JuanenRac/URTC/README_ita.md

<p align="center">
  URTC banner
</p>

# 🚀 URTC — Universal Robot Tool Controller

<p align="center">
  <a href="README.md">🇺🇸 English</a> |
  <a href="README_spa.md">🇪🇸 Español</a> |
  <a href="README_fra.md">🇫🇷 Français</a> |
  🇮🇹 <b>Italiano</b> |
  <a href="README_deu.md">🇩🇪 Deutsch</a> |
  <a href="README_zho.md">🇨🇳 简体中文</a> |
  <a href="README_jpn.md">🇯🇵 日本語</a> |
  <a href="README_por.md">🇵🇹 Português</a>
</p>

### Il controllore delle teste utensile di un braccio robotico: una scheda STM32F303 con 25 profili utensile su CAN, un bootloader CAN e uno slave di espansione

<p align="center">
  
  
  
  
  
  
</p>

---

**Stato: 🚧 Progetto in evoluzione attiva — esistono release, ma nulla è mai stato eseguito su una scheda reale.** Esistono release con tag (v0.3.x), ciascuna con le immagini firmware compilate da questo codice sorgente, ma non esiste alcuna scheda popolata, quindi il firmware non è mai stato eseguito su una scheda reale. URTC è in sviluppo continuo e attivo su entrambi i fronti contemporaneamente: firmware (nuovi profili strumento, l'ecosistema di espansione slave, cambi di protocollo) e hardware (schematico e distinta base ancora in fase di finalizzazione, nessuna scheda popolata esiste ancora). Poiché entrambi i lati si muovono insieme, ciò che si trova in questo repository in un dato momento è un'istantanea del lavoro in corso, non un prodotto stabile e versionato - nomi di file, struttura delle cartelle, numero di strumenti, e documentazione possono ancora tutti cambiare man mano che il progetto si assesta. Una volta che sia firmware che hardware raggiungeranno uno stato genuinamente stabile e verificato su hardware reale, verrà taggata una vera **Release** che raggrupperà tutto insieme (firmware, bootloader, strumenti PC, file di progettazione hardware, e documentazione) come un'istantanea coerente e congelata. Fino ad allora, considera `main` come l'obiettivo in continuo movimento che è.

---

> **⚠️ Avviso di sicurezza (fase di progetto, nessuna scheda ha ancora eseguito questo firmware):** questa scheda pilota un **diodo laser da incisione da 10 W** e più stadi di riscaldamento (cartuccia per saldatore T12, hotend per stampante 3D). Costruirla e usarla significa lavorare con apparecchiature che possono causare **ustioni, incendi o danni agli occhi** se assemblate o utilizzate senza le adeguate misure di sicurezza (occhiali protettivi con classificazione adatta alla lunghezza d'onda del diodo, protezione termica, un interruttore di alimentazione accessibile). Questo è un progetto hobbistico/maker condiviso così com'è - costruiscilo e usalo a tuo rischio, e non saltare le pratiche di sicurezza di base solo perché il firmware ha dei watchdog (watchdog software mai eseguiti su una scheda reale).

> **Stato di sicurezza (safety e security):** questo ecosistema non è un sistema di sicurezza certificato e non esiste ancora alcuna scheda URTC assemblata. Il bootloader della scheda principale verifica le immagini firmware con CRC32 e una firma Ed25519 rispetto a una tabella di chiavi pubbliche e non custodisce alcun segreto; il bootloader dell'espansione slave controlla CRC32 e un SHA-256 senza chiave e installa solo un'immagine che la scheda principale, che verifica il record Ed25519, gli ha confermato tramite il bus di collegamento interno (si fida della scheda principale attraverso quel bus). La tabella della build ufficiale è vuota finché non viene creata la chiave di firma delle immagini, quindi un bootloader principale ufficiale non installa ancora nulla, e una build da banco si fida di una chiave pubblica di sviluppo, così chiunque può produrre un'immagine che un tale bootloader accetta; nulla è stato trasmesso a una scheda reale. Leggi la [base di sicurezza](https://github.com/JuanenRac/URTC-DOCS/blob/main/docs/SECURITY_BASELINE.md) e il [modello delle minacce](https://github.com/JuanenRac/URTC-DOCS/blob/main/docs/THREAT_MODEL.md) prima di fidarti di qualsiasi affermazione qui per la sicurezza di una persona.

## 📋 In breve

| | |
|---|---|
| Versione | `0.4.9` |
| Maturità | Funzionale |
| Tecnologia | STM32F303 / bxCAN / 25 tool profiles |
| Destinazione | Una scheda con microcontrollore (il firmware); compilato su un PC |
| Su hardware reale | Non ancora: per questa versione non risulta alcuna esecuzione su hardware reale |

**Vai a:** [Panoramica](#-panoramica) · [Architettura](#-architettura) · [Funzionalità](#-funzionalità) · [Sicurezza](#-sicurezza-e-protezione) · [Interfacce](#-interfacce) · [Avvio rapido](#-avvio-rapido) · [Test](#-test) · [Struttura](#-struttura-del-repository) · [Correlati](#-progetti-correlati)

<!-- urtc-section:status_firmware -->
## 🚦 Stato del progetto

🟢 fatto e verificato · 🟡 funziona, con limiti noti · 🟠 a metà o non verificato · 🔴 non fatto o non funzionante. Nulla è verde se non ha mai girato su hardware reale.

| Parte | Stato | Ciò che il repository può dimostrare |
| --- | :---: | --- |
| Software | 🟡 | Compila e supera i test su PC; la prova su una testa utensile reale è ancora da fare. |
| Test | 🟢 | La suite di test passa nella CI a ogni push. |
| Hardware reale | 🟠 | Nessuna esecuzione su una scheda reale: la prova al banco è ancora da fare. |
| Sicurezza | 🟡 | Le versioni sono firmate con Ed25519 e verificate prima dell'uso; la gestione delle chiavi non è stata rivista da nessun altro. |
| Interfaccia e protocolli | 🟡 | Le rotte o i messaggi offerti sono documentati e provati con un client; non tutti i client li hanno ancora usati |
| Aggiornamenti | 🟠 | Le immagini si aggiornano sul bus CAN con il bootloader; un aggiornamento firmato, una firma alterata e un id hardware estraneo sono provati con il bootloader compilato per il PC, mai su una scheda |
| Documentazione | 🟡 | README in otto lingue e documenti di riferimento; le traduzioni non sono state riviste da madrelingua. |

<!-- /urtc-section:status_firmware -->

## 🎯 Panoramica

Ciao a tutti! Volevo condividere un progetto a cui sto lavorando chiamato URTC (Universal Robot Tool Controller). È una scheda di controllo monolitica e altamente integrata, progettata specificamente per espandere le capacità di bracci robotici e impianti di automazione, il che la rende perfetta per piattaforme come PAROL6 e Faze4 - due bracci robotici open-source progettati e sviluppati da [Source-Robotics](https://source-robotics.com/) ([GitHub](https://github.com/Source-Robotics)).

**URTC è un progetto indipendente e non ufficiale.** Non è sviluppato né approvato da Source-Robotics - è un controller di tool-head compatibile, costruito per funzionare bene con PAROL6 e Faze4, e la stessa architettura basata su CAN è aperta ad essere adattata anche ad altre piattaforme di bracci robotici.

Qui trovi la descrizione completa di cosa sia, cosa faccia, e l'ecosistema hardware che attualmente gestisce.

URTC è una scheda di controllo tutto-in-uno e compatta, alimentata da un microcontrollore STM32 (STM32F303CCT6, LQFP48). Comunica con il controller principale del robot via bus CAN, pensata per eseguire con bassa latenza compiti complessi direttamente al tool-head o all'asse (la latenza non è mai stata misurata su una scheda e non si promette un vero tempo reale). Include un display OLED integrato per diagnostica istantanea - splash di avvio animato, icone animate per ogni strumento, telemetria dal vivo su un pannello a due toni - un singolo LED RGB di stato più un anello di LED RGB indirizzabili per l'illuminazione della fotocamera, un connettore di espansione a 20 pin per schede aggiuntive, una F-RAM integrata che mantiene i setpoint dello strumento attivo attraverso una perdita di alimentazione, e stadi di alimentazione dedicati, analogici e ad alta corrente.

## 🧩 Ruolo in URTC

URTC è la scheda e il suo firmware: la parte dell'ecosistema che sta sulla testa utensile del robot e fa il lavoro, con un bootloader CAN che permette di aggiornare l'applicazione con lo stesso cavo. Tutto il resto della famiglia è costruito intorno ad essa. URTC-COMMON scrive il suo protocollo CAN una volta sola come dati, URTC-FLASHER e URTC-TESTER la aggiornano e la esercitano da un PC (URTC-WEB-STUDIO fa entrambe le cose in un browser), URTC-GATEWAY può mettersi davanti al suo bus, URTC-SMART-RACK custodisce le teste, URTC-VISION-TOOL è una testa che ispeziona, URTC-UPDATER tiene aggiornati i programmi e URTC-DOCS conserva l'architettura e ciò che è provato. È pensata per bracci robotici come PAROL6 e Faze4 ed è un progetto indipendente e non ufficiale. Non esiste ancora nessuna scheda montata.

## 🏛️ Architettura

<p align="center">
  Architettura di URTC: chi lo usa, che cosa contiene e da che cosa dipende
</p>

Come si incastrano le parti di questo repository: chi lo usa, che cosa contiene e da che cosa dipende. L'immagine è disegnata da `docs/architecture.json` e verificata rispetto al codice.

### Architettura Scalabile e Matrice degli Strumenti

Il punto di forza principale di URTC è la sua estrema versatilità. Invece di sostituire l'elettronica per ogni lavoro diverso, la scheda presenta un'architettura a matrice scalabile:

* **Schema di identificazione a 32 indirizzi:** l'hardware e il protocollo di comunicazione sono progettati per identificare fino a 32 strumenti o end-effector diversi direttamente sulla testa del robot, tramite una matrice ID a jumper di saldatura a 5 bit (ID0-ID4). Di queste 32 letture, 31 mappano direttamente su un profilo strumento; la 32ª (tutti e 5 i jumper installati, `11111`) è riservata invece come indirizzo di "configurazione libera" - vedi sotto.
* **25 profili automatizzati plug-and-play:** il firmware gestisce nativamente 25 profili strumento - la scheda legge l'identità fisica del tool-head e configura gli stadi di alimentazione, i sensori, e la commutazione logica senza soluzione di continuità, senza necessità di un ri-flash completo. 6 indirizzi in più rimangono liberi nello schema esistente per futuri profili strumento.
* **Configurazione libera dello strumento:** la lettura riservata dei jumper `11111` non seleziona uno strumento fisso - dice alla scheda di ricercare quale strumento usare da un registro nella propria F-RAM persistente, impostato in anticipo via CAN (tramite `URTC Flasher`). Utile per una scheda che necessita di essere riprogrammata su uno strumento diverso senza risaldare fisicamente i jumper. Vedi `docs/EEPROM.TXT` sezione 5 per il meccanismo completo.

### Struttura della memoria flash (256K totali, modello di aggiornamento golden-image / A-B)

```
0x08000000 ┌─────────────────────────────────┐
           │  Bootloader (30K)                 │  Viene sempre eseguito per primo ad ogni avvio.
           │                                   │  Ascolta brevemente sul CAN, poi o
           │                                   │  salta all'app o attende un
           │                                   │  aggiornamento. Pilota l'OLED direttamente
           │                                   │  durante un aggiornamento (vedi sotto).
0x08007800 ├─────────────────────────────────┤
           │  Pagina metadati (2K)             │  Descrive qualsiasi cosa si trovi nello
           │                                   │  slot principale in questo momento: HardwareID,
           │                                   │  versione, dimensione, CRC32, e una
           │                                   │  firma SHA-256. Il
           │                                   │  bootloader verifica tutto questo
           │                                   │  prima di saltare mai all'app.
0x08008000 ├─────────────────────────────────┤
           │  Slot principale (112K)           │  Questo è il firmware applicativo /
           │                                   │  URTC_MAIN_FIRMWARE_v<version>.* — il firmware
           │                                   │  vero e proprio che gira giorno per giorno,
           │                                   │  descritto ovunque altrove in
           │                                   │  questo README. Mai toccato da
           │                                   │  un aggiornamento finché un'immagine
           │                                   │  verificata e nota come funzionante non è
           │                                   │  pronta a sostituirlo.
0x08024000 ├─────────────────────────────────┤
           │  Slot backup / staging (112K)     │  Solo archiviazione grezza, mai
           │                                   │  eseguito direttamente. Ogni
           │                                   │  aggiornamento CAN scrive qui per primo.
0x08040000 └─────────────────────────────────┘
```

**Perché uno slot di backup.** Un aggiornamento CAN non viene mai scritto nello slot attualmente in esecuzione. Va prima nel backup, viene completamente verificato lì - dimensione, CRC32, e una firma Ed25519 verificata rispetto alla tabella di chiavi pubbliche del bootloader, che mostra che è stato prodotto da chi possiede una chiave fidata, non solo che sia arrivato intatto - e solo dopo viene copiato nello slot principale. Una perdita di alimentazione in qualsiasi punto prima che quella copia inizi lascia il firmware attualmente in esecuzione completamente intatto, quindi non c'è finestra in cui un download interrotto possa rendere inutilizzabile la scheda. Se la perdita di alimentazione avviene *durante* la copia stessa, il bootloader se ne accorge al successivo avvio (il backup, mai toccato durante la copia, è ancora completamente intatto) e semplicemente riprende a copiare da lì finché non ha successo.

## 🖼️ Schermate

URTC v1.0

*(Lavoro in corso — altre angolazioni e una scheda popolata in arrivo presto.)*

## ✨ Funzionalità

### Flessibilità Hardware e Supporto Motori

Per gestire una varietà così ampia di applicazioni, l'hardware URTC è pienamente equipaggiato per controllare:

* **Motori passo-passo NEMA:** NEMA 8, 11, 14, e 17 funzionano direttamente sul TMC2209 integrato, così come NEMA 23 e 34 - fino a **2,0 A** su ciascuno di essi tramite lo stadio driver della scheda principale. Per NEMA 23/34 alla loro piena coppia nominale, un TMC5160 sul connettore di espansione (vedi sotto) supporta fino a **10 A**, scalati in corrente dai MOSFET/resistenza di sense esterni scelti per quella scheda - il limite integrato di 2,0 A non si applica una volta che un motore è stato spostato sul driver di espansione.
* **Motori BLDC trifase / gimbal** per movimento ad alta precisione.
* **Motori con sensori Hall e tachimetri** per controllo a circuito chiuso.
* **Ingressi dedicati** per sensori di prossimità ottici riflettenti come il TCRT5000, più un ingresso generico attivo-basso per finecorsa/limit-switch condiviso tra quattro profili strumento.

### Connettore di Espansione

Un header a 20 pin, separato dai connettori specifici per strumento, per schede aggiuntive che necessitano più di quanto un dato profilo strumento da solo esponga - un asse a passo aggiuntivo (TMC2209 o TMC5160), una seconda scheda sensore, cose di questo tipo.

| Pin | Segnale |
|---|---|
| 4 | 24 V |
| 1 | 3,3 V |
| 1 | 5 V |
| 3 | GND |
| 2 | I2C bit-banged (SCL/SDA) — proprio bus separato, distinto dall'I2C2 hardware di OLED/F-RAM |
| 3 | STEP/DIR/EN — universale per entrambi i chip driver sotto |
| 4 | SPI bit-banged (CS/SCK/MISO/MOSI) — per l'interfaccia di configurazione/diagnostica di un TMC5160, o qualsiasi altro chip configurabile via SPI |
| 1 | GPIO generico (ingresso di interrupt capace di EXTI se un futuro add-on necessita una risposta sensore rapida, es. un finecorsa) |
| 1 | TMC5160 DIAG0 (linea di diagnostica stallo/guasto, interrogata via `0x182`/`0x183`) |

20 pin totali.

**Due bus I2C separati, di proposito:** OLED/F-RAM usano l'unica periferica hardware I2C utilizzabile di questo chip (I2C2, su PA9/PA10); il connettore di espansione ottiene il proprio bus I2C bit-banged, indipendente (PB10/PB11 - le uniche altre coppie di pin capaci di I2C su questo chip erano già impegnate per altre funzioni, quindi il bit-banging era il modo per dare a questo connettore un proprio bus senza un conflitto hardware). Qualsiasi cosa collegata all'header di espansione - un ADC/DAC I2C, un port expander, qualsiasi cosa una data scheda add-on necessiti - condivide questo bus bit-banged con qualsiasi altro dispositivo I2C lato espansione, ma non può allungare il clock (clock stretching) né altrimenti interferire con la temporizzazione propria dell'OLED sul suo bus hardware separato I2C2.

**Un TMC2209 o un TMC5160, non necessariamente entrambi.** Entrambi i chip usano la stessa interfaccia STEP/DIR/EN per il movimento vero e proprio, quindi quella parte è universale. Dove differiscono è nella configurazione/diagnostica: un TMC2209 usa la propria UART a filo singolo per questo, mentre un TMC5160 usa SPI - e poiché i due sono mutuamente esclusivi su una data scheda di espansione, i 4 pin SPI fungono anche naturalmente da sede per la linea UART singola di un TMC2209, invece di richiedere un ulteriore pin dedicato che nessuno userebbe contemporaneamente al bus SPI. Il bus SPI bit-banged parla esattamente il protocollo che un TMC5160 si aspetta (SPI Modalità 3, MSB per primo, CS mantenuto basso per l'intera transazione - vedi `0x180`/`0x181` in `docs/CANBUS.TXT` per il comando generico di byte-passthrough che lo pilota) invece che questo firmware debba conoscere il layout specifico dei registri di quel chip. Anche la linea DIAG0 di stallo/guasto di un TMC5160 è cablata (`0x182`/`0x183`) - riutilizza uno dei due pin GPIO generici, che erano già stati destinati esattamente a questo tipo di ingresso rapido guidato da interrupt.

Il dettaglio completo pin per pin - quale pin dell'MCU sostiene quale segnale, e il ragionamento dietro un paio di vincoli di layout che il package a 48 pin di questo chip ha - vive in `docs/PINOUT_CONNECTORS.TXT` e `src/F303-master/README.md`.

#### Le 6 varianti di scheda di espansione

4 delle 6 varianti di scheda di espansione portano un driver per motore passo-passo - o un TMC2209 (fino a 2A/bobina, MOSFET di potenza integrati) o un TMC5160A (fino a 10A+/bobina, richiede 8 MOSFET di potenza esterni che il driver stesso non include). Indipendentemente da questa scelta di driver, una scheda con driver è o **basic** (driver + connettori soltanto, nessun MCU - STEP/DIR/EN instradati direttamente dalla scheda principale) o **advanced** (aggiunge un secondo microcontrollore, STM32F303CBT6, più 2 chip sensore locali - un ADC 16-bit ADS1115 e una termocamera della famiglia MLX9064x - e generazione locale di PWM per strumenti la cui temporizzazione necessita di essere generata direttamente sul tool-head anziché instradata via cavo). 2×2 combinazioni, più altre 2 schede basic solo-sensore (ADS1115 o MLX9064x, cablate direttamente allo STM32F303CC della scheda principale stessa, nessun driver e nessun MCU slave) per uno strumento che necessita solo di uno di quei 2 chip e nient'altro che una scheda advanced porta anch'essa - 6 schede in totale - vedi `BOM/BOM_EXPANSION_*.TXT` (6 file), `docs/EXPANSION.TXT`, e `docs/PINOUT_SLAVE.txt`.

Lo STM32F303CBT6 della variante advanced parla con la scheda principale attraverso il bus I2C bit-banged esistente del connettore di espansione sopra - scheda principale come master, chip slave che risponde come vero slave hardware I2C - e pilota il proprio secondo bus I2C, solo locale, per i 2 chip sensore. Ha un proprio bootloader e firmware applicativo, aggiornato allo stesso modo della scheda principale (CAN-OTA da `URTC Flasher`), semplicemente ritrasmesso attraverso quel collegamento I2C piuttosto che raggiungendo direttamente il chip slave. Vedi `src/F303-slave/README.md` e `src/F303-slave/boot/README.md` per il dettaglio tecnico completo.

### Persistenza dei Parametri

Una F-RAM FM24CL64B integrata (64Kbit, I2C) mantiene un'istantanea aggiornata periodicamente dei setpoint dello strumento attivo e delle impostazioni globali di LED/OLED, così una perdita improvvisa di alimentazione non lascia "cosa stava facendo questa scheda" tanto ignoto quanto lo era stata la perdita stessa, imprevista. Condivide il bus hardware I2C2 dell'OLED anziché ottenerne uno proprio - questo MCU ha una sola periferica hardware I2C utilizzabile per questo scopo, già impegnato dall'OLED (vedi `src/F303-master/README.md` sezione 6 per il ragionamento completo).

**Lo stato recuperato è interrogabile, mai applicato automaticamente a nulla di pericoloso.** All'avvio, qualsiasi cosa fosse stata salvata diventa leggibile via CAN (`0x190`/`0x191`) - ma un setpoint del riscaldatore, la potenza del laser, o un comando motore non vengono mai riarmati silenziosamente da soli. Solo le impostazioni sicure e passive (colori LED, modalità OLED) vengono ripristinate direttamente. Reinviare deliberatamente un setpoint dopo aver effettivamente esaminato cosa sia successo resta una decisione del controller master, non qualcosa che questa scheda decide da sola nell'istante in cui torna l'alimentazione.

### Catalogo Strumenti Automatizzati Nativamente (25 Profili Firmware)

Tramite la sua logica di commutazione dinamica, il firmware gestisce nativamente i seguenti tool-head:

1. **Stazione Saldante (T12):** controllo di temperatura con isteresi (on/off, non PID) usando feedback ADC diretto per gestire punte saldanti T12 standard, più un alimentatore motorizzato di filo che spinge il filo di stagno nel giunto (condivide `CONN_MOT` e il proprio protocollo stepper con gli strumenti a solo movimento sotto - cede il proprio ingresso finecorsa generico per fargli spazio). [Config jumper/cablaggio →](images/TOOL_SOLDERING_IRON.png)
2. **Dispenser di Pasta Saldante SMT:** controllo di alimentazione millimetrico per deposizione precisa di pasta saldante su PCB. [Config jumper/cablaggio →](images/TOOL_PASTE_DISPENSER.png)
3. **Dispenser di Pasta Termica / Liquido:** gestione della fluidità per paste ad alta viscosità o adesivi liquidi. [Config jumper/cablaggio →](images/TOOL_LIQUID_DISPENSER.png)
4. **Cacciavite Elettrico Intelligente:** controllo di rotazione e arresto tramite l'interfaccia stepper. Previsto: arresto su limiti di coppia (non esiste ancora alcuna misura della coppia). [Config jumper/cablaggio →](images/TOOL_SCREWDRIVER.png)
5. **Pinza a Vuoto / Pneumatica:** controllo della pompa a vuoto e lettura del livello di pressione per operazioni sicure di Pick-and-Place. [Config jumper/cablaggio →](images/TOOL_VACUUM_PICKUP.png)
6. **Trapano (BL4260):** controllo di velocità PWM, inversione di direzione, e frenata elettrica dinamica con letture RPM dal vivo, sulla propria linea dedicata di enable/freno, indipendente dall'enable del driver stepper. Ingresso finecorsa generico disponibile. [Config jumper/cablaggio →](images/TOOL_DRILL.png)
7. **Pinza Gimbal:** manipolazione ad alta sensibilità usando motori brushless gimbal trifase. [Config jumper/cablaggio →](images/TOOL_GRIPPER_GIMBAL.png)
8. **Pinza NEMA:** forza di serraggio robusta controllata tramite un motore stepper heavy-duty. [Config jumper/cablaggio →](images/TOOL_GRIPPER_NEMA.png)
9. **Sistema AOI (Ispezione Ottica Automatizzata):** controllo stroboscopico sincrono dell'array LED di illuminazione per la cattura della fotocamera di visione artificiale. Ingresso finecorsa generico disponibile. [Config jumper/cablaggio →](images/TOOL_AOI_INSPECTION.png)
10. **Diodo Laser da Incisione (10W ottici):** modulazione PWM della potenza del fascio con un watchdog CAN software che blocca l'uscita laser se la comunicazione con l'host viene persa (compilato, mai eseguito su una scheda reale e non sostituisce un interblocco hardware indipendente). Ingresso finecorsa generico disponibile. [Config jumper/cablaggio →](images/TOOL_LASER_ENGRAVER.png)
11. **Hotend di Stampa 3D:** controllo on/off con isteresi della cartuccia riscaldante, lettura del termistore NTC, controllo dell'estrusore, e una ventola dedicata di raffreddamento layer controllata via PWM a 25kHz (4 fili, feedback tachimetrico, watchdog di comunicazione proprio) - tutto integrato in un unico blocco. [Config jumper/cablaggio →](images/TOOL_3D_PRINTER.png)
12. **Sonda per Scanner 3D:** ingresso hardware a interrupt ultra-rapido (EXTI) con priorità assoluta per digitalizzazione della superficie in tempo reale e rilevamento urti senza ritardo. Copre anche il tastatore metrologico - stesso percorso hardware, una sonda fisica diversa sullo stesso tool-head. [Config jumper/cablaggio →](images/TOOL_SCAN_PROBE.png)
13. **Testa Pick & Place SMT:** asse rotativo A per il corretto allineamento dei pad, sulla stessa interfaccia stepper dei dispenser pasta/liquido e di entrambe le pinze sopra. [Config jumper/cablaggio →](images/TOOL_SMT_PICKPLACE.png)
14. **Elettromagnete Heavy-Duty:** controllo di presa on/off per parti ferromagnetiche, dall'uscita del riscaldatore T12 riutilizzata come driver GPIO generico. [Config jumper/cablaggio →](images/TOOL_ELECTROMAGNET.png)
15. **Testa Saldatrice a Punti:** impulsi di saldatura con precisione al millisecondo per strisce di nickel di battery-pack, con un sensore di contatto superficiale che regola l'impulso. [Config jumper/cablaggio →](images/TOOL_SPOT_WELDER.png)
16. **Aerografo per Coating Conforme:** controllo dello spray di rivestimento protettivo per PCB finiti - la valvola dello spray e il proprio sensore si trovano sulla scheda madre del robot, fuori dall'ambito di questa scheda. [Config jumper/cablaggio →](images/TOOL_CONFORMAL_COATING.png)
17. **Pinza a Vuoto per Grande Formato:** array multi-ventosa per schede FR4 non popolate, sulla stessa interfaccia stepper dello strumento #13 sopra. [Config jumper/cablaggio →](images/TOOL_VACUUM_GRIPPER_LG.png)
18. **Testa di Test Funzionale:** test di tensione/continuità a sonda volante - lettura base tramite l'ADC integrato, lettura avanzata tramite un ADC 16-bit ADS1115 su una scheda di espansione **advanced**. [Config jumper/cablaggio →](images/TOOL_FLYING_PROBE.png)
19. **Testa di Cura UV:** driver LED UV ad alta potenza per la cura istantanea di colla/maschera. [Config jumper/cablaggio →](images/TOOL_UV_CURING.png)
20. **Ugello per Rilavorazione ad Aria Calda:** elemento riscaldante, soffiatore a turbina, e feedback della termocoppia per rifusione di componenti SMD disallineati - condivide il proprio loop di controllo termico con il saldatore. [Config jumper/cablaggio →](images/TOOL_HOTAIR_REWORK.png)
21. **Inseritore Pneumatico Press-Fit:** controllo attuatore lineare per pressare connettori nei PCB - l'attuatore e il proprio sensore si trovano sulla scheda madre del robot, fuori dall'ambito di questa scheda. [Config jumper/cablaggio →](images/TOOL_PRESSFIT_INSERTER.png)
22. **Attuatore di Cablaggio/Crimpatura:** ganascia ad alta coppia per spellare/crimpare terminali, pilotata dal driver proprio di una **scheda di espansione** piuttosto che da quello della scheda principale. Il firmware non ha alcuna misura di coppia o di forza. [Config jumper/cablaggio →](images/TOOL_CRIMPING_ACTUATOR.png)
23. **Ispezione Avanzata PCB:** termografia (array della famiglia MLX9064x - tutti e 3 i membri della famiglia, MLX90640/MLX90641/MLX90642, supportati oggi, sia tramite il chip slave proprio di una scheda di espansione **advanced** sia tramite una scheda di espansione **basic** MLX9064x cablata direttamente alla scheda principale) per individuare cortocircuiti tramite firma termica, insieme all'illuminazione ad anello LED. Copre anche la depanellizzazione con micro-mandrino - stesso percorso hardware del trapano sopra, un bit diverso per un lavoro diverso. [Config jumper/cablaggio →](images/TOOL_THERMAL_INSPECTION.png)
24. **Valvola di Jetting Pasta Saldante:** erogazione micro-goccia piezoelettrica, precisione di impulso sub-millisecondo generata localmente su una scheda di espansione **advanced**. [Config jumper/cablaggio →](images/TOOL_PASTE_JETTING.png)
25. **Saldatrice a Ultrasuoni / Sigillatrice per Confezionamento:** trigger a trasduttore ad alta frequenza per saldatura di involucri in plastica. [Config jumper/cablaggio →](images/TOOL_ULTRASONIC_WELDER.png)

*(Le immagini di configurazione strumento esistono per gli strumenti 1-12; le immagini per gli strumenti 13-25 verranno popolate man mano che la documentazione hardware si aggiorna - i nomi file sopra corrispondono alla convenzione di denominazione già in uso in `images/`.)*

### Interfaccia OLED Locale

Ogni tool-head mostra telemetria dal vivo, specifica per lo strumento, su un OLED a due toni 128×64: uno splash di avvio animato all'accensione, un indicatore lampeggiante di attività CAN, una lettura "hero" dal vivo nella striscia superiore (temperatura, RPM, potenza - qualsiasi cosa sia più importante per lo strumento attivo), e una piccola icona animata a quattro fotogrammi per profilo strumento.

#### Il modulo

Entrambe le varianti fisiche sotto sono lo stesso pannello elettricamente (pilotato da SSD1306 o SSD1315 - la sequenza di init del firmware è verificata compatibile con entrambi, vedi `OLED_Init()` in `firmware_oled_driver.c`; l'SSD1315 è un controller sostitutivo più recente, drop-in, con cui molti moduli vengono venduti oggi sotto lo stesso listino/serigrafia "SSD1306"), **128×64**, e la stessa suddivisione a due toni "giallo/blu", dove il materiale LED fisico stesso è diviso in due zone a colore fisso (questo non è selezionabile via software):

* **16 pixel superiori (pagine 0-1): giallo.** URTC usa questa striscia per qualsiasi cosa sia più utile vedere a colpo d'occhio senza leggere attentamente - l'indicatore di attività CAN, letture hero dal vivo, o (sullo splash di avvio / schermate di strumento non valido) breve testo di stato.
* **48 pixel inferiori (pagine 2-7): blu.** Tutto il resto - icone strumento, telemetria dettagliata, il volto animato JuanenBOT sulla schermata splash, la grande scritta lampeggiante ERROR.

Entrambi finiscono sullo stesso bus I2C2 e sullo stesso `OLED_Init()` - il firmware non può distinguere quale dei due sia collegato, e non ne ha bisogno. Sono mutuamente esclusivi su una data scheda (vedi la nota di `CONN_OLED2` in `BOM/BOM.TXT` - il nome usato in questo documento per ciò che lo schematico chiama `LCD1`).

##### Opzione A — montaggio diretto (`CONN_OLED2`, il footprint effettivamente popolato sulla scheda)



Un pannello nudo senza scheda breakout separata - solo il vetro e il suo nastro FPC a 30 pin, saldato direttamente nel footprint `CONN_OLED2` (`FPC30`, WiseChip UG-2864, il nome usato in questo documento per ciò che lo schematico chiama `LCD1` - vedi `BOM/BOM.TXT` e `URTC_NETLIST.TXT`). Dei 30 pin, solo un sottoinsieme è effettivamente cablato - il resto è il bus a interfaccia parallela del pannello (`D2`–`D7`, `RW`, `E/!RD`), lasciato non connesso poiché la scheda parla con esso solo via I2C:

| Pin(s) di CONN_OLED2 | Rete | Funzione |
|---|---|---|
| 1, 8, 29, 30 | GND / AGND | Massa |
| 9 | VDD | Alimentazione logica (da `+3V3B`, la rail dedicata solo all'OLED - vedi BOM §1) |
| 28 | VCC | Alimentazione pannello |
| 2–5 | C2P/C2N/C1P/C1N | Condensatori charge-pump — `C26`/`C27` nella distinta base |
| 26 | IREF | Resistore di impostazione corrente di riferimento |
| 27 | VCOMH | Disaccoppiamento tensione comune interna |
| 10, 12 | BS0, BS2 | Collegati a GND |
| 11 | BS1 | Collegato a `+3V3B` |
| 18 | D0/SCK | I2C2 SCL — PA9 |
| 19 | D1/DIN/SDA | I2C2 SDA — PA10 |

`BS0`/`BS1`/`BS2` sono lo strap proprio di selezione interfaccia del pannello (GND/VCC/GND qui), fisso via hardware anziché esposto all'MCU - è questo che mette il controller in modalità I2C fin dall'inizio, anziché nella modalità parallela 8080/6800 a cui appartengono gli altri 22 pin FPC.

##### Opzione B — modulo breakout (`CONN_OLED`, alternativa esterna)



Lo stesso pannello pre-montato su una piccola scheda carrier con un header a 4 pin - utile se preferisci cablare un modulo pronto all'uso piuttosto che procurarti il pannello FPC nudo. Cablato direttamente a `CONN_OLED` senza necessità di incrocio - l'ordine dei pin proprio del modulo (`GND · VDD · SCK · SDA`) corrisponde esattamente, pin per pin, al pinout di `CONN_OLED`:

| Pin modulo OLED | Pin CONN_OLED | Segnale |
|---|---|---|
| GND | 1 | Massa |
| VDD | 2 | +3,3 V (alimentazione logica display) |
| SCK | 3 | SCL — PA9, I2C2 hardware |
| SDA | 4 | SDA — PA10, I2C2 hardware |

#### Splash di avvio



#### Icone strumenti (una per profilo, animazione a 4 fotogrammi)

<table>
<tr>
<td align="center"><br>Saldatore T12</td>
<td align="center"><br>Dispenser Pasta</td>
<td align="center"><br>Dispenser Liquido</td>
<td align="center"><br>Cacciavite</td>
</tr>
<tr>
<td align="center"><br>Pinza a Vuoto</td>
<td align="center"><br>Trapano (BL4260)</td>
<td align="center"><br>Pinza Gimbal</td>
<td align="center"><br>Pinza NEMA</td>
</tr>
<tr>
<td align="center"><br>Ispezione AOI</td>
<td align="center"><br>Incisore Laser</td>
<td align="center"><br>Hotend Stampante 3D</td>
<td align="center"><br>Sonda Scanner 3D</td>
</tr>
<tr>
<td align="center"><br>SMT Pick & Place</td>
<td align="center"><br>Elettromagnete</td>
<td align="center"><br>Saldatrice a Punti</td>
<td align="center"><br>Coating Conforme</td>
</tr>
<tr>
<td align="center"><br>Pinza a Vuoto (LG)</td>
<td align="center"><br>Sonda Volante</td>
<td align="center"><br>Cura UV</td>
<td align="center"><br>Rilavorazione Aria Calda</td>
</tr>
<tr>
<td align="center"><br>Inseritore Press-Fit</td>
<td align="center"><br>Attuatore Crimpatura</td>
<td align="center"><br>Ispezione Termica</td>
<td align="center"><br>Jetting Pasta</td>
</tr>
<tr>
<td align="center"><br>Saldatrice Ultrasuoni</td>
</tr>
</table>

#### Avviso ID strumento non valido

Se i jumper ID non corrispondono a nessuno dei 25 profili assegnati, la scheda blocca ogni attuatore e lampeggia invece questo:



Tutte le GIF sorgente delle animazioni vivono in [`/ani`](ani/).

### LED di Stato Digitale

Separato dall'OLED e dall'anello di illuminazione a 8 pixel, `CONN_LED1` porta un singolo LED RGB indirizzabile (famiglia WS2812B, pilotato via SPI/DMA) dedicato allo stato a colpo d'occhio.

**Automatico di default, sovrascrivibile dall'host a richiesta.** Il firmware colora questo LED da solo, con priorità a tre vie:

* 🔴 **Rosso** — un guasto hardware è attivo (`system_error_flag`). Vince sempre, indipendentemente da qualsiasi altra cosa in corso.
* 🔵 **Blu** — la scheda sta funzionando attivamente: un frame CAN (qualsiasi ID) è arrivato negli ultimi 1,5 secondi.
* 🟢 **Verde** — inattiva, in attesa di comandi: nessun traffico CAN da oltre 1,5 secondi.

Il master può comunque sovrascrivere questo in qualsiasi momento inviando l'ID CAN `0x100` (DLC 8) con l'intensità di rosso, verde, e blu come primi tre byte (0-255 ciascuno - colore 24-bit completo, non solo i tre automatici). Un colore inviato dall'host resta attivo per 10 secondi prima di tornare allo schema automatico - abbastanza lungo da essere effettivamente visto, abbastanza breve perché la scheda non resti bloccata a mostrare un colore personalizzato obsoleto se l'host smette di aggiornarlo. Inviare di nuovo `0x100` (sia lo stesso colore che uno nuovo) rinnova questa finestra di 10 secondi, quindi un host che vuole mantenere il controllo personalizzato deve semplicemente continuare a inviarlo periodicamente. Un guasto hardware interrompe sempre un override attivo - il rosso ha priorità su qualsiasi colore che l'host avesse impostato.

Vedi `docs/CANBUS.TXT` (ID `0x100`) per il layout esatto dei byte, che condivide anche questo stesso messaggio con il controllo dell'anello LED e della modalità notturna dell'OLED.

## 🔒 Sicurezza e protezione

- **Protezione dalla fuga termica** (`thermal_guard.c`, dall'applicazione 0.3.2) su saldatore / aria calda e hotend 3D: un MAXTEMP sulla temperatura *misurata* (449 °C T12, 310 °C hotend), un controllo di riscaldamento (la temperatura deve salire davvero con il riscaldatore acceso - rileva un termistore o una punta allentati) e un controllo di mantenimento (raggiunto il target, nessun calo prolungato con il riscaldatore acceso). Un guasto spegne il riscaldatore, blocca l'errore della scheda e ne indica la causa nel byte 4 di `0x111`. Testato sull'host con un riscaldatore simulato (`tests/test_thermal_guard.c`). I suoi limiti non sono mai stati misurati su un riscaldatore reale e nulla di tutto ciò è mai stato eseguito su una scheda.
- **Test host della logica del firmware intorno all'hardware** (`tools/run_host_tests.py`, 61 suite): oltre a bootloader, protezione termica e dispatcher, i veri gestori CAN dei 13 utensili (`firmware_can_*.c`), i cicli di controllo del riscaldatore (`firmware_control_thermal.c`: conversione ADC, letture impossibili, limiti del setpoint, isteresi, riscaldatore bloccato, i guasti della protezione), il registratore di guasti (`firmware_blackbox.c`, confrontato byte per byte con gli scenari che URTC-COMMON scrive dal suo modello, e la sua lettura CAN), l'identificazione dell'utensile dai ponticelli, i comandi dopo la porta di errore e i comandi della termocamera sono compilati contro una HAL finta (`tests/host_hal/`) ed eseguiti con i sanitizer di indirizzi e comportamento indefinito e `gcc -fanalyzer`; `--coverage-floor` (`URTC_COVERAGE_FLOOR` nella CI) li vincola a una quota di righe eseguite (94,0 per cento delle righe degli 83 sorgenti del firmware che le suite compilano (3 su 88 richiedono la scheda e 2 contengono solo dati, gli slot dell'intestazione), che ora comprendono l'avvio e il ciclo principale dell'applicazione, il driver dell'OLED e le sue schermate, il LED di stato, i gestori di interruzione, i bus del connettore di espansione, le tre termocamere, lo slave di espansione e i programmi principali dei due bootloader; la soglia della CI è 90). Nulla di tutto ciò è girato su una scheda.
- **Diagnostica:** il byte 5 di `0x111` indica la causa dell'ultimo reset (bit0 = è intervenuto il watchdog hardware); `0x1AA`/`0x1AB` restituiscono contatori di vita salvati in F-RAM - guasti termici, codice dell'ultimo guasto e tempo totale con il riscaldatore acceso (dalla 0.3.3); i campioni della scatola nera registrano il codice di guasto termico.
- **Firma del firmware:** il bootloader della scheda principale non custodisce alcun segreto: verifica un record Ed25519 rispetto a una tabella di chiavi pubbliche (`keys/image_trust.json`), compilata come tabella da banco con una chiave pubblica di sviluppo o come tabella ufficiale, vuota finché non viene creata la chiave di firma delle immagini. Il bootloader dell'espansione slave non contiene alcuna chiave di firma nel suo percorso di aggiornamento: installa un'immagine solo quando la scheda principale, dopo aver verificato il record Ed25519, gli conferma esattamente quell'immagine in quella sessione di aggiornamento, e si fida della scheda principale attraverso il bus di collegamento interno (vedi [`docs/SLAVE_BOOT_CONFIRMATION.md`](docs/SLAVE_BOOT_CONFIRMATION.md)); non contiene alcuna chiave né routine HMAC e conserva il proprio contatore anti-rollback firmato in un registro di sola aggiunta, che anche la scheda principale legge e fa rispettare. Ogni immagine in `firmware/` viene fornita con `<bin>.sha256` e `<bin>.manifest.json`, quindi URTC Flasher e URTC Web Studio non portano alcuna chiave. Vedi [`docs/FIRMWARE_SIGNING.TXT`](docs/FIRMWARE_SIGNING.TXT). Ogni file di una release ufficiale porta anche una firma di release Ed25519 separata (`<file>.sig`, chiave pubblica in [`docs/RELEASE_SIGNING.md`](docs/RELEASE_SIGNING.md)); il flasher e il web studio la verificano quando è presente.
- **L'intestazione nell'immagine:** le immagini dell'applicazione portano la propria identità in 32 byte all'offset fisso `0x200`, dopo la tabella dei vettori: l'hardware a cui sono destinate, la versione con quattro componenti, la lunghezza e il CRC-32 dell'intera immagine. Il firmware emette lo slot (`firmware_image_slot.c`, `slave_image_slot.c`) e lo script del linker lo colloca, facendo fallire il link se la tabella dei vettori non finisce prima; `tools/seal_image.py` compila lunghezza e CRC-32 dopo il link. La mappa della flash, la tabella dei vettori e la lunghezza dell'immagine non cambiano, il record di firma si fa esattamente come prima sul file sigillato e i bootloader non cambiano. Niente di tutto ciò è girato su una scheda.
- **Bus CAN:** non autentica il mittente - qualsiasi nodo può comandare gli utensili. Le installazioni con laser, riscaldatori o saldatrici **devono** avere un interblocco hardware indipendente dal microcontrollore e un bus chiuso: [`docs/CAN_THREAT_MODEL.TXT`](docs/CAN_THREAT_MODEL.TXT).
- **Più teste utensile su uno stesso bus CAN (disattivato per impostazione predefinita):** un interruttore persistente (CAN `0x1AC` lo imposta, `0x1AD` lo legge, il record in F-RAM è descritto in [`docs/EEPROM.TXT`](docs/EEPROM.TXT)) attiva gli indirizzi di nodo ricavati dai cinque jumper ID, la scoperta e una regola di selezione: solo la testa selezionata obbedisce ai comandi, una testa non selezionata non aziona mai nulla. Con l'interruttore spento, che è il valore predefinito e anche ciò che legge una F-RAM vuota, la scheda si comporta esattamente come una singola testa e i frame e gli identificatori non cambiano. Implementato nel firmware e provato solo su computer; non provato su schede. Il progetto e i frame sono in URTC-COMMON (`docs/MULTINODE.md`) e nell'appendice di [`docs/CANBUS.TXT`](docs/CANBUS.TXT).
- **Cosa risponde il bootloader e il numero di patch dello slave:** la rilettura (`0x7FE`) e l'autorizzazione al downgrade (`0x7FD`) ricevono risposta solo in una sessione del bootloader avviata dall'applicazione accettando `0x7F0` (o su una scheda senza applicazione valida); dopo un'accensione vengono ignorate, e un'opzione di compilazione lo disattiva. Lo slave di espansione invia il numero di patch nel decimo byte del suo registro di versione e il master lo inoltra in `0x222` (un byte 0 significa non inviato, come con uno slave più vecchio), seguito dal byte basso del numero minor in un terzo byte, così un programma può mostrare la versione completa. Nei sorgenti e provato sull'host; nessuna immagine del firmware lo contiene ancora.

## 🔌 Interfacce

**Velocità del bus CAN:** il bus delle teste utensile funziona a **1 Mbit/s** (il valore è scritto una sola volta, in `spec/can_protocol.json` di URTC-COMMON; il firmware e il bootloader ne calcolano la temporizzazione per il clock del chip: velocità esatta, punto di campionamento all'87,5 per cento, mai sotto il 75 per cento). 500 kbit/s resta l'opzione storica per le schede vecchie: compilare con `URTC_CAN_LEGACY_500K=1`. **Nota di compatibilità:** tutte le schede e gli adattatori di uno stesso bus devono andare alla stessa velocità (un bus che mescola le velocità non funziona e gli strumenti lo segnalano); a 1 Mbit/s il tronco deve restare sotto circa 25 m, con derivazioni di pochi centimetri e una terminazione da 120 ohm a ogni estremità, mentre 500 kbit/s tollera circa 100 m. Nulla di tutto questo è stato eseguito su un bus reale.

Una volta che il bootloader è in posizione, aggiornare l'applicazione non richiede più affatto accesso fisico alla scheda - basta inviare la nuova build firmware sulla stessa linea CAN che già porta i comandi al tool-head.

**La sequenza di aggiornamento:**

1. **Trigger.** Il master invia `0x7F0` (DLC 4, payload `B0 07 1D 5A`) all'*applicazione in esecuzione*. Questo taglia in sicurezza l'alimentazione a ogni attuatore inline - motori, riscaldatori, laser - e resetta il chip. Questo requisito di payload magico fa sì che un frame corrotto o malformato non possa attivare accidentalmente un reset in modalità aggiornamento.
2. **Avvio.** Dopo il reset, il bootloader sta ascoltando. Il master invia `0x7F1` (DLC 8, dimensione totale del firmware big-endian + HardwareID big-endian). Un'immagine costruita per hardware diverso viene rifiutata proprio qui, prima che un singolo byte di flash venga toccato. Il bootloader cancella esattamente tante pagine dello slot di backup quante ne servono alla nuova immagine e risponde con un frame di stato (`0x7F5`).
3. **Firma.** Il master invia il record Ed25519 di 76 byte (id della chiave, contatore anti-rollback, firma) come 11 frame `0x7EC` (un indice e 7 byte ciascuno) prima dei dati, in qualsiasi ordine; viene calcolato sulla macchina del mantenitore dopo la build, su un'intestazione che descrive l'immagine, il suo SHA-256 e il contatore. Il bootloader contiene solo chiavi pubbliche, quindi leggerlo non dà a nessuno il potere di firmare; la tabella di chiavi ufficiale è vuota finché non viene creata la chiave di firma delle immagini, e una build da banco si fida di una chiave pubblica di sviluppo (vedi `docs/FIRMWARE_SIGNING.TXT`).
4. **Dati.** Il master trasmette il file `.bin` come una sequenza di frame `0x7F2` (fino a 8 byte di dati firmware grezzi ciascuno), inviati uno dopo l'altro - il CAN garantisce che i frame arrivino nell'ordine in cui sono state inviate su un singolo bus, quindi non serve alcun numero di sequenza per frame. Il bootloader mette in buffer i byte in arrivo in una pagina di 2KB in RAM e la scrive nello slot di *backup* una volta piena, rileggendo ogni half-word e confrontandola con ciò che era destinato a essere scritto prima di considerare completata la pagina, e inviando una conferma `0x7F3` (con l'indice di pagina) dopo ogni scrittura verificata. Un'implementazione master ragionevole attende la conferma di ogni pagina prima di inviare i dati della pagina successiva, per evitare di sovraccaricare il buffer di ricezione del bootloader.
5. **Fine e verifica.** Una volta che ogni byte è stato inviato, il master invia `0x7F4` (DLC 8, CRC32 big-endian + versione major/minor). Il bootloader controlla la dimensione dello slot di backup, calcola il proprio CRC32 e verifica il record Ed25519 rispetto a ciò che il master ha dichiarato. Solo se tutto corrisponde procede a copiare il backup nello slot principale, pagina per pagina, con la stessa verifica a rilettura di sopra. Una volta che quella copia è completa e confermata, salva i nuovi metadati e si resetta nell'applicazione aggiornata. Su qualsiasi discrepanza - dimensione, CRC32, firma, o HardwareID - lo slot principale non viene mai toccato affatto, e il bootloader semplicemente torna ad ascoltare per un nuovo tentativo.

**Frame di stato (`0x7F5`, DLC 1):** `0x01` in ascolto, `0x02` in cancellazione, `0x03` in ricezione, `0x06` in verifica, `0x07` copia backup in principale, `0x04` verificato OK (sta per saltare), `0x05` verifica fallita, `0xFF` errore.

**Heartbeat (`0x7F6`, DLC 2, ogni ~1s mentre ascolta o aggiorna):** byte di stato + percentuale di avanzamento (0-100, o `0xFF` dove una percentuale non si applica). Permette al master di distinguere "il nodo è vivo ma non ha ancora iniziato ad ascoltare" da "il nodo è completamente privo di risposta" - utile per l'avvio automatizzato e per individuare un bootloader bloccato senza dover attendere un timeout.

**Avanzamento a schermo.** Il bootloader pilota l'OLED direttamente durante un aggiornamento - nessuno deve indovinare se qualcosa sta succedendo. Mostra "UPDATING" più una barra di avanzamento e percentuale dal vivo mentre le pagine vengono scritte o copiate, "FLASH OK" per un istante prima di resettarsi nel nuovo firmware, e "ERROR" se una scrittura di pagina fallisce, il trasferimento si blocca per più di 10 secondi, o la verifica torna con una discrepanza.

**⚠️ Testalo su banco prima di fidartene sul campo.** Il protocollo sopra compila e linka senza problemi e la logica è stata ragionata con attenzione, ma un bootloader è esattamente il tipo di firmware in cui "compila correttamente" è ben lontano da "affidabile sull'hardware" - la temporizzazione reale di programmazione flash, il comportamento CAN attraverso un trasferimento di migliaia di frame, e il passaggio di consegne bootloader-applicazione devono tutti essere verificati su una scheda reale (idealmente con JTAG a portata di mano come ripiego) prima di fare affidamento su questo per un aggiornamento non presidiato con attuatori reali collegati.

## 🚀 Avvio rapido

La flash di URTC è divisa in due parti indipendenti, così la scheda può essere riprogrammata sullo stesso cavo CAN che già usa per tutto il resto - senza mai più necessitare di accesso fisico all'header JTAG/SWD dopo la configurazione iniziale.

### Configurazione iniziale — richiede JTAG/SWD (una tantum)

Il bootloader può arrivare sul chip solo tramite programmazione fisica - non c'è modo di programmare via CAN una scheda che non ha ancora un bootloader su di essa. Questo è un passo una tantum:

1. Apri il progetto in **STM32CubeIDE** (compilato e testato contro il target STM32F303CC), o usa **STM32CubeProgrammer** direttamente con gli output compilati sotto.
2. Programma **entrambe** le immagini via SWD (ST-Link) tramite l'header integrato `STM_JTAG` - ogni file `.hex` ha il proprio indirizzo di destinazione incorporato, così la maggior parte degli strumenti (incluso STM32CubeProgrammer) può caricare entrambi nella stessa sessione:
   * `URTC_MAIN_BOOTLOADER_v<version>.hex` → `0x08000000`
   * `URTC_MAIN_FIRMWARE_v<version>.hex` → `0x08008000`
3. Imposta l'identità dello strumento tramite i jumper di saldatura ID prima di accendere - la scheda li legge una volta all'avvio, come sempre. Cinque jumper (ID0-ID4), che coprono l'intero spazio di 32 indirizzi (31 indirizzi diretti per strumento, più l'indirizzo riservato `11111` di configurazione libera - vedi la sezione Matrice degli Strumenti sopra).
4. Accendi. Il bootloader ascolta per ~600ms, non vede nulla, e salta direttamente nell'applicazione - da qui in avanti, tutto si comporta esattamente come descritto nel resto di questo README. La finestra inizia dopo che il bootloader ha controllato l'applicazione memorizzata, e uno strumento che vuole aggiornare deve inviare al suo interno il frame di avvio aggiornamento (0x7F1); lo stato di ascolto (0x7F5 = 0x01) viene inviato quando la finestra termina senza salto, non al suo inizio.

**L'header JTAG non viene mai rimosso né disabilitato.** È sempre lì come ripiego - se un aggiornamento CAN va mai storto, o semplicemente lo preferisci, puoi riflashare entrambe le immagini via SWD in qualsiasi momento.

**Due pulsanti integrati, BOOT e RESET**, sono presenti anche per il recupero - RESET è un reset hardware ordinario (`NRST`), e BOOT porta `BOOT0` alto, che è una decisione a livello di chip presa *prima* che qualsiasi cosa in questo repository venga eseguita: normalmente (non tenuto premuto) il chip si avvia dalla flash nel bootloader proprio di questo progetto come descritto sopra; tenuto premuto al reset, si avvia invece nel bootloader di System Memory di fabbrica proprio di ST (USB DFU/recupero UART, completamente separato da qualsiasi cosa qui). Vedi `src/F303-master/README.md` sezione 4a per il dettaglio tecnico completo.

### Strumenti PC

Due strumenti GUI standalone, multipiattaforma (Windows/Linux), supportano questa
scheda - **URTC Flasher** (aggiornamenti CAN-OTA e a chip completo via SWD/JTAG, sia
per questa scheda che, su una variante di espansione Advanced, per il proprio
chip slave di espansione) e **URTC Tester** (un esercitatore di bus CAN dal vivo
che mostra qualunque profilo strumento sia attualmente selezionato via jumper). Entrambi vivevano
in precedenza in questo repository sotto `tools/`; ognuno è ora un proprio
progetto indipendente, con proprio README, licenza, e traduzioni:

- [URTC Flasher](https://github.com/JuanenRac/URTC-FLASHER)
- [URTC Tester](https://github.com/JuanenRac/URTC-TESTER)

Esiste anche un'alternativa basata sul web che copre terreno simile (monitoraggio dal vivo, analisi CAN, programmazione OTA, ispezione termica) senza installare nulla localmente: [URTC Web Studio](https://github.com/JuanenRac/URTC-WEB-STUDIO).

<!-- urtc-section:compatibility -->
### Requisiti e compatibilità

Quali versioni dei programmi URTC funzionano insieme, e quale versione del protocollo parla ciascuna, è elencato nella tabella di compatibilità generata da URTC-COMMON: [docs/COMPATIBILITY.md](https://github.com/JuanenRac/URTC/blob/main/docs/COMPATIBILITY.md). Le note di una versione dei repository che includono `tools/changelog_section.py` (il firmware, il flasher, il tester e l'updater) sono la sezione del CHANGELOG di quella versione seguita da questa tabella: `python tools/changelog_section.py VERSION --compat`.
<!-- /urtc-section:compatibility -->

## 🧪 Test

La logica del firmware attorno all'hardware è testata su un computer: `python tools/run_host_tests.py` compila ed esegue 61 suite di test in C (`tests/test_*.c`) con il compilatore del computer, una HAL finta e i sanitizer AddressSanitizer e UBSan con `-fanalyzer`: i bootloader, la protezione termica, il dispatcher, i veri gestori CAN dei 13 utensili, gli anelli di controllo dei riscaldatori e la scatola nera, tra gli altri. La CI compila e collega anche i quattro binari e fallisce sotto una soglia di copertura delle righe eseguite dei sorgenti del firmware. Niente di tutto questo è girato su una scheda: non esiste nessuna scheda montata, e i test sul computer non possono dimostrare che tempi, driver o stadi di potenza funzionino. `python tools/c_quality.py` aggiunge tre controlli che il compilatore della scheda non fa: il compilatore del computer con `-Wconversion` su ogni sorgente che le suite costruiscono, cppcheck e un limite alla lunghezza dei blocchi di commento (i driver dei sensori importati così come sono restano esclusi, ciascuno con il suo motivo in `tools/c_quality.json`).

## 🏗️ Compilazione e rilascio

### Compilazione dai sorgenti (opzionale — i binari precompilati sono asset di ogni release GitHub, non file del repository)

Due modi per passare dai sorgenti di questo repository ai 4 binari sopra:

- **Automatizzato:** `build_firmware.sh` (Linux) o `build_firmware.bat` (Windows), alla radice del repository. Ognuno installa la toolchain ARM GNU se manca, scarica il commit fissato di ST HAL/CMSIS, e compila, linka, e passa via `objcopy` tutti e 4 i binari (app + bootloader scheda principale, app + bootloader slave di espansione) direttamente in `firmware/`, poi rigenera `firmware/firmware_manifest.json`. Esegui senza argomenti per una build completa, `--clean` per svuotare prima la cache locale `build/`, o `master`/`slave` per compilare solo la coppia propria di un chip. `build_firmware.sh` viene eseguito end-to-end contro il vero albero sorgente di questo progetto; `build_firmware.bat` rispecchia la stessa logica per Windows - se i due dovessero divergere, fidati della logica dello script `.sh` come riferimento.
- **Manuale:** ogni comando eseguito da entrambi gli script, più il ragionamento dietro ogni scelta di toolchain/HAL, è dettagliato passo passo in `docs/COMPILE_STM32F303.TXT` - utile su un sistema operativo diverso, con un sorgente HAL/CMSIS diverso, o semplicemente per vedere esattamente cosa gli script automatizzano.
- **Asset della release:** le immagini del firmware (`.bin`, `.hex`, `.elf` e i relativi file di checksum e manifest) non sono versionate in git. `build_firmware.sh`/`.bat` le scrivono in `firmware/` (ignorata da git; `build/firmware` in modalità CI, `URTC_CI=1`), e `python tools/publish_release_assets.py` controlla l'insieme e stampa il comando `gh release create` esatto con i file da allegare. Sono pubblicate solo come asset della release GitHub di ogni versione. Chi legge cosa: [`docs/FIRMWARE_DISTRIBUTION.md`](docs/FIRMWARE_DISTRIBUTION.md).

Dopo qualsiasi modifica al sorgente firmware (o prima di fidarsi di un incremento di versione), esegui **`check_version_consistency.sh`** dalla radice del repository: legge le costanti di versione delle linee A/E (firmware scheda principale, applicazione slave di espansione) come riferimento autorevole e controlla ogni posizione che `VERSION_CHECKLIST.txt` documenta per quel tag di versione, segnalando qualsiasi discrepanza - segnala soltanto, non corregge nulla da solo. `VERSION_CHECKLIST.txt` è il riferimento completo per tutte e 5 le linee di versione indipendenti di questo progetto (firmware principale, hardware/PCB, bootloader principale, applicazione slave di espansione, bootloader slave di espansione) ed esattamente cosa va toccato quando si incrementa uno qualsiasi di essi.

Firmware e bootloader sono versionati e rilasciati indipendentemente -
flashare un nuovo bootloader non implica una nuova versione dell'applicazione e
viceversa, quindi ognuno ha la propria cronologia nel proprio file piuttosto che
un unico numero di versione combinato che implicherebbe che si muovano sempre
insieme:

- Firmware (`src/F303-master/`): [`src/F303-master/CHANGELOG.md`](src/F303-master/CHANGELOG.md)
- Bootloader (`src/F303-master/boot/`): [`src/F303-master/boot/CHANGELOG.md`](src/F303-master/boot/CHANGELOG.md)
- Applicazione Slave di Espansione (`src/F303-slave/`, STM32F303CBT6): [`src/F303-slave/CHANGELOG.md`](src/F303-slave/CHANGELOG.md)
- Bootloader Slave di Espansione (`src/F303-slave/boot/`): [`src/F303-slave/boot/CHANGELOG.md`](src/F303-slave/boot/CHANGELOG.md)

**Versioni:** i quattro componenti (due firmware applicativi e due bootloader: `FIRMWARE_VERSION_MAJOR`/`MINOR`/`PATCH` e `BOOTLOADER_VERSION_MAJOR`/`MINOR`/`PATCH`) hanno versioni indipendenti. La versione di ciascuno viene alzata solo dal passo esplicito `python bump.py` (che usa `bump_version.py` nella radice del repository); compilare non cambia mai una versione. Ogni bootloader conserva inoltre una propria copia dei `FIRMWARE_VERSION_*` dell'applicazione corrispondente, tenuta allineata dallo stesso passo. Vedi [`CHANGELOG.md`](CHANGELOG.md) nella radice per la versione attuale dei 4 componenti a colpo d'occhio, e [`VERSION_CHECKLIST.txt`](VERSION_CHECKLIST.txt) per la meccanica di ogni linea.

## 📂 Struttura del repository

<p align="center">
  Struttura del repository URTC
</p>

<details>
<summary>Versione testuale dell'albero</summary>

```text
URTC/
├── src/                                               i quattro componenti firmware e ciò che condividono
├── PCB/                                               lo schema e il progetto della scheda
├── BOM/                                               distinte base della scheda e delle sei di espansione
├── 3D/                                                modelli 3D
├── ani/                                               le animazioni dell'OLED
├── keys/                                              solo chiavi pubbliche, mai una privata
├── docs/                                              protocollo CAN, piedinature, firma, modello delle minacce, datasheet
├── tests/                                             61 suite di test host in C
├── tools/                                             esecutore dei test host, strumenti di release, controlli condivisi
├── images/                                            banner e immagini di questo README
├── .github/                                           workflow di CI e modelli per issue e pull request
├── build-test.sh build-test.bat                       script di compilazione e test che non cambiano nulla nel repository
├── test.sh test.bat                                   eseguono i test
├── urtc.project.json                                  manifesto: versione, ruolo, maturità e comando di compilazione
├── CHANGELOG.md                                       che cosa è cambiato in ogni versione
├── SECURITY.md SUPPORT.md LICENSE                     politica di sicurezza, supporto e licenza
├── CONTRIBUTING.md CODE_OF_CONDUCT.md                 come contribuire e codice di condotta
├── .gitattributes .gitignore                          impostazioni di Git
├── build_firmware.sh build_firmware.bat               compila i quattro binari
├── bump.py bump_version.py bump_manifest_version.py   script che alzano la versione
├── check_version_consistency.sh                       controlla ogni posto che indica una versione
├── check_shared_drivers.py                            controlla le copie dei driver condivisi
├── firmware_signing.py                                firma le immagini
├── generate_manifest.py                               scrive il manifesto di un'immagine
├── VERSION_CHECKLIST.txt                              la meccanica delle quattro versioni
└── LICENSE.md ruff.toml mypy.ini                      licenza dell'hardware, impostazioni di lint e di controllo dei tipi
```

</details>

L'elenco annotato di ogni file sorgente, una riga per file, è in [docs/SOURCE_MAP.md](docs/SOURCE_MAP.md).

## 🗺️ Roadmap e limiti noti

**Firmware (`src/F303-master/`):** funzionalmente completo per tutti i 25 profili strumento - controllo termico on/off con isteresi, telemetria per strumento, watchdog di comunicazione, rilevamento stallo/guasto, e la diagnostica dal vivo propria dell'OLED, insieme a una coppia di interrogazione dello strumento attivo (`0x110`/`0x111`), un passthrough SPI generico (`0x180`/`0x181`) per il connettore di espansione, una F-RAM integrata che mantiene i setpoint attraverso una perdita di alimentazione (`0x190`/`0x191`), il meccanismo di configurazione libera dello strumento tramite jumper `11111` (`0x1A2`/`0x1A3`), la segnalazione del tipo di periferica + numero seriale del dispositivo (`0x1A4`/`0x1A5`) per distinguere più schede altrimenti identiche su un bus condiviso, e un bridge CAN-a-I2C (`0x210`-`0x221`) che raggiunge il chip slave di espansione sulle schede di espansione advanced. Versionato indipendentemente dal bootloader (vedi il Changelog sotto). Nulla di tutto ciò è mai stato eseguito su una scheda reale e la protezione termica è testata solo sull'host con un riscaldatore simulato.

**Bootloader (`src/F303-master/boot/`):** sistema di aggiornamento A/B a golden-image funzionalmente completo - aggiornamenti OTA via CAN verificati con CRC32 e una firma Ed25519 rispetto a una tabella di chiavi pubbliche, uno slot di backup che garantisce che un aggiornamento fallito non renda mai inutilizzabile la scheda, e la propria segnalazione di versione (`0x7FA`) indipendente dall'applicazione. Compila e linka senza problemi; vedi l'avvertenza sul test da banco sopra prima di fidartene non presidiato con attuatori reali collegati.

**Strumenti PC:** sia [URTC Flasher](https://github.com/JuanenRac/URTC-FLASHER) (aggiornamenti CAN OTA + programmazione a chip completo via SWD/JTAG) che [URTC Tester](https://github.com/JuanenRac/URTC-TESTER) (esercitatore dal vivo di controllo/telemetria per strumento) sono funzionalmente completi per ciò che si erano proposti di fare, ognuno ora un proprio progetto indipendente con un proprio README che copre configurazione e ogni controllo in dettaglio.

**Hardware:** schematico e distinta base sono ancora in fase di finalizzazione; nessuna scheda popolata esiste ancora per validare quanto sopra contro silicio reale. Tutto quanto sopra compila, linka, ed è stato ragionato con attenzione, ma "compila correttamente" e "verificato sull'hardware" sono due affermazioni diverse - vedi l'avviso di sicurezza in cima a questo README, e tratta un primo bring-up con la cautela che qualsiasi scheda nuova merita.

Se qualcuno nella community sta lavorando su end-effector personalizzati, cambia-utensili intelligenti, o integrazione avanzata di strumenti per PAROL6, Faze4, o qualsiasi altra piattaforma di braccio robotico, mi piacerebbe chiacchierare, scambiare idee, o approfondire i comandi CAN!

## 🌍 Lingue

Il README e i testi esistono in inglese, spagnolo, francese, italiano, tedesco, cinese, giapponese e portoghese europeo.

## 🔗 Progetti correlati

URTC è fatto di repository indipendenti, ciascuno con la propria versione, i propri test e il proprio README. Ecco la famiglia, per gruppi:

* **URTC Tool Platform:**
  * **URTC** (questo repository) - firmware della scheda della testa utensile (25 profili utensile, bootloader CAN) e riferimento del protocollo CAN.
  * [URTC-COMMON](https://github.com/JuanenRac/URTC-COMMON) - il protocollo CAN scritto una sola volta come dati (specifica, tabelle generate, vettori di conformità) e il codice condiviso dai programmi.
  * [URTC-FLASHER](https://github.com/JuanenRac/URTC-FLASHER) - strumento desktop che aggiorna il firmware della scheda via CAN o via SWD/JTAG.
  * [URTC-GATEWAY](https://github.com/JuanenRac/URTC-GATEWAY) - gateway davanti al bus CAN: lascia passare solo gli identificatori di un elenco, ne limita la frequenza e chiede una chiave di sessione.
  * [URTC-SMART-RACK](https://github.com/JuanenRac/URTC-SMART-RACK) - logica C indipendente dall'hardware e protocollo di comandi per un portautensili con preriscaldamento e tracciamento del ciclo di vita.
  * [URTC-TESTER](https://github.com/JuanenRac/URTC-TESTER) - tester desktop del bus CAN in tempo reale che mostra i comandi e la telemetria del profilo utensile segnalato da una scheda.
  * [URTC-VISION-TOOL](https://github.com/JuanenRac/URTC-VISION-TOOL) - protocollo di frame del sensore in C e un companion Python termico/RGB per una testa utensile di ispezione.
  * [URTC-WEB-STUDIO](https://github.com/JuanenRac/URTC-WEB-STUDIO) - app per browser che programma e collauda la scheda via Web Serial e SLCAN, senza installare nulla.
* **Ecosystem Operations:**
  * [URTC-DEVTOOLS](https://github.com/JuanenRac/URTC-DEVTOOLS) - gli strumenti di repository condivisi della famiglia come un insieme versionato, con un file di lock che distingue una copia modificata da una rimasta indietro.
  * [URTC-DOCS](https://github.com/JuanenRac/URTC-DOCS) - architettura, interfacce, base di sicurezza e catalogo generato dell'ecosistema, più gli strumenti che confrontano tutti i repository.
  * [URTC-UPDATER](https://github.com/JuanenRac/URTC-UPDATER) - strumento desktop che rileva, installa e aggiorna i repository della famiglia URTC, un'azione esplicita alla volta.

**Progetti fratelli (indipendenti, con la stessa base e gli stessi strumenti):**

* **[HYDRA-UMC-DOCS](https://github.com/JuanenRac/HYDRA-UMC-DOCS)** - progetto fratello: il centro di documentazione di HYDRA-UMC, un ecosistema indipendente che condivide base e strumenti con questo
* **[ARMOR-DOCS](https://github.com/JuanenRac/ARMOR-DOCS)** - progetto fratello: il centro di documentazione di A.R.M.O.R., l'ecosistema di sicurezza, anch'esso indipendente e sulla stessa base
* **[JuanenRac](https://github.com/JuanenRac/JuanenRac)** - il profilo e il pannello di stato di tutti gli ecosistemi

## 📚 Documentazione

- **[CONTRIBUTING.md](CONTRIBUTING.md)** — stack tecnologico e linee guida di codifica per una pull request.
- **[CODE_OF_CONDUCT.md](CODE_OF_CONDUCT.md)** — gli standard di comportamento attesi in questa comunità.
- **[SECURITY.md](SECURITY.md)** — come segnalare una vulnerabilità, e le reali aree di attenzione sulla sicurezza di questo progetto.
- **[SUPPORT.md](SUPPORT.md)** — dove porre domande e segnalare bug.
- **[LICENSE.md](LICENSE.md)** — la licenza propria di questo progetto.

## 🤝 Contribuire e comunità

* Prima di una pull request esegui `URTC_CI=1 python tools/ci_validate.py`: deve passare. Vedi [CONTRIBUTING.md](CONTRIBUTING.md) e il [codice di condotta](CODE_OF_CONDUCT.md).
* Il README esiste in otto lingue: una modifica del testo si fa in tutti e otto i file, e le sezioni condivise con altri repository le scrive `tools/readme_sections.py` di URTC-COMMON.
* Non descrivere come funzionante su una scheda ciò che è stato solo compilato.
* Segnala una vulnerabilità in privato: [SECURITY.md](SECURITY.md). Domande, idee e segnalazioni: electrohobby3d@gmail.com ([SUPPORT.md](SUPPORT.md)).

## 👤 AUTORE

**JuanenRac** (Electro Hobby 3D)
📧 electrohobby3d@gmail.com
📺 [youtube.com/@electrohobby3d](https://youtube.com/@electrohobby3d)

## 📜 LICENZA

URTC è (c) 2026 JuanenRac (Electro Hobby 3D). Questa nota deve essere inclusa in qualsiasi distribuzione di questo progetto o lavoro derivato.

Poiché questo progetto è composto da diversi tipi di contenuto, le singole parti sono rese disponibili sotto licenze diverse - ciascuna adatta a ciò che effettivamente copre, piuttosto che forzare un'unica licenza ad adattarsi a tutto:

1. Il **firmware** situato in `./firmware` (applicazione e bootloader CAN allo stesso modo) è disponibile sotto la **GNU General Public License v3.0 (GPL-3.0-or-later)**. Testo completo su https://www.gnu.org/licenses/gpl-3.0.html.

2. I **progetti hardware** (file schematico/board Eagle, gerber, e le parti stampabili in 3D sotto `./PCB` e `./3D`) sono disponibili sotto la **CERN Open Hardware Licence v2 - Strongly Reciprocal (CERN-OHL-S v2)**. Testo completo su https://cern-ohl.web.cern.ch/.

3. La **documentazione** (questo README e le proprie traduzioni - `README_spa.md`, `README_ita.md`, `README_fra.md`, `README_deu.md`, `README_zho.md`, `README_jpn.md` - più i file di riferimento sotto `./docs`) è disponibile sotto **Creative Commons Attribution-ShareAlike 4.0 International (CC BY-SA 4.0)**. Testo completo su https://creativecommons.org/licenses/by-sa/4.0/.

Se costruisci su questo progetto, tieni presente la separazione delle licenze: le modifiche al codice del firmware dovrebbero rimanere GPL-3.0-or-later, le modifiche all'hardware dovrebbero rimanere CERN-OHL-S, e i derivati della documentazione dovrebbero rimanere CC BY-SA - ciascuno con attribuzione a questo progetto.

Questo repository copre solo il firmware e l'hardware propri della scheda URTC - gli strumenti PC (URTC Flasher, URTC Tester) che vivevano qui in precedenza sono ora progetti indipendenti con licenza propria, vedi "Strumenti PC" sopra.
