JuanenRac/URTC/README_jpn.md

<p align="center">
  URTC banner
</p>

# 🚀 URTC — Universal Robot Tool Controller（v0.3）

<p align="center">
  <a href="README.md">🇺🇸 English</a> |
  <a href="README_spa.md">🇪🇸 Español</a> |
  <a href="README_fra.md">🇫🇷 Français</a> |
  <a href="README_ita.md">🇮🇹 Italiano</a> |
  <a href="README_deu.md">🇩🇪 Deutsch</a> |
  <a href="README_zho.md">🇨🇳 简体中文</a> |
  🇯🇵 <b>日本語</b> |
  <a href="README_por.md">🇵🇹 Português</a>
</p>

### ロボットアームのツールヘッドコントローラー：CAN で 25 種のツールプロファイルを扱う STM32F303 ボード、CAN ブートローダー、拡張スレーブ

<p align="center">
  
  
  
  
  
  
</p>

---

**状態：🚧 積極的に進化中のプロジェクト——リリースは存在しますが、実機のボードで動作したものはありません。** タグ付きリリース（v0.3.x）にはこのソースからビルドしたファームウェアイメージが含まれますが、実装済みのボードは存在しないため、ファームウェアが実機で動作したことはありません。URTC は、ファームウェア（新しいツールプロファイル、拡張スレーブのエコシステム、プロトコルの変更）とハードウェア（回路図と BOM はまだ最終決定されておらず、実装されたボードはまだ存在しません）の両面で同時に、継続的かつ積極的に開発が進められています。両側が一緒に動き続けているため、任意の時点で本リポジトリにあるものは、安定したバージョン管理された製品ではなく、進行中の作業のスナップショットです——ファイル名、フォルダー構造、ツール数、そしてドキュメントは、設計が落ち着くまですべて変わる可能性があります。ファームウェアとハードウェアの両方が本当に安定した、実機で検証された状態に達したら、すべて（ファームウェア、ブートローダー、PC ツール、ハードウェア設計ファイル、ドキュメント）を、一貫した凍結されたスナップショットとしてまとめた正式な **リリース** がタグ付けされます。それまでは、`main` を実際にそうであるところの、積極的に動き続ける対象として扱ってください。

---

> **⚠️ 安全上の注意（設計段階であり、このファームウェアを実行したボードはまだありません）：** 本ボードは**10W のレーザー彫刻ダイオード**と複数の加熱ステージ（T12 はんだごてカートリッジ、3D プリンターのホットエンド）を駆動します。これを組み立てて使用するということは、適切な安全対策（ダイオードの波長に対応したレーザーゴーグル、熱保護、手の届く電源遮断装置）なしに組み立てたり操作したりすると**火傷、火災、または眼の損傷**を引き起こしうる機器を扱うことを意味します。これは現状のまま共有されているホビイスト/メーカー向けのプロジェクトです——構築および使用は自己責任で行い、ファームウェアにウォッチドッグがあるからといって基本的な安全対策を省略しないでください（ソフトウェアのウォッチドッグであり、実機で動作したことはありません）。

> **安全性とセキュリティの現状：** このエコシステムは認証された安全システムではなく、実装済みの URTC ボードもまだ存在しません。メインボードのブートローダーは、ファームウェアイメージを CRC32 と公開鍵テーブルに対する Ed25519 署名で検証し、秘密を一切保持しません。拡張スレーブのブートローダーは CRC32 と鍵なしの SHA-256 を確認し、Ed25519 レコードを検証するメインボードが内部リンクバス経由で確認したイメージだけをインストールします（このバスを通じてメインボードを信頼します）。公式ビルドのテーブルはイメージ署名鍵が作成されるまで空のため、公式のメインブートローダーはまだ何もインストールしません。ベンチビルドは公開の開発用鍵を信頼するので、誰でもそのブートローダーが受け入れるイメージを作れます。実際のボードには何も送信されていません。ここに書かれた内容を人の安全のために頼る前に、[セキュリティベースライン](https://github.com/JuanenRac/URTC-DOCS/blob/main/docs/SECURITY_BASELINE.md)と[脅威モデル](https://github.com/JuanenRac/URTC-DOCS/blob/main/docs/THREAT_MODEL.md)をお読みください。

## 📋 ひと目で

| | |
|---|---|
| バージョン | `0.4.8` |
| 成熟度 | 機能する |
| 技術 | STM32F303 / bxCAN / 25 tool profiles |
| 対象 | マイコンボード（ファームウェア）。ビルドは PC で行います |
| 実機での確認 | まだです：このバージョンについて実機での動作記録はありません |

**移動先：** [概要](#-概要) · [アーキテクチャ](#-アーキテクチャ) · [機能](#-機能) · [セキュリティ](#-セキュリティと安全) · [インターフェース](#-インターフェース) · [クイックスタート](#-クイックスタート) · [テスト](#-テスト) · [構成](#-リポジトリの構成) · [関連](#-関連プロジェクト)

<!-- urtc-section:status_firmware -->
## 🚦 プロジェクトの状況

🟢 完了・検証済み · 🟡 動作するが既知の制限あり · 🟠 途中、または未検証 · 🔴 未実施または動作しない。実機で一度も動いていないものは緑になりません。

| 項目 | 状態 | リポジトリが示せること |
| --- | :---: | --- |
| ソフトウェア | 🟡 | ビルドと PC 上のテストは通ります。実際のツールヘッドでの動作確認は未実施です。 |
| テスト | 🟢 | テストスイートはプッシュごとに CI で通ります。 |
| 実機 | 🟠 | 実際のボードでの実行はまだありません。ベンチテストは未実施です。 |
| セキュリティ | 🟡 | リリースは Ed25519 で署名され、使用前に検証されます。鍵の扱いは他の人によるレビューを受けていません。 |
| インターフェースとプロトコル | 🟡 | 提供するルートやメッセージは文書化され、クライアントで試験済みです。すべてのクライアントがまだ使ったわけではありません |
| アップデート | 🟠 | イメージは CAN バス経由でブートローダーにより更新します。署名付き更新、改ざんされた署名、別ハードウェアの ID は PC 用にビルドしたブートローダーで試験済みで、実機では行っていません |
| ドキュメント | 🟡 | 8 言語の README と参照ドキュメントがあります。翻訳はネイティブによるレビューを受けていません。 |

<!-- /urtc-section:status_firmware -->

## 🎯 概要

こんにちは！私がずっと開発してきた URTC（Universal Robot Tool Controller）というプロジェクトを紹介したいと思います。これは、ロボットアームや自動化セットアップの能力を拡張するために特別に設計された、単一構造の高集積制御ボードです。[Source-Robotics](https://source-robotics.com/)（[GitHub](https://github.com/Source-Robotics)）が設計・開発した 2 つのオープンソースロボットアーム、PAROL6 と Faze4 のようなプラットフォームに最適です。

**URTC は独立した非公式プロジェクトです。** Source-Robotics によって開発または承認されたものではありません——PAROL6 と Faze4 とうまく連携するように構築された互換性のあるツールヘッドコントローラーであり、同じ CAN ベースのアーキテクチャは他のロボットアームプラットフォーム向けに適合させることにも開かれています。

以下は、それが何であるか、何をするか、そして現在管理しているハードウェアエコシステムの完全な内訳です。

URTC は、STM32 マイクロコントローラー（STM32F303CCT6、LQFP48）を搭載した、オールインワンのコンパクトな制御ボードです。CAN バス経由でメインのロボットコントローラーと通信し、ツールヘッドや軸のすぐそばで、複雑なタスクを低レイテンシーで実行することを意図しています（レイテンシーは実機で測定されたことがなく、厳密なリアルタイム性は保証しません）。即座の診断のための搭載の OLED ディスプレイ——アニメーション起動スプラッシュ、ツールごとのアニメーションアイコン、2 トーンパネル上のライブテレメトリ——単一ピクセルの RGB ステータス LED、カメラ照明用のアドレス指定可能な RGB LED リング、アドオンボード用の 20 ピン拡張コネクター、電源喪失時にもアクティブツールの設定値を保持する搭載の F-RAM、そして専用のアナログおよび大電流電源ステージを備えています。

## 🧩 URTC での役割

URTC はボードとそのファームウェアです。ロボットのツールヘッドに載って仕事をするエコシステムの部分で、同じケーブルでアプリケーションを更新できる CAN ブートローダーを備えています。ファミリーの他のものはすべてこれを中心に作られています。URTC-COMMON はその CAN プロトコルをデータとして一度だけ書き、URTC-FLASHER と URTC-TESTER は PC から更新と動作確認を行い（URTC-WEB-STUDIO はブラウザーで両方を行います）、URTC-GATEWAY はそのバスの前に置け、URTC-SMART-RACK はヘッドを保管し、URTC-VISION-TOOL は検査するヘッドで、URTC-UPDATER はプログラムを最新に保ち、URTC-DOCS はアーキテクチャと証明済みの内容を保持します。PAROL6 や Faze4 のようなロボットアーム向けで、独立した非公式のプロジェクトです。実装済みのボードはまだ存在しません。

## 🏛️ アーキテクチャ

<p align="center">
  URTC のアーキテクチャ：誰が使い、何を持ち、何に依存するか
</p>

このリポジトリの各部分の関係：誰が使い、何を持ち、何に依存するか。図は `docs/architecture.json` から描かれ、コードと照合されます。

### スケーラブルなアーキテクチャとツールマトリクス

URTC の核となる強みは、その極めて高い汎用性です。すべての異なる作業ごとに電子機器を交換するのではなく、本ボードはスケーラブルなマトリクスアーキテクチャを備えています：

* **32 アドレス識別方式：** ハードウェアと通信プロトコルは、5 ビットのはんだジャンパー ID マトリクス（ID0-ID4）を介して、ロボットヘッド上で直接最大 32 種類の異なるツールまたはエンドエフェクターを識別できるように設計されています。この 32 通りの読み取りのうち、31 通りは直接ツールプロファイルにマッピングされます。32 番目（5 つのジャンパーすべてが取り付けられた状態、`11111`）は代わりに「フリー構成」アドレスとして予約されています——下記参照。
* **25 種類のプラグアンドプレイ自動プロファイル：** ファームウェアは 25 種類のツールプロファイルをネイティブに処理します——ボードはツールヘッドの物理的な識別情報を読み取り、完全な再書き込みを必要とせずにシームレスに電源ステージ、センサー、ロジック切り替えを構成します。既存の方式の中に、将来のツールプロファイル用に 6 つのアドレスが空いたまま残っています。
* **フリーツール構成：** 予約された `11111` のジャンパー読み取りは固定のツールを選択するのではなく、代わりに、CAN 経由（`URTC Flasher` 経由）で事前に設定された、自身の永続的な F-RAM 内のレジスタからどのツールを使用するかを調べるようボードに指示します。物理的にジャンパーをはんだ付けし直すことなく、異なるツールへ再プログラムする必要があるボードに便利です。完全な仕組みは `docs/EEPROM.TXT` 第 5 節を参照してください。

### フラッシュメモリレイアウト（合計 256K、ゴールデンイメージ / A-B 更新モデル）

```
0x08000000 ┌─────────────────────────────────┐
           │  ブートローダー（30K）             │  すべての起動時に常に最初に実行。
           │                                   │  CAN で短時間リッスンし、その後
           │                                   │  アプリへジャンプするか、更新を
           │                                   │  待機する。更新中は OLED を直接
           │                                   │  駆動する（下記参照）。
0x08007800 ├─────────────────────────────────┤
           │  メタデータページ（2K）            │  現在メインスロットにある
           │                                   │  内容を記述：HardwareID、
           │                                   │  バージョン、サイズ、CRC32、
           │                                   │  そして SHA-256 署名。
           │                                   │  ブートローダーはアプリへ
           │                                   │  ジャンプする前に、これら
           │                                   │  すべてをチェックする。
0x08008000 ├─────────────────────────────────┤
           │  メインスロット（112K）            │  これはアプリケーション
           │                                   │  ファームウェア /
           │                                   │  URTC_MAIN_FIRMWARE_v<version>.* ——
           │                                   │  日々実行される実際の
           │                                   │  ファームウェアで、本
           │                                   │  README の他の場所で
           │                                   │  説明されているものです。
           │                                   │  検証済みの正常なイメージが
           │                                   │  それを置き換える準備が
           │                                   │  できるまで、更新によって
           │                                   │  触れられることはありません。
0x08024000 ├─────────────────────────────────┤
           │  バックアップ/ステージングスロット   │  生ストレージのみで、
           │  （112K）                          │  直接実行されることは
           │                                   │  ありません。すべての CAN
           │                                   │  更新は、まずここに書き込まれます。
0x08040000 └─────────────────────────────────┘
```

**バックアップスロットが必要な理由。** CAN 更新は、現在実行中のスロットに書き込まれることは決してありません。まずバックアップに書き込まれ、そこで完全に検証されます——サイズ、CRC32、そして単に完全に到着しただけでなく、信頼された鍵の保持者によって作られたことを示す、ブートローダーの公開鍵テーブルに対する Ed25519 署名の検証——そしてその後にのみメインスロットへコピーされます。そのコピーが始まる前のどの時点で電源が失われても、現在実行中のファームウェアはまったく影響を受けないままです。そのため、中断されたダウンロードがボードが使用不能になってしまう時間帯は存在しません。もしコピー*自体*の最中に電源が失われた場合、ブートローダーは次回の起動時にそれに気づき（バックアップはコピー中に決して触れられないため、依然として完全に無傷です）、成功するまでそこからコピーを単純に再開します。

## 🖼️ スクリーンショット

URTC v1.0

*（作業中——さらに多くのアングルと実装済みのボードは近日公開予定です。）*

## ✨ 機能

### ハードウェアの柔軟性とモーターサポート

これほど幅広いアプリケーションに対応するため、URTC のハードウェアは以下を制御する能力を完全に備えています：

* **NEMA ステッピングモーター：** NEMA 8、11、14、17 は搭載の TMC2209 から直接駆動され、NEMA 23 と 34 も同様です——メインボード自身のドライバーステージ経由で、いずれも最大 **2.0A** まで対応します。NEMA 23/34 が定格の全トルクを発揮するには、拡張コネクター上の TMC5160（下記参照）が最大 **10A** をサポートし、その電流は該当ボード向けに選ばれた外部 MOSFET/センス抵抗によってスケーリングされます——モーターが拡張ドライバーへ移動した時点で、搭載の 2.0A 制限は適用されなくなります。
* 高精度な動作のための**3 相ブラシレス／ジンバルモーター**。
* 閉ループ制御のための**ホールセンサーとタコメーター付きモーター**。
* TCRT5000 のような反射型光学近接センサー向けの**専用入力**に加え、4 つのツールプロファイル間で共有される汎用のアクティブロー方式のエンドストップ/リミットスイッチ入力。

### 拡張コネクター

特定のツールプロファイル単体が公開するもの以上を必要とするアドオンボード（追加のステッピング軸（TMC2209 または TMC5160）、2 つ目のセンサーボードなど）向けの、ツール専用コネクターとは別の 20 ピンヘッダーです。

| ピン数 | 信号 |
|---|---|
| 4 | 24V |
| 1 | 3.3V |
| 1 | 5V |
| 3 | GND |
| 2 | ビットバンギング I2C（SCL/SDA）——OLED/F-RAM のハードウェア I2C2 とは別の独自バス |
| 3 | STEP/DIR/EN——以下のどちらのドライバーチップにも共通 |
| 4 | ビットバンギング SPI（CS/SCK/MISO/MOSI）——TMC5160 の構成/診断インターフェース、または他の SPI 構成可能なチップ向け |
| 1 | 汎用 GPIO（将来のアドオンが高速なセンサー応答を必要とする場合、例えばエンドストップ向けの EXTI 対応割り込み入力） |
| 1 | TMC5160 DIAG0（失速/障害診断ライン、`0x182`/`0x183` 経由でポーリング） |

合計 20 ピン。

**意図的に分離された 2 つの I2C バス：** OLED/F-RAM はこのチップの唯一使用可能なハードウェア I2C ペリフェラル（PA9/PA10 上の I2C2）を使用します。拡張コネクターは独自の、独立したビットバンギング I2C バス（PB10/PB11——このチップの他に I2C 対応可能なピンペアはすでに他の機能に割り当てられていたため、ビットバンギングがハードウェアの競合なしにこのコネクターに独自バスを与える方法でした）を取得します。拡張ヘッダーにぶら下がるもの（I2C ADC/DAC、ポートエクスパンダー、特定のアドオンボードが必要とするもの）は、他の拡張側 I2C デバイスとこのビットバンギングバスを共有しますが、OLED 自身の独立したハードウェア I2C2 バス上のタイミングを、クロックストレッチなどによって妨害することはできません。

**TMC2209 か TMC5160 のどちらか一方で、必ずしも両方は必要ありません。** どちらのチップも実際の動作には同じ STEP/DIR/EN インターフェースを使用するため、その部分は共通です。異なるのは構成/診断です：TMC2209 はそのために独自のシングルワイヤ UART を使用し、TMC5160 は SPI を使用します——両者は任意の拡張ボード上で相互排他的であるため、4 つの SPI ピンは、SPI バスと同時に使用されることのない別の専用ピンを必要とすることなく、TMC2209 の単一の UART ラインの自然な収容先も兼ねます。ビットバンギング SPI バスは、TMC5160 が期待する正確なプロトコル（SPI モード 3、MSB ファースト、トランザクション全体を通して CS がローに保持される——それを駆動する汎用のバイトパススルーコマンドは `docs/CANBUS.TXT` の `0x180`/`0x181` を参照）を話すため、本ファームウェアがそのチップの特定のレジスタレイアウトを知る必要はありません。TMC5160 の DIAG0 失速/障害ラインも配線されています（`0x182`/`0x183`）——これは、まさにこの種の高速な割り込み駆動入力のためにすでに確保されていた 2 つの汎用 GPIO ピンのうちの 1 つを再利用しています。

このチップの 48 ピンパッケージが持ついくつかのレイアウト制約の背後にある理由を含め、どの MCU ピンがどの信号を担っているかというピン単位の完全な詳細は、`docs/PINOUT_CONNECTORS.TXT` および `src/F303-master/README.md` にあります。

#### 6 種類の拡張ボードバリエーション

6 種類の拡張ボードバリエーションのうち 4 種類はステッピングドライバーを搭載しています——TMC2209（コイルあたり最大 2A、パワー MOSFET 内蔵）か、TMC5160A（コイルあたり最大 10A 以上、ドライバー自体には含まれない 8 個の外部パワー MOSFET が必要）のいずれかです。そのドライバーの選択とは独立して、ドライバーを搭載したボードは、**ベーシック**（ドライバー + コネクターのみ、MCU なし——STEP/DIR/EN はメインボードから直接ルーティング）か、**アドバンスド**（第 2 のマイクロコントローラー STM32F303CBT6、2 つのローカルセンサーチップ——16 ビット ADS1115 ADC と MLX9064x 系サーマルカメラ——を追加し、ケーブル経由でルーティングするのではなくツールヘッドで直接生成する必要のあるタイミングを持つツール向けのローカル PWM 生成も追加）のいずれかです。2×2 の組み合わせに加えて、これら 2 つのチップのうち 1 つだけを必要とし、アドバンスドボードが搭載する他の何も必要としないツール向けに、センサーのみのベーシックボード（ADS1115 または MLX9064x、ドライバーもスレーブ MCU もなく、メインボード自身の STM32F303CC に直接配線）が 2 種類追加され——合計 6 枚のボード——`BOM/BOM_EXPANSION_*.TXT`（6 ファイル）、`docs/EXPANSION.TXT`、`docs/PINOUT_SLAVE.txt` を参照してください。

アドバンスドバリエーション自身の STM32F303CBT6 は、上記の拡張コネクターの既存のビットバンギング I2C バス経由でメインボードと通信します——メインボードがマスター、スレーブチップが実際のハードウェア I2C スレーブとして応答します——そして、2 つのセンサーチップ用に、自身の第 2 のローカル専用 I2C バスを駆動します。それは自身のブートローダーとアプリケーションファームウェアを持ち、メインボードと同じ方法（`URTC Flasher` からの CAN-OTA）で更新されますが、スレーブチップへ直接到達するのではなく、その I2C リンクを介して中継されます。完全な技術詳細は `src/F303-slave/README.md` と `src/F303-slave/boot/README.md` を参照してください。

### パラメータの永続化

搭載の FM24CL64B F-RAM（64Kbit、I2C）は、アクティブなツールの設定値とグローバルな LED/OLED 設定の定期的に更新されるスナップショットを保持しているため、突然の電源喪失によって「このボードが何をしていたか」が、その喪失自体が予期しないものであったのと同じくらい知り得ないものになることはありません。それは独自の I2C バスを取得するのではなく、OLED のハードウェア I2C2 バスを共有します——この MCU には、この目的で使用可能なハードウェア I2C ペリフェラルが 1 つしかなく、すでに OLED によって使用されています（完全な理由は `src/F303-master/README.md` 第 6 節を参照）。

**復元された状態は照会可能ですが、危険なものに自動的に適用されることは決してありません。** 起動時、保存されていたものは何でも CAN 経由で読み取り可能になります（`0x190`/`0x191`）——しかし、ヒーターの設定値、レーザー出力、またはモーターコマンドが、それ自体で黙って再び有効化されることは決してありません。安全で受動的な設定（LED の色、OLED モード）のみが直接復元されます。実際に何が起こったかを確認した後に設定値を意図的に再送信するかどうかは、電源が戻った瞬間にこのボード自体が決めることではなく、マスターコントローラーの判断に委ねられています。

### ネイティブに自動化されたツールカタログ（25 種類のファームウェアプロファイル）

その動的な切り替えロジックを通じて、ファームウェアは以下のツールヘッドをネイティブに管理します：

1. **はんだ付けステーション（T12）：** 標準的な T12 はんだごて先を扱うための、直接 ADC フィードバックを使用したヒステリシス付きのオン/オフ温度制御（PID ではありません）に加え、はんだワイヤを接合部へ送り込む電動ワイヤーフィーダー（下記の単純な動作系ツールと `CONN_MOT` およびそのステッピングプロトコルを共有——そのためのスペースを確保するため、このツール自身の汎用エンドストップ入力を犠牲にしています）。[ジャンパー/配線設定 →](images/TOOL_SOLDERING_IRON.png)
2. **SMT はんだペーストディスペンサー：** PCB 上への精密なはんだペースト塗布のためのミリメートル単位の送り制御。[ジャンパー/配線設定 →](images/TOOL_PASTE_DISPENSER.png)
3. **サーマルペースト／液体ディスペンサー：** 高粘度ペーストまたは液体接着剤の流動性管理。[ジャンパー/配線設定 →](images/TOOL_LIQUID_DISPENSER.png)
4. **スマート電動ドライバー：** ステッピングのインターフェース経由の回転および停止制御。計画中：トルク制限による停止（トルクの検出はまだありません）。[ジャンパー/配線設定 →](images/TOOL_SCREWDRIVER.png)
5. **真空／空圧グリッパー：** 安全なピック＆プレース作業のための真空ポンプ制御と圧力レベル読み取り。[ジャンパー/配線設定 →](images/TOOL_VACUUM_PICKUP.png)
6. **ドリル（BL4260）：** ステッピングツールドライバーのイネーブルとは独立した専用のイネーブル/ブレーキラインでの、ライブ RPM 読み取りを伴う PWM 速度制御、方向切り替え、動的電子ブレーキ。汎用エンドストップ入力が利用可能。[ジャンパー/配線設定 →](images/TOOL_DRILL.png)
7. **ジンバルグリッパー：** 3 相ブラシレスジンバルモーターを使用した高感度な操作。[ジャンパー/配線設定 →](images/TOOL_GRIPPER_GIMBAL.png)
8. **NEMA グリッパー：** 高負荷ステッピングモーターで制御される堅牢な把持力。[ジャンパー/配線設定 →](images/TOOL_GRIPPER_NEMA.png)
9. **AOI（自動光学検査）システム：** マシンビジョンカメラの撮影のための LED 照明アレイの同期ストロボ制御。汎用エンドストップ入力が利用可能。[ジャンパー/配線設定 →](images/TOOL_AOI_INSPECTION.png)
10. **彫刻レーザーダイオード（10W 光学）：** ホスト通信が失われた場合にレーザー出力をロックするソフトウェアの CAN ウォッチドッグを備えた PWM ビーム出力変調（ビルドのみで実機では未実行であり、独立したハードウェアインターロックの代わりにはなりません）。汎用エンドストップ入力が利用可能。[ジャンパー/配線設定 →](images/TOOL_LASER_ENGRAVER.png)
11. **3D プリンティングホットエンド：** 加熱カートリッジのヒステリシス付きオン/オフ制御、NTC サーミスタの読み取り、エクストルーダー制御、そして専用の 25kHz PWM 制御レイヤー冷却ファン（4 線式、タコメーターフィードバック、独自の通信ウォッチドッグ）——すべてが 1 つのブロックに統合されています。[ジャンパー/配線設定 →](images/TOOL_3D_PRINTER.png)
12. **3D スキャナープローブ：** 遅延のないリアルタイムの表面デジタル化と衝撃検知のための、絶対優先度を持つ超高速ハードウェア割り込み入力（EXTI）。計量用のタッチプロービングも対象——同じハードウェアパスで、同じツールヘッド上の異なる物理プローブです。[ジャンパー/配線設定 →](images/TOOL_SCAN_PROBE.png)
13. **SMT ピック＆プレースヘッド：** 上記のペースト/液体ディスペンサーと両方のグリッパーと同じステッピングインターフェース上での、正しいパッド位置合わせのための回転 A 軸。[ジャンパー/配線設定 →](images/TOOL_SMT_PICKPLACE.png)
14. **重量物用電磁石：** 汎用 GPIO ドライバーとして転用された T12 ヒーター出力を使用した、強磁性部品のオン/オフ吸着制御。[ジャンパー/配線設定 →](images/TOOL_ELECTROMAGNET.png)
15. **スポット溶接ヘッド：** 表面接触センサーがパルスをゲート制御する、バッテリーパックのニッケルストリップ向けのミリ秒精度の溶接パルス。[ジャンパー/配線設定 →](images/TOOL_SPOT_WELDER.png)
16. **コンフォーマルコーティングエアブラシ：** 完成した PCB のための保護コーティングスプレー制御——スプレーバルブとその自身のセンサーはロボット自身のメインボード上にあり、本ボード自身の範囲外です。[ジャンパー/配線設定 →](images/TOOL_CONFORMAL_COATING.png)
17. **大判真空グリッパー：** 部品を実装していない FR4 ボード向けのマルチカップ吸引アレイで、上記のツール #13 と同じステッピングインターフェースを使用します。[ジャンパー/配線設定 →](images/TOOL_VACUUM_GRIPPER_LG.png)
18. **機能テストヘッド：** フライングプローブによる電圧/導通テスト——基本的な読み取りは搭載 ADC から、高度な読み取りは**アドバンスド**拡張ボード上の 16 ビット ADS1115 ADC 経由です。[ジャンパー/配線設定 →](images/TOOL_FLYING_PROBE.png)
19. **UV 硬化ヘッド：** 瞬時の接着剤/マスク硬化のための高出力 UV LED ドライバー。[ジャンパー/配線設定 →](images/TOOL_UV_CURING.png)
20. **ホットエアリワークノズル：** 位置ずれした SMD 部品のリフローのための、加熱素子、タービンブロワー、熱電対フィードバック——はんだごて自身の熱制御ループを共有します。[ジャンパー/配線設定 →](images/TOOL_HOTAIR_REWORK.png)
21. **空圧圧入インサーター：** PCB へコネクターを圧入するためのリニアアクチュエーター制御——アクチュエーターとその自身のセンサーはロボット自身のメインボード上にあり、本ボード自身の範囲外です。[ジャンパー/配線設定 →](images/TOOL_PRESSFIT_INSERTER.png)
22. **ワイヤーハーネス／圧着アクチュエーター：** 端子のストリッピング/圧着のための高トルクジョー、メインボードではなく**拡張ボード自身のドライバー**によって駆動されます。ファームウェアにはトルクや力の検出はありません。[ジャンパー/配線設定 →](images/TOOL_CRIMPING_ACTUATOR.png)
23. **PCB 高度検査：** サーマルイメージング（MLX9064x 系アレイ——現在、MLX90640/MLX90641/MLX90642 の全 3 ファミリメンバーをサポート、**アドバンスド**拡張ボード自身のスレーブチップ経由か、メインボードに直接配線された**ベーシック** MLX9064x 拡張ボード経由のいずれか）で温度シグネチャによりショートを発見、リング LED 照明と併用。マイクロスピンドルでのデパネリングも対象——上記と同じドリルハードウェアパスで、異なる作業向けの異なる用途です。[ジャンパー/配線設定 →](images/TOOL_THERMAL_INSPECTION.png)
24. **はんだペースト噴射バルブ：** **アドバンスド**拡張ボード上でローカルに生成される、ピエゾ電気式マイクロ滴下ディスペンシング、サブミリ秒精度のパルス。[ジャンパー/配線設定 →](images/TOOL_PASTE_JETTING.png)
25. **超音波溶接機／包装シーラー：** プラスチック筐体溶接のための高周波トランスデューサートリガー。[ジャンパー/配線設定 →](images/TOOL_ULTRASONIC_WELDER.png)

*（ツール 1-12 の構成画像は存在します。ツール 13-25 の画像は、ハードウェアドキュメントが追いつくにつれて追加されます——上記のファイル名は `images/` ですでに使用されている命名規則に一致しています。）*

### ローカル OLED インターフェース

すべてのツールヘッドは、128×64 の 2 トーン OLED 上に、ライブでツール固有のテレメトリを表示します：電源投入時のアニメーション起動スプラッシュ、点滅する CAN アクティビティインジケーター、上部ストリップのライブな「主要」読み取り値（温度、RPM、電力——アクティブなツールにとって最も重要なもの）、そしてツールプロファイルごとの小さな 4 フレームアニメーションアイコン。

#### モジュール

下記の 2 つの物理バリエーションは、電気的には同じパネルです（SSD1306 または SSD1315 駆動——ファームウェアの初期化シーケンスは両方と互換性があることが確認済みです。`firmware_oled_driver.c` の `OLED_Init()` を参照してください。SSD1315 は新しい、そのまま置き換え可能なコントローラーで、今日多くのモジュールが同じ「SSD1306」表記/シルク印刷の下で実際にはこれを出荷しています）、いずれも **128×64**、そして同じ 2 トーンの「黄/青」分割で、物理的な LED 素材自体が 2 つの固定色ゾーンに分かれています（これはソフトウェアで選択できるものではありません）：

* **上部 16 ピクセル（0-1 ページ）：黄色。** URTC はこのストリップを、詳しく読まなくても一目でわかる最も有用な情報——CAN アクティビティインジケーター、ライブな主要読み取り値、または（起動スプラッシュ/無効ツール画面では）短いステータステキスト——のために使用します。
* **下部 48 ピクセル（2-7 ページ）：青色。** その他すべて——ツールアイコン、詳細なテレメトリ、スプラッシュ画面上のアニメーション JuanenBOT の顔、大きく点滅する ERROR のワードマーク。

どちらも同じ I2C2 バスと同じ `OLED_Init()` に接続されます——ファームウェアはどちらが取り付けられているかを判別できず、判別する必要もありません。両者は特定のボード上で相互排他的です（`BOM/BOM.TXT` の `CONN_OLED2` の注記を参照——本ドキュメントでの、回路図が `LCD1` と呼ぶものの名前です）。

##### オプション A ——直接実装（`CONN_OLED2`、実際にボードに実装されているフットプリント）



独立したブレークアウト PCB を持たない裸のパネル——ガラス板とその 30 ピン FPC リボンだけが、`CONN_OLED2` フットプリント（`FPC30`、WiseChip UG-2864、本ドキュメントでの、回路図が `LCD1` と呼ぶものの名前——`BOM/BOM.TXT` と `URTC_NETLIST.TXT` を参照）に直接はんだ付けされています。30 ピンのうち、実際に配線されているのは一部だけです——残りはパネルの並列インターフェースバス（`D2`–`D7`、`RW`、`E/!RD`）で、本ボードは I2C 経由でのみそれと通信するため、未接続のままです：

| CONN_OLED2 ピン | ネット | 機能 |
|---|---|---|
| 1, 8, 29, 30 | GND / AGND | グラウンド |
| 9 | VDD | ロジック電源（`+3V3B`、OLED 専用のレールから——BOM §1 参照） |
| 28 | VCC | パネル電源 |
| 2–5 | C2P/C2N/C1P/C1N | チャージポンプコンデンサー——BOM の `C26`/`C27` |
| 26 | IREF | 基準電流設定抵抗 |
| 27 | VCOMH | 内部共通電圧デカップリング |
| 10, 12 | BS0, BS2 | GND に接続 |
| 11 | BS1 | `+3V3B` に接続 |
| 18 | D0/SCK | I2C2 SCL——PA9 |
| 19 | D1/DIN/SDA | I2C2 SDA——PA10 |

`BS0`/`BS1`/`BS2` は、パネル自身のインターフェース選択ストラップ（ここでは GND/VCC/GND）であり、MCU に公開されるのではなくハードウェアで固定されています——これによって、他の 22 個の FPC ピンが属する 8080/6800 パラレルモードではなく、まずコントローラーが I2C モードになります。

##### オプション B ——ブレークアウトモジュール（`CONN_OLED`、外部代替案）



同じパネルが、4 ピンヘッダーを備えた小さなキャリアボード上に事前に実装されたもの——裸の FPC パネルを調達するよりも既製モジュールを配線したい場合に便利です。交差なしで `CONN_OLED` に直接配線されます——モジュール自身のピン順序（`GND · VDD · SCK · SDA`）は `CONN_OLED` のピン配置とピン単位で正確に一致します：

| OLED モジュールピン | CONN_OLED ピン | 信号 |
|---|---|---|
| GND | 1 | グラウンド |
| VDD | 2 | +3.3V（ディスプレイロジック電源） |
| SCK | 3 | SCL——PA9、ハードウェア I2C2 |
| SDA | 4 | SDA——PA10、ハードウェア I2C2 |

#### 起動スプラッシュ



#### ツールアイコン（プロファイルごとに 1 つ、4 フレームアニメーション）

<table>
<tr>
<td align="center"><br>T12 はんだごて</td>
<td align="center"><br>ペーストディスペンサー</td>
<td align="center"><br>液体ディスペンサー</td>
<td align="center"><br>ドライバー</td>
</tr>
<tr>
<td align="center"><br>真空ピックアップ</td>
<td align="center"><br>ドリル（BL4260）</td>
<td align="center"><br>ジンバルグリッパー</td>
<td align="center"><br>NEMA グリッパー</td>
</tr>
<tr>
<td align="center"><br>AOI 検査</td>
<td align="center"><br>レーザー彫刻機</td>
<td align="center"><br>3D プリンターホットエンド</td>
<td align="center"><br>3D スキャナープローブ</td>
</tr>
<tr>
<td align="center"><br>SMT ピック＆プレース</td>
<td align="center"><br>電磁石</td>
<td align="center"><br>スポット溶接機</td>
<td align="center"><br>コンフォーマルコーティング</td>
</tr>
<tr>
<td align="center"><br>大判真空グリッパー</td>
<td align="center"><br>フライングプローブ</td>
<td align="center"><br>UV 硬化</td>
<td align="center"><br>ホットエアリワーク</td>
</tr>
<tr>
<td align="center"><br>圧入インサーター</td>
<td align="center"><br>圧着アクチュエーター</td>
<td align="center"><br>サーマル検査</td>
<td align="center"><br>ペースト噴射</td>
</tr>
<tr>
<td align="center"><br>超音波溶接機</td>
</tr>
</table>

#### 無効なツール ID 警告

ID ジャンパーが 25 種類の割り当てられたプロファイルのいずれとも一致しない場合、本ボードはすべてのアクチュエーターをブロックし、代わりに以下を点滅させます：



すべてのアニメーションソース GIF は [`/ani`](ani/) にあります。

### デジタルステータス LED

OLED および 8 ピクセルの照明リングとは別に、`CONN_LED1` は、一目でわかるステータス専用の単一のアドレス指定可能な RGB LED（WS2812B 系、SPI/DMA 駆動）を備えています。

**デフォルトでは自動、必要に応じてホストが上書き可能。** ファームウェアはこの LED の色を独自に、3 段階の優先順位で決定します：

* 🔴 **赤** ——ハードウェア障害がアクティブ（`system_error_flag`）。他に何が起きていようと、常に優先されます。
* 🔵 **青** ——ボードが積極的に機能中：過去 1.5 秒以内に CAN フレーム（任意の ID）が到着しました。
* 🟢 **緑** ——アイドル、コマンド待ち：1.5 秒以上 CAN トラフィックがありません。

マスターは、CAN ID `0x100`（DLC 8）を送信することで、いつでもこれを上書きできます。最初の 3 バイトが赤、緑、青の強度です（それぞれ 0-255——自動の 3 色だけでなく、完全な 24 ビットカラー）。ホストが送信した色は 10 秒間保持された後、自動方式にフォールバックします——実際に見えるほど十分に長く、ホストが更新を止めた場合にボードが古いカスタムカラーの表示に固定されないほど十分に短い時間です。`0x100` を再度送信する（同じ色でも新しい色でも）と、その 10 秒のウィンドウがリフレッシュされるため、カスタム制御を維持したいホストは定期的に送信し続けるだけで済みます。ハードウェア障害は、アクティブなオーバーライドを常に中断します——赤は、ホストが設定したどの色よりも優先されます。

正確なバイトレイアウトは `docs/CANBUS.TXT`（ID `0x100`）を参照してください。このメッセージは、リング LED および OLED の夜間モード制御とも共有されています。

## 🔒 セキュリティと安全

- **熱暴走保護**（`thermal_guard.c`、アプリケーション 0.3.2 以降）をはんだごて／ホットエアと 3D ホットエンドに搭載：*実測*温度に対する MAXTEMP（T12 449 °C、ホットエンド 310 °C）、加熱監視（ヒーター ON 中は温度が実際に上昇しなければならない — 外れたサーミスタやチップを検出）、保持チェック（目標到達後、ヒーター ON のまま長時間下がり続けないこと）。異常時はヒーターを切り、ボードのエラーをラッチし、原因を `0x111` のバイト 4 で通知します。シミュレートしたヒーターでホスト上でテスト済み（`tests/test_thermal_guard.c`）。上限値は実際のヒーターで測定されたことはなく、実機のボード上で動作したこともありません。
- **ハードウェア周辺のファームウェアロジックのホストテスト**（`tools/run_host_tests.py`、58 スイート）：ブートローダー、サーマルガード、ディスパッチャーに加えて、13 ツールの実際の CAN ハンドラー（`firmware_can_*.c`）、ヒーター制御ループ（`firmware_control_thermal.c`：ADC の換算、あり得ない読み値、設定値の上限、ヒステリシス、固着したヒーター、ガードの故障）、故障レコーダー（`firmware_blackbox.c`。URTC-COMMON が自前のモデルから書き出すシナリオとバイト単位で照合し、CAN 読み出しも検査）、ジャンパーによるツール識別、エラーゲート後のコマンド、サーマルカメラのコマンドを、偽の HAL（`tests/host_hal/`）に対してコンパイルし、アドレスおよび未定義動作サニタイザーと `gcc -fanalyzer` の下で実行します。`--coverage-floor`（CI では `URTC_COVERAGE_FLOOR`）は実行された行の割合を保証します（スイートがコンパイルする 83 のファームウェアソースの行の 94.0 パーセント（88 のうち 3 はボードが必要で、2 はデータのみのヘッダースロット）。アプリケーションの起動とメインループ、OLED ドライバーとその画面、ステータス LED、割り込みハンドラー、拡張コネクターのバス、3 種類のサーマルカメラ、拡張スレーブ、2 つのブートローダーのメインプログラムを含みます。CI の下限は 90 です）。これらはいずれも実機では動かしていません。
- **診断：** `0x111` のバイト 5 は直前のリセット要因を通知（bit0 = ハードウェアウォッチドッグが作動）。`0x1AA`/`0x1AB` は F-RAM に保存される累積カウンター（熱異常の回数、最後の異常コード、ヒーター ON の総時間、0.3.3 以降）を返します。ブラックボックスのサンプルにも熱異常コードが記録されます。
- **ファームウェア署名：** メインボードのブートローダーは秘密を保持せず、公開鍵テーブル（`keys/image_trust.json`）に対して Ed25519 レコードを検証します。テーブルは、公開の開発用鍵を持つベンチ用、またはイメージ署名鍵が作成されるまで空の公式用としてビルドに組み込まれます。拡張スレーブのブートローダーは更新経路に署名鍵を持ちません。メインボードが Ed25519 レコードを検証したうえで、その更新セッションでまさにそのイメージを確認した場合にだけインストールし、内部リンクバスを通じてメインボードを信頼します（[`docs/SLAVE_BOOT_CONFIRMATION.md`](docs/SLAVE_BOOT_CONFIRMATION.md) を参照）。鍵も HMAC ルーチンも一切持たず、追記専用のログに署名付きロールバックカウンターを自前で保持し、メインボードもそれを読み取って強制します。`firmware/` の各イメージは `<bin>.sha256` と `<bin>.manifest.json` とともに配布されるため、URTC Flasher と URTC Web Studio は鍵を一切持ちません。[`docs/FIRMWARE_SIGNING.TXT`](docs/FIRMWARE_SIGNING.TXT) を参照してください。公式リリースの各ファイルには、分離形式の Ed25519 リリース署名（`<ファイル>.sig`、公開鍵は [`docs/RELEASE_SIGNING.md`](docs/RELEASE_SIGNING.md)）も付きます。フラッシャーと Web スタジオは、署名がある場合にそれを検証します。
- **イメージ内のヘッダー：** アプリケーションイメージは、ベクターテーブルの後ろの固定オフセット `0x200` に、自身の識別情報を 32 バイトで持ちます。対象のハードウェア、4 要素のバージョン、イメージ全体の長さと CRC-32 です。ファームウェアがスロット（`firmware_image_slot.c`、`slave_image_slot.c`）を出力し、リンカースクリプトがそれを配置します。ベクターテーブルがその手前で終わらない場合はリンクが失敗します。長さと CRC-32 はリンク後に `tools/seal_image.py` が書き込みます。フラッシュマップ、ベクターテーブル、イメージの長さは変わらず、署名レコードは封印後のファイルに対してこれまでとまったく同じ方法で作られ、ブートローダーも変更されません。いずれもボード上ではまだ動作していません。
- **CAN バス：** 送信元を認証しません — どのノードでもツールを操作できます。レーザー・ヒーター・溶接機を使う設置では、MCU から独立したハードウェアインターロックと閉じたバスが**必須**です：[`docs/CAN_THREAT_MODEL.TXT`](docs/CAN_THREAT_MODEL.TXT)。
- **1 本の CAN バスに複数のツールヘッド（既定ではオフ）：** 永続スイッチ（CAN `0x1AC` で設定、`0x1AD` で読み出し。F-RAM のレコードは [`docs/EEPROM.TXT`](docs/EEPROM.TXT) に記載）を入れると、5 本の ID ジャンパーから得るノードアドレス、探索、選択規則が有効になります。選択されたヘッドだけがコマンドに従い、選択されていないヘッドは何も動作させません。スイッチがオフの場合（既定であり、空の F-RAM を読んだ場合も同じ）、ボードは単一ヘッドとまったく同じ動作で、フレームと識別子は変わりません。ファームウェアに実装済みで、コンピューター上でのみテストされており、ボードでは試していません。設計とフレームは URTC-COMMON（`docs/MULTINODE.md`）と [`docs/CANBUS.TXT`](docs/CANBUS.TXT) の付録にあります。
- **ブートローダーが応答するものと、スレーブのパッチ番号：** 読み戻し（`0x7FE`）とダウングレード許可（`0x7FD`）は、アプリケーションが `0x7F0` を受け付けて開始したブートローダーのセッション（または有効なアプリケーションのないボード）でのみ応答されます。通常の電源投入後は無視され、ビルドオプションで無効にできます。拡張スレーブはバージョンレジスタの 10 バイト目にパッチ番号を入れて送り、マスターはそれを `0x222` で中継します（0 のバイトは未送信を意味し、古いスレーブと同じ扱いです）。続く 3 バイト目にマイナー番号の下位バイトが入るため、プログラムは完全なバージョンを表示できます。ソースに実装され、ホストでテスト済みです。まだこれを含むファームウェアイメージはありません。

## 🔌 インターフェース

**CAN バスの速度：** ツールヘッドのバスは **1 Mbit/s** で動作します（値は URTC-COMMON の `spec/can_protocol.json` に 1 か所だけ書かれ、ファームウェアとブートローダーはチップのクロックに合わせてそこからタイミングを計算します。正確なビットレート、サンプルポイントは 87.5 %、75 % を下回ることはありません）。500 kbit/s は初期の基板向けの従来オプションとして残り、`URTC_CAN_LEGACY_500K=1` でビルドします。**互換性に関する注意：** 同じバスのすべての基板とアダプターは同じ速度でなければなりません（速度が混在したバスは動作せず、ツールが警告します）。1 Mbit/s では幹線を約 25 m 以内に抑え、分岐は数 cm、両端に 120 Ω の終端抵抗が必要です。500 kbit/s では約 100 m まで可能です。実際のバスではまだ動作確認していません。

ブートローダーが設置されると、アプリケーションの更新にはもはやボードへの物理的なアクセスは一切不要になります——ツールヘッドへのコマンドをすでに運んでいるのと同じ CAN ケーブル経由で新しいファームウェアビルドを送信するだけです。

**更新シーケンス：**

1. **トリガー。** マスターは*実行中のアプリケーション*へ `0x7F0`（DLC 4、ペイロード `B0 07 1D 5A`）を送信します。これは、モーター、ヒーター、レーザーといったすべてのアクチュエーターへの電源をインラインで安全に遮断し、チップをリセットします。このマジックペイロードの要件は、破損した、あるいは不正な形式のフレームが誤って更新モードへのリセットをトリガーできないことを意味します。
2. **開始。** リセット後、ブートローダーがリッスンしています。マスターは `0x7F1`（DLC 8、ビッグエンディアンのファームウェア総サイズ + ビッグエンディアンの HardwareID）を送信します。異なるハードウェア向けにビルドされたイメージは、フラッシュの 1 バイトも触れられる前に、まさにこの時点で拒否されます。ブートローダーは新しいイメージが必要とする分だけ正確にバックアップスロットのページを消去し、ステータスフレーム（`0x7F5`）で応答します。
3. **署名。** マスターは、76 バイトの Ed25519 レコード（鍵 ID、ロールバックカウンター、署名）を、データの前に任意の順序で 11 個の `0x7EC` フレーム（インデックスと各 7 バイト）として送信します。これはビルド後にメンテナーのマシン上で、イメージ、その SHA-256、カウンターを記述したヘッダーに対して計算されます。ブートローダーは公開鍵しか保持しないため、読み出しても誰も署名できるようにはなりません。公式の鍵テーブルはイメージ署名鍵が作成されるまで空で、ベンチビルドは公開の開発用鍵を信頼します（`docs/FIRMWARE_SIGNING.TXT` を参照）。
4. **データ。** マスターは `.bin` ファイルを、連続して送信される一連の `0x7F2` フレーム（それぞれ最大 8 バイトの生ファームウェアデータ）としてストリーミングします——CAN は単一バス上でフレームが送信された順序で到着することを保証するため、フレームごとのシーケンス番号は不要です。ブートローダーは受信バイトを RAM 内の 2KB ページにバッファリングし、満杯になったら*バックアップ*スロットに書き込み、そのページが完了したと見なす前に、書き込まれるはずだった内容と比較しながら各ハーフワードを読み戻し、検証済みの書き込みごとに（ページインデックス付きの）`0x7F3` 確認応答を送信します。妥当なマスター実装は、次のページ分のデータを送信する前に各ページの ACK を待ち、ブートローダーの受信バッファをオーバーランさせないようにします。
5. **終了と検証。** すべてのバイトが送信されると、マスターは `0x7F4`（DLC 8、ビッグエンディアンの CRC32 + メジャー/マイナーバージョン）を送信します。ブートローダーはバックアップスロットのサイズをチェックし、その CRC32 を計算し、Ed25519 レコードをマスターが宣言した値に照らして検証します。すべてが一致した場合にのみ、上記と同じ読み戻し検証を伴って、ページごとにバックアップをメインスロットへコピーする処理を進めます。そのコピーが完了して確認されると、新しいメタデータを保存し、更新されたアプリケーションへリセットします。サイズ、CRC32、署名、または HardwareID のいずれかが不一致の場合、メインスロットはまったく触れられず、ブートローダーは単に新しい試行のためのリッスンに戻ります。

**ステータスフレーム（`0x7F5`、DLC 1）：** `0x01` リッスン中、`0x02` 消去中、`0x03` 受信中、`0x06` 検証中、`0x07` バックアップをメインへコピー中、`0x04` 検証成功（ジャンプ直前）、`0x05` 検証失敗、`0xFF` エラー。

**ハートビート（`0x7F6`、DLC 2、リッスンまたは更新中は約 1 秒ごと）：** ステータスバイト + 進捗パーセント（0-100、パーセントが適用されない場合は `0xFF`）。マスターが「ノードは生きているがまだリッスンを開始していない」を「ノードが完全に応答していない」と区別できるようにします——自動化された立ち上げや、タイムアウトを待たずに止まったブートローダーを発見するのに便利です。

**画面上の進捗。** ブートローダーは更新中に OLED を直接駆動します——何が起きているかを誰も推測する必要はありません。ページが書き込まれたりコピーされたりしている間は「UPDATING」とライブの進捗バーおよびパーセンテージを表示し、新しいファームウェアへリセットする直前に一瞬「FLASH OK」を表示し、ページの書き込みが失敗した場合、転送が 10 秒以上停滞した場合、または検証が不一致で返ってきた場合には「ERROR」を表示します。

**⚠️ 現場で信頼する前に、ベンチテストを行ってください。** 上記のプロトコルはクリーンにコンパイル・リンクされ、ロジックも慎重に検討されていますが、ブートローダーはまさに「正しくビルドされる」ことと「ハードウェア上で信頼できる」こととの間に大きな隔たりがあるタイプのファームウェアです——実際のフラッシュプログラミングのタイミング、数千フレームにわたる転送での CAN の挙動、そしてブートローダーからアプリケーションへの引き継ぎは、実際のアクチュエーターが接続された無人更新でこれに頼る前に、実機ボード（できれば JTAG を手元にフォールバックとして）で検証される必要があります。

## 🚀 クイックスタート

URTC のフラッシュは 2 つの独立した部分に分割されているため、本ボードはすでに他のあらゆる通信に使用しているのと同じ CAN ケーブル経由で再書き込みできます——初期セットアップの後は、JTAG/SWD ヘッダーに物理的にアクセスする必要は二度とありません。

### 初回セットアップ——JTAG/SWD が必要（一度だけ）

ブートローダーは物理的なプログラミングによってのみチップに載せることができます——まだブートローダーが載っていないボードを CAN でフラッシュする方法はありません。これは一度限りのステップです：

1. **STM32CubeIDE**（STM32F303CC ターゲットに対してビルド・テスト済み）でプロジェクトを開くか、下記のコンパイル済み出力を使って **STM32CubeProgrammer** を直接使用します。
2. 搭載の `STM_JTAG` ヘッダー経由で、SWD（ST-Link）で**両方の**イメージを書き込みます——各 `.hex` ファイルにはターゲットアドレスが焼き込まれているため、（STM32CubeProgrammer を含む）ほとんどのツールは同じセッションで両方を読み込めます：
   * `URTC_MAIN_BOOTLOADER_v<version>.hex` → `0x08000000`
   * `URTC_MAIN_FIRMWARE_v<version>.hex` → `0x08008000`
3. 電源を入れる前に、ID はんだジャンパーでツールの識別情報を設定します——ボードは起動時に一度だけそれを読み取ります、いつもどおりです。5 つのジャンパー（ID0-ID4）で、完全な 32 アドレス空間をカバーします（31 の直接ツールアドレスに加え、予約された `11111` のフリー構成アドレス——上記のツールマトリクスの節を参照）。
4. 電源を入れます。ブートローダーは約 600ms リッスンし、何も見つからず、直接アプリケーションへジャンプします——ここから先は、すべてが本 README の残りの部分で説明されているとおりに動作します。このウィンドウは、ブートローダーが保存済みアプリケーションを検査した後に始まり、更新したいツールはその間に更新開始フレーム（0x7F1）を送る必要があります。待機ステータス（0x7F5 = 0x01）は、ジャンプせずにウィンドウが終了したときに送られ、開始時には送られません。

**JTAG ヘッダーが取り外されたり無効化されたりすることは決してありません。** それは常にフォールバックとして存在します——もし CAN 更新がうまくいかなかった場合、あるいは単にそちらを好む場合、いつでも SWD 経由でどちらかのイメージを再書き込みできます。

**ボード上の 2 つのプッシュボタン、BOOT と RESET** も復旧のために存在します——RESET は通常のハードウェアリセット（`NRST`）で、BOOT は `BOOT0` をハイに引き上げます。これは、本リポジトリ内の何かが実行される*前に*チップレベルで下される決定です：通常（押されていない場合）はチップはフラッシュから起動し、上記のように本プロジェクト自身のブートローダーに入ります。リセット時に押されていると、代わりに ST 自身の工場出荷時のシステムメモリブートローダー（USB DFU/UART 復旧、ここにあるものとは完全に別のもの）で起動します。完全な技術詳細は `src/F303-master/README.md` 第 4a 節を参照してください。

### PC ツール

本ボードをサポートする 2 つの独立したクロスプラットフォーム（Windows/Linux）GUI ツールがあります——**URTC Flasher**（CAN-OTA およびフルチップ SWD/JTAG 更新、本ボードと、アドバンスド拡張バリエーションでは自身の拡張スレーブチップの両方に対応）と、**URTC Tester**（現在ジャンパーで設定されているどのツールプロファイルでも表示する、ライブの CAN バステスター）です。両方ともかつては本リポジトリの `tools/` 内に存在していましたが、今ではそれぞれが独自の README、ライセンス、翻訳を持つ独立したプロジェクトです：

- [URTC Flasher](https://github.com/JuanenRac/URTC-FLASHER)
- [URTC Tester](https://github.com/JuanenRac/URTC-TESTER)

ローカルに何もインストールすることなく、同様の範囲（ライブモニタリング、CAN 解析、OTA フラッシング、サーマル検査）をカバーする Web ベースの代替案も存在します：[URTC Web Studio](https://github.com/JuanenRac/URTC-WEB-STUDIO)。

<!-- urtc-section:compatibility -->
### 要件と互換性

どのバージョンの URTC プログラムが連携して動作し、それぞれがどのプロトコルバージョンを話すかは、URTC-COMMON が生成する互換性表に載っています：[docs/COMPATIBILITY.md](https://github.com/JuanenRac/URTC/blob/main/docs/COMPATIBILITY.md)。`tools/changelog_section.py` を持つリポジトリ（ファームウェア、フラッシャー、テスター、アップデーター）のリリースノートは、そのバージョンの CHANGELOG の節にこの表を続けたものです：`python tools/changelog_section.py VERSION --compat`。
<!-- /urtc-section:compatibility -->

## 🧪 テスト

ハードウェア周りのファームウェアのロジックはコンピューター上で試験されます。`python tools/run_host_tests.py` は、ホストのコンパイラー、模擬 HAL、AddressSanitizer と UBSan（`-fanalyzer` 付き）で 58 個の C テストスイート（`tests/test_*.c`）をビルドして実行します。対象は、ブートローダー、熱保護、ディスパッチャー、13 種のツールの実際の CAN ハンドラー、ヒーターの制御ループ、ブラックボックスなどです。CI は 4 つのバイナリのコンパイルとリンクも行い、ファームウェアのソースの実行行のカバレッジが下限を下回ると失敗します。実機では一度も動かしていません。実装済みのボードは存在せず、ホストのテストではタイミング、ドライバー、パワー段が動作することは示せません。`python tools/c_quality.py` は、ボード用コンパイラーが行わない 3 つの検査を加えます。スイートがビルドするすべてのソースに対するホストコンパイラーの `-Wconversion`、cppcheck、コメントブロックの長さの上限です（そのまま取り込んだセンサードライバーは対象外で、それぞれの理由は `tools/c_quality.json` にあります）。

## 🏗️ ビルドとリリース

### ソースからのコンパイル（任意——ビルド済みバイナリは各 GitHub リリースのアセットであり、リポジトリ内のファイルではありません）

本リポジトリのソースから上記 4 つのバイナリを得るには 2 つの方法があります：

- **自動化：** リポジトリルートの `build_firmware.sh`（Linux）または `build_firmware.bat`（Windows）。どちらも、ARM GNU ツールチェーンが不足していればインストールし、固定バージョンの ST HAL/CMSIS コミットを取得し、4 つのバイナリすべて（メインボードアプリ + ブートローダー、拡張スレーブアプリ + ブートローダー）をコンパイル、リンク、`objcopy` して `firmware/` へ直接出力し、その後 `firmware/firmware_manifest.json` を再生成します。引数なしで実行すると完全なビルド、`--clean` でまずローカルの `build/` キャッシュを消去、または `master`/`slave` で 1 つのチップ自身のペアのみをビルドします。`build_firmware.sh` は本プロジェクトの実際のソースツリーに対してエンドツーエンドで実行されます。`build_firmware.bat` は Windows 向けに同じロジックをミラーリングします——もし両者が食い違った場合は、`.sh` スクリプトのロジックをリファレンスとして信頼してください。
- **手動：** どちらのスクリプトでも実行されるすべてのコマンド、そして各ツールチェーン/HAL の選択の背後にある理由が、`docs/COMPILE_STM32F303.TXT` にステップバイステップで詳しく書かれています——異なる OS、異なる HAL/CMSIS ソースで作業する場合、あるいは単にスクリプトが自動化していることを正確に確認したい場合に役立ちます。
- **リリースアセット：** ファームウェアイメージ（`.bin`、`.hex`、`.elf` とそのチェックサム／マニフェストファイル）は git で管理されません。`build_firmware.sh`/`.bat` は `firmware/` に書き出し（git の無視対象。CI モード、つまり `URTC_CI=1` では `build/firmware`）、`python tools/publish_release_assets.py` が一式を検査して、添付するファイルを含む正確な `gh release create` コマンドを表示します。各バージョンの GitHub リリースのアセットとしてのみ公開されます。誰が何を読むか：[`docs/FIRMWARE_DISTRIBUTION.md`](docs/FIRMWARE_DISTRIBUTION.md)。

ファームウェアのソースを変更した後（またはバージョンの加算を信頼する前に）、リポジトリルートから **`check_version_consistency.sh`** を実行してください：これは Track A/E のバージョン定数（メインボードファームウェア、拡張スレーブアプリケーション）を唯一の正として読み取り、`VERSION_CHECKLIST.txt` がそのバージョンタグについて記録しているすべての場所をチェックし、不一致を報告します——報告するだけで、自分で何かを修正することはありません。`VERSION_CHECKLIST.txt` は、本プロジェクトが持つ 5 つの独立したバージョントラック（メインファームウェア、ハードウェア/PCB、メインブートローダー、拡張スレーブアプリケーション、拡張スレーブブートローダー）すべての完全なリファレンスであり、そのいずれかを加算する際に正確に何を変更する必要があるかを示します。

ファームウェアとブートローダーは独立してバージョン管理・リリースされます——新しいブートローダーを書き込んでも新しいアプリケーションバージョンを意味するわけではなく、その逆も同様であるため、それぞれが常に一緒に動くことを示唆する 1 つの結合されたバージョン番号ではなく、それぞれ自身のファイルに自身の履歴を持ちます：

- ファームウェア（`src/F303-master/`）：[`src/F303-master/CHANGELOG.md`](src/F303-master/CHANGELOG.md)
- ブートローダー（`src/F303-master/boot/`）：[`src/F303-master/boot/CHANGELOG.md`](src/F303-master/boot/CHANGELOG.md)
- 拡張スレーブアプリケーション（`src/F303-slave/`、STM32F303CBT6）：[`src/F303-slave/CHANGELOG.md`](src/F303-slave/CHANGELOG.md)
- 拡張スレーブブートローダー（`src/F303-slave/boot/`）：[`src/F303-slave/boot/CHANGELOG.md`](src/F303-slave/boot/CHANGELOG.md)

**バージョン：** 4 つのコンポーネント（2 つのアプリケーションファームウェアと 2 つのブートローダー：`FIRMWARE_VERSION_MAJOR`/`MINOR`/`PATCH` と `BOOTLOADER_VERSION_MAJOR`/`MINOR`/`PATCH`）は、それぞれ独立してバージョン管理されます。各バージョンは明示的な `python bump.py` の手順（リポジトリのルートにある `bump_version.py` を使います）でのみ上がり、コンパイルがバージョンを変えることはありません。各ブートローダーは対応するアプリケーションの `FIRMWARE_VERSION_*` のコピーも持ち、同じ手順が自動的に同期させます。4 つのコンポーネントの現在のバージョンはルートの [`CHANGELOG.md`](CHANGELOG.md) で一目で分かり、各系統の仕組みは [`VERSION_CHECKLIST.txt`](VERSION_CHECKLIST.txt) にあります。

## 📂 リポジトリの構成

<p align="center">
  URTC のリポジトリ構成
</p>

<details>
<summary>ツリーのテキスト版</summary>

```text
URTC/
├── src/                                               4 つのファームウェアコンポーネントとその共有部分
├── PCB/                                               回路図と基板設計
├── BOM/                                               ボードと 6 種の拡張ボードの部品表
├── 3D/                                                3D モデル
├── ani/                                               OLED のアニメーション
├── keys/                                              公開鍵のみ、秘密鍵は一切なし
├── docs/                                              CAN プロトコル、ピン配置、署名、脅威モデル、データシート
├── tests/                                             58 の C ホストテストスイート
├── tools/                                             ホストテストの実行、リリースツール、共有検査
├── images/                                            バナーとこの README の画像
├── .github/                                           CI ワークフローと Issue・プルリクエストのテンプレート
├── build-test.sh build-test.bat                       リポジトリを変更しないビルド・テストのスクリプト
├── test.sh test.bat                                   テストを実行
├── urtc.project.json                                  マニフェスト：バージョン、役割、成熟度、ビルドコマンド
├── CHANGELOG.md                                       各バージョンの変更内容
├── SECURITY.md SUPPORT.md LICENSE                     セキュリティポリシー、サポート、ライセンス
├── CONTRIBUTING.md CODE_OF_CONDUCT.md                 貢献方法と行動規範
├── .gitattributes .gitignore                          Git の設定
├── build_firmware.sh build_firmware.bat               4 つのバイナリをビルド
├── bump.py bump_version.py bump_manifest_version.py   バージョンを上げるスクリプト
├── check_version_consistency.sh                       バージョンを示すすべての箇所を検査
├── check_shared_drivers.py                            共有ドライバーのコピーを検査
├── firmware_signing.py                                イメージに署名
├── generate_manifest.py                               イメージのマニフェストを書き出す
├── VERSION_CHECKLIST.txt                              4 つのバージョンの仕組み
└── LICENSE.md ruff.toml mypy.ini                      ハードウェアのライセンス、lint と型チェックの設定
```

</details>

各ソースファイルの注釈付き一覧（1 ファイル 1 行）は [docs/SOURCE_MAP.md](docs/SOURCE_MAP.md) にあります。

## 🗺️ ロードマップと既知の制限

**ファームウェア（`src/F303-master/`）：** 全 25 種類のツールプロファイルで機能完全——ヒステリシス付きの熱オン/オフ制御、ツールごとのテレメトリ、通信ウォッチドッグ、失速/障害検出、そして OLED 自身のライブ診断に加え、アクティブツール照会ペア（`0x110`/`0x111`）、拡張コネクター向けの汎用 SPI パススルー（`0x180`/`0x181`）、電源喪失時にも設定値を保持する搭載の F-RAM（`0x190`/`0x191`）、`11111` ジャンパーのフリーツール構成メカニズム（`0x1A2`/`0x1A3`）、共有バス上で複数の（それ以外は同一の）ボードを区別するための周辺機器タイプ + デバイスシリアル番号レポート（`0x1A4`/`0x1A5`）、そしてアドバンスド拡張ボード上の拡張スレーブチップに到達する CAN-to-I2C ブリッジ（`0x210`-`0x221`）。ブートローダーとは独立してバージョン管理されています（下記の変更履歴を参照）。これらはいずれも実機のボード上で動作したことがなく、熱保護はシミュレートしたヒーターを使ってホスト上でテストされているだけです。

**ブートローダー（`src/F303-master/boot/`）：** 機能完全なゴールデンイメージ A/B 更新システム——CRC32 と公開鍵テーブルに対する Ed25519 署名で検査される CAN 経由の OTA 更新、失敗した更新が決してボードをブリックさせないことを保証するバックアップスロット、そしてアプリケーションとは独立した自身のバージョンレポート（`0x7FA`）。クリーンにコンパイル・リンクされます。実際のアクチュエーターが接続された無人環境でこれを信頼する前に、上記のベンチテストの注意事項を参照してください。

**PC ツール：** [URTC Flasher](https://github.com/JuanenRac/URTC-FLASHER)（CAN OTA 更新 + フルチップ SWD/JTAG プログラミング）と [URTC Tester](https://github.com/JuanenRac/URTC-TESTER)（ライブなツールごとの制御/テレメトリテスター）の両方は、それぞれが目指したことについて機能完全であり、今ではそれぞれが独立したプロジェクトとなり、セットアップとすべてのコントロールを詳しくカバーする独自の README を持っています。

**ハードウェア：** 回路図と BOM はまだ最終決定されておらず、上記のいずれかを実際のシリコンに対して検証するための実装済みボードはまだ存在しません。上記のすべてはコンパイル・リンクされ、慎重に検討されていますが、「正しくビルドされる」ことと「ハードウェア上で検証済み」であることは 2 つの異なる主張です——本 README の冒頭の安全上の注意を参照し、新しいボードにふさわしい注意をもって初回の立ち上げに臨んでください。

コミュニティの誰かが PAROL6、Faze4、または他のロボットアームプラットフォーム向けにカスタムエンドエフェクター、スマートツールチェンジャー、あるいは高度なツール統合に取り組んでいるなら、ぜひお話ししたり、アイデアを交換したり、CAN コマンドについてさらに深く掘り下げたりしたいです！

## 🌍 言語

README とテキストは、英語、スペイン語、フランス語、イタリア語、ドイツ語、中国語、日本語、ヨーロッパポルトガル語で提供されています。

## 🔗 関連プロジェクト

URTC は独立したリポジトリで構成され、それぞれに固有のバージョン、テスト、README があります。グループ別のファミリーは次のとおりです：

* **URTC Tool Platform:**
  * **URTC** (このリポジトリ) - ツールヘッドボードのファームウェア（25 のツールプロファイル、CAN ブートローダー）と CAN プロトコルのリファレンス。
  * [URTC-COMMON](https://github.com/JuanenRac/URTC-COMMON) - 一度だけデータとして書かれた CAN プロトコル（仕様、生成された表、適合ベクトル）と、各プログラムが共有するコード。
  * [URTC-FLASHER](https://github.com/JuanenRac/URTC-FLASHER) - CAN または SWD/JTAG でボードのファームウェアを更新するデスクトップツール。
  * [URTC-GATEWAY](https://github.com/JuanenRac/URTC-GATEWAY) - CAN バスの手前に置くゲートウェイ。一覧にある識別子だけを通し、レートを制限し、セッション鍵を求めます。
  * [URTC-SMART-RACK](https://github.com/JuanenRac/URTC-SMART-RACK) - 予熱とライフサイクル追跡を備えたツールラック向けの、ハードウェア非依存の C ロジックとコマンドプロトコル。
  * [URTC-TESTER](https://github.com/JuanenRac/URTC-TESTER) - ボードが報告するツールプロファイルの操作部とテレメトリを表示する、デスクトップ用のライブ CAN バステスター。
  * [URTC-VISION-TOOL](https://github.com/JuanenRac/URTC-VISION-TOOL) - C のセンサーフレームプロトコルと、検査用ツールヘッド向けの Python サーマル/RGB コンパニオン。
  * [URTC-WEB-STUDIO](https://github.com/JuanenRac/URTC-WEB-STUDIO) - Web Serial と SLCAN でボードの書き込みとテストを行うブラウザーアプリ。インストール不要。
* **Ecosystem Operations:**
  * [URTC-DEVTOOLS](https://github.com/JuanenRac/URTC-DEVTOOLS) - ファミリー共通のリポジトリツールを、版数付きの一つのセットとして提供します。ロックファイルで、編集されたコピーと古いままのコピーを見分けられます。
  * [URTC-DOCS](https://github.com/JuanenRac/URTC-DOCS) - エコシステムのアーキテクチャ、インターフェース、セキュリティベースライン、生成されたカタログと、全リポジトリを比較するツール。
  * [URTC-UPDATER](https://github.com/JuanenRac/URTC-UPDATER) - URTC ファミリーのリポジトリを検出・インストール・更新するデスクトップツール。操作は一つずつ明示的に行います。

**姉妹プロジェクト（独立しており、基盤とツールを共有）：**

* **[HYDRA-UMC-DOCS](https://github.com/JuanenRac/HYDRA-UMC-DOCS)** - 姉妹プロジェクト：HYDRA-UMC のドキュメントハブ。基盤とツールを共有する独立したエコシステム
* **[ARMOR-DOCS](https://github.com/JuanenRac/ARMOR-DOCS)** - 姉妹プロジェクト：A.R.M.O.R. セキュリティエコシステムのドキュメントハブ。こちらも独立し、同じ基盤の上にある
* **[JuanenRac](https://github.com/JuanenRac/JuanenRac)** - すべてのエコシステムのプロフィールとステータスダッシュボード

## 📚 ドキュメント

- **[CONTRIBUTING.md](CONTRIBUTING.md)** —— プルリクエストのための技術スタックとコーディング指針。
- **[CODE_OF_CONDUCT.md](CODE_OF_CONDUCT.md)** —— このコミュニティで期待される行動規範。
- **[SECURITY.md](SECURITY.md)** —— 脆弱性の報告方法と、このプロジェクトの実際のセキュリティ重点領域。
- **[SUPPORT.md](SUPPORT.md)** —— 質問の投稿先とバグの報告先。
- **[LICENSE.md](LICENSE.md)** —— このプロジェクト自身のライセンス。

## 🤝 コントリビュートとコミュニティ

* プルリクエストの前に `URTC_CI=1 python tools/ci_validate.py` を実行してください。通過する必要があります。[CONTRIBUTING.md](CONTRIBUTING.md) と[行動規範](CODE_OF_CONDUCT.md)を参照してください。
* README は 8 言語で提供されています。文章の変更は 8 つのファイルすべてで行い、他のリポジトリと共有するセクションは URTC-COMMON の `tools/readme_sections.py` が書き込みます。
* ビルドしただけのものを、ボード上で動いているかのように書かないでください。
* 脆弱性は非公開で報告してください：[SECURITY.md](SECURITY.md)。質問、アイデア、報告：electrohobby3d@gmail.com（[SUPPORT.md](SUPPORT.md)）。

## 👤 作者

**JuanenRac** (Electro Hobby 3D)
📧 electrohobby3d@gmail.com
📺 [youtube.com/@electrohobby3d](https://youtube.com/@electrohobby3d)

## 📜 ライセンス

URTC の著作権は (c) 2026 JuanenRac（Electro Hobby 3D）に帰属します。本プロジェクトまたはその派生物を配布する際は、この表示を必ず含めてください。

本プロジェクトはいくつかの異なる種類のコンテンツで構成されているため、すべてを 1 つのライセンスで無理に統一するのではなく、各部分が実際にカバーする内容に適したライセンスの下で個別に提供されています：

1. `./firmware` にある**ファームウェア**（アプリケーションと CAN ブートローダーの両方）は、**GNU General Public License v3.0（GPL-3.0-or-later）** の下で提供されます。全文は https://www.gnu.org/licenses/gpl-3.0.html を参照してください。

2. **ハードウェア設計**（Eagle 回路図/ボードファイル、Gerber、そして `./PCB` および `./3D` 下の 3D 印刷可能パーツ）は、**CERN Open Hardware Licence v2 - Strongly Reciprocal（CERN-OHL-S v2）** の下で提供されます。全文は https://cern-ohl.web.cern.ch/ を参照してください。

3. **ドキュメント**（本 README およびその自身の翻訳版——`README_spa.md`、`README_ita.md`、`README_fra.md`、`README_deu.md`、`README_zho.md`、`README_jpn.md`——に加えて `./docs` 下のリファレンスファイル）は、**クリエイティブ・コモンズ 表示-継承 4.0 国際（CC BY-SA 4.0）** の下で提供されます。全文は https://creativecommons.org/licenses/by-sa/4.0/ を参照してください。

本プロジェクトを基に開発を行う際は、このライセンス区分を念頭に置いてください：ファームウェアへのコード変更は GPL-3.0-or-later を維持し、ハードウェアの改変は CERN-OHL-S を維持し、ドキュメントの派生物は CC BY-SA を維持してください——いずれも本プロジェクトへの帰属表示を伴う必要があります。

本リポジトリは URTC ボード自身のファームウェアとハードウェアのみを対象としています——かつてここにあった PC ツール（URTC Flasher、URTC Tester）は、今では独自のライセンスを持つ独立したプロジェクトです。上記「PC ツール」を参照してください。
