JuanenRac/URTC/README_spa.md

<p align="center">
  URTC banner
</p>

# 🚀 URTC — Universal Robot Tool Controller

<p align="center">
  <a href="README.md">🇺🇸 English</a> |
  🇪🇸 <b>Español</b> |
  <a href="README_fra.md">🇫🇷 Français</a> |
  <a href="README_ita.md">🇮🇹 Italiano</a> |
  <a href="README_deu.md">🇩🇪 Deutsch</a> |
  <a href="README_zho.md">🇨🇳 简体中文</a> |
  <a href="README_jpn.md">🇯🇵 日本語</a> |
  <a href="README_por.md">🇵🇹 Português</a>
</p>

### El controlador de cabezales de un brazo robótico: una placa STM32F303 con 25 perfiles de herramienta por CAN, un bootloader CAN y un esclavo de expansión

<p align="center">
  
  
  
  
  
  
</p>

---

**Estado: 🚧 Proyecto en evolución activa — existen releases, pero nada se ha ejecutado en una placa real.** Existen releases etiquetadas (v0.3.x), cada una con las imágenes de firmware compiladas desde este código, pero no existe ninguna placa poblada, así que el firmware nunca se ha ejecutado en una placa real. URTC está en desarrollo continuo y activo en ambos frentes a la vez: firmware (nuevos perfiles de herramienta, el ecosistema de esclavos de expansión, cambios de protocolo) y hardware (el esquemático y la BOM todavía se están finalizando, todavía no existe ninguna placa poblada). Como ambos lados se mueven juntos, lo que hay en este repositorio en un momento dado es una instantánea de trabajo en curso, no un producto estable y versionado - los nombres de archivo, la estructura de carpetas, el número de herramientas, y la documentación pueden todos cambiar todavía mientras el diseño se asienta. Una vez que tanto el firmware como el hardware alcancen un estado genuinamente estable y verificado en hardware real, se etiquetará un **Release** propiamente dicho que agrupe todo (firmware, bootloader, herramientas de PC, archivos de diseño de hardware, y documentación) como una instantánea coherente y congelada. Hasta entonces, trata `main` como el objetivo activamente cambiante que es.

---

> **⚠️ Aviso de seguridad (fase de diseño, ninguna placa ha ejecutado aún este firmware):** esta placa controla un **diodo láser de grabado de 10W** y varias etapas de calentamiento (cartucho de soldador T12, hotend de impresora 3D). Construirla y usarla implica trabajar con equipo que puede causar **quemaduras, incendios o daño ocular** si se ensambla o se opera sin las medidas de seguridad adecuadas (gafas láser homologadas para la longitud de onda del diodo, protección térmica, un corte de energía accesible). Este es un proyecto de aficionados (maker) compartido tal cual - constrúyelo y úsalo bajo tu propio riesgo, y no te saltes las prácticas básicas de seguridad solo porque el firmware tenga watchdogs (watchdogs por software que nunca se han ejecutado en una placa real).

> **Estado de seguridad física y de ciberseguridad:** este ecosistema no es un sistema de seguridad certificado y todavía no existe ninguna placa URTC poblada. El bootloader de la placa principal comprueba las imágenes de firmware con CRC32 y una firma Ed25519 contra una tabla de claves públicas y no guarda ningún secreto; el bootloader de la expansión esclava comprueba CRC32 y un SHA-256 sin clave e instala solo una imagen que la placa principal, que verifica el registro Ed25519, le ha confirmado por el bus de enlace interno (confía en la placa principal a través de ese bus). La tabla de la build oficial está vacía hasta que se cree la clave de firma de imágenes, así que un bootloader principal oficial todavía no instala nada, y una build de banco confía en una clave pública de desarrollo, así que cualquiera puede producir una imagen que ese bootloader acepte; no se ha transmitido nada a una placa real. Lee la [línea base de seguridad](https://github.com/JuanenRac/URTC-DOCS/blob/main/docs/SECURITY_BASELINE.md) y el [modelo de amenazas](https://github.com/JuanenRac/URTC-DOCS/blob/main/docs/THREAT_MODEL.md) antes de fiarte de cualquier afirmación de aquí para la seguridad de una persona.

## 📋 De un vistazo

| | |
|---|---|
| Versión | `0.4.8` |
| Madurez | Funcional |
| Tecnología | STM32F303 / bxCAN / 25 tool profiles |
| Destino | Una placa con microcontrolador (el firmware); se compila en un PC |
| En hardware real | Todavía no: no consta ninguna ejecución en hardware real para esta versión |

**Ir a:** [Resumen](#-resumen) · [Arquitectura](#-arquitectura) · [Funciones](#-funciones) · [Seguridad](#-seguridad-y-protección) · [Interfaces](#-interfaces) · [Inicio rápido](#-inicio-rápido) · [Pruebas](#-pruebas) · [Estructura](#-estructura-del-repositorio) · [Relacionados](#-proyectos-relacionados)

<!-- urtc-section:status_firmware -->
## 🚦 Estado del proyecto

🟢 hecho y verificado · 🟡 funciona, con límites conocidos · 🟠 a medias o sin verificar · 🔴 sin hacer o sin funcionar. Nada es verde si nunca corrió en hardware real.

| Parte | Estado | Lo que el repositorio puede demostrar |
| --- | :---: | --- |
| Software | 🟡 | Compila y pasa las pruebas en un PC; la prueba en un cabezal real sigue pendiente. |
| Pruebas | 🟢 | La batería de pruebas pasa en la CI en cada subida. |
| Hardware real | 🟠 | Aún no se ha ejecutado con una placa real: la prueba de banco sigue pendiente. |
| Seguridad | 🟡 | Las versiones se firman con Ed25519 y se comprueban antes de usarlas; el manejo de las claves no lo ha revisado nadie más. |
| Interfaz y protocolos | 🟡 | Las rutas o los mensajes que ofrece están documentados y probados con un cliente; aún no los han usado todos los clientes |
| Actualizaciones | 🟠 | Las imágenes se actualizan por el bus CAN con el bootloader; una actualización firmada, una firma alterada y un id de hardware ajeno se prueban con el bootloader compilado para el PC, nunca en una placa |
| Documentación | 🟡 | README en ocho idiomas y documentos de referencia; las traducciones no las ha revisado ningún hablante nativo. |

<!-- /urtc-section:status_firmware -->

## 🎯 Resumen

¡Hola a todos! Quería compartir un proyecto que he estado desarrollando llamado URTC (Universal Robot Tool Controller). Es una placa de control monolítica y altamente integrada, diseñada específicamente para expandir las capacidades de brazos robóticos y configuraciones de automatización, lo que la convierte en una pareja perfecta para plataformas como PAROL6 y Faze4 — dos brazos robóticos de código abierto diseñados y desarrollados por [Source-Robotics](https://source-robotics.com/) ([GitHub](https://github.com/Source-Robotics)).

**URTC es un proyecto independiente y no oficial.** No está desarrollado ni respaldado por Source-Robotics — es un controlador de cabezal de herramienta compatible, construido para funcionar bien con PAROL6 y Faze4, y la misma arquitectura basada en CAN está abierta para adaptarse también a otras plataformas de brazos robóticos.

Aquí está el desglose completo de qué es, qué hace, y el ecosistema de hardware que gestiona actualmente.

URTC es una placa de control todo-en-uno y compacta, impulsada por un microcontrolador STM32 (STM32F303CCT6, LQFP48). Se comunica con el controlador principal del robot por bus CAN, pensada para ejecutar con baja latencia tareas complejas directamente en el cabezal de la herramienta o en el eje (la latencia nunca se ha medido en una placa y no se promete tiempo real estricto). Cuenta con una pantalla OLED integrada para diagnóstico instantáneo — splash de arranque animado, iconos animados por herramienta, telemetría en vivo en un panel de dos tonos — un LED RGB de estado de un solo píxel más un anillo de LED RGB direccionable para iluminación de cámara, un conector de expansión de 20 pines para placas adicionales, una F-RAM integrada que persiste los setpoints de la herramienta activa a través de un corte de energía, y etapas dedicadas de potencia analógica y de alta corriente.

## 🧩 Papel en URTC

URTC es la placa y su firmware: la parte del ecosistema que va en el cabezal del robot y hace el trabajo, con un bootloader CAN que permite actualizar la aplicación por el mismo cable. Todo lo demás de la familia se construye a su alrededor. URTC-COMMON escribe su protocolo CAN una sola vez como datos, URTC-FLASHER y URTC-TESTER lo actualizan y lo ejercitan desde un PC (URTC-WEB-STUDIO hace ambas cosas en un navegador), URTC-GATEWAY puede ponerse delante de su bus, URTC-SMART-RACK guarda los cabezales, URTC-VISION-TOOL es un cabezal que inspecciona, URTC-UPDATER mantiene al día los programas y URTC-DOCS guarda la arquitectura y lo que está probado. Está pensado para brazos robóticos como PAROL6 y Faze4 y es un proyecto independiente y no oficial. Todavía no existe ninguna placa montada.

## 🏛️ Arquitectura

<p align="center">
  Arquitectura de URTC: quién lo usa, qué contiene y de qué depende
</p>

Cómo encajan las partes de este repositorio: quién lo usa, qué contiene y de qué depende. La imagen se dibuja desde `docs/architecture.json` y se comprueba contra el código.

### Arquitectura Escalable y Matriz de Herramientas

La fortaleza principal de URTC es su extrema versatilidad. En vez de cambiar la electrónica para cada trabajo distinto, la placa presenta una arquitectura de matriz escalable:

* **Esquema de identificación de 32 direcciones:** el hardware y el protocolo de comunicación están diseñados para identificar hasta 32 herramientas o efectores finales distintos directamente en el cabezal del robot, mediante una matriz de identificación de 5 bits por jumper de soldadura (ID0-ID4). De esas 32 lecturas, 31 se mapean directamente a un perfil de herramienta; la número 32 (los 5 jumpers instalados, `11111`) está reservada como dirección de "configuración libre" en su lugar - ver abajo.
* **25 perfiles automatizados plug-and-play:** el firmware maneja nativamente 25 perfiles de herramienta - la placa lee la identidad física del cabezal de herramienta y configura las etapas de potencia, sensores, y la lógica de conmutación de forma transparente sin necesidad de una regrabación completa. Quedan 6 direcciones más libres dentro del esquema existente para futuros perfiles de herramienta.
* **Configuración libre de herramienta:** la lectura de jumper reservada `11111` no elige una herramienta fija - le indica a la placa que busque qué herramienta usar en un registro de su propia F-RAM persistente, establecido de antemano por CAN (mediante `URTC Flasher`). Útil para una placa que necesita reprogramarse a una herramienta distinta sin volver a soldar jumpers físicamente. Ver `docs/EEPROM.TXT` sección 5 para el mecanismo completo.

### Distribución de la memoria flash (256K total, modelo de imagen dorada / actualización A-B)

```
0x08000000 ┌─────────────────────────────────┐
           │  Bootloader (30K)                 │  Siempre se ejecuta primero en cada
           │                                   │  arranque. Escucha brevemente por
           │                                   │  CAN, y luego o salta a la app o
           │                                   │  espera una actualización. Controla
           │                                   │  el OLED directamente durante una
           │                                   │  actualización (ver abajo).
0x08007800 ├─────────────────────────────────┤
           │  Página de metadatos (2K)         │  Describe lo que sea que haya en el
           │                                   │  slot principal en este momento:
           │                                   │  HardwareID, versión, tamaño, CRC32,
           │                                   │  y una firma SHA-256. El
           │                                   │  bootloader lo comprueba todo antes
           │                                   │  de saltar a la app.
0x08008000 ├─────────────────────────────────┤
           │  Slot principal (112K)            │  Este es el firmware de aplicación /
           │                                   │  URTC_MAIN_FIRMWARE_v<version>.* — el firmware
           │                                   │  real que se ejecuta día a día,
           │                                   │  descrito en el resto de este
           │                                   │  README. Nunca se toca en una
           │                                   │  actualización hasta que una imagen
           │                                   │  verificada y buena conocida está
           │                                   │  lista para reemplazarlo.
0x08024000 ├─────────────────────────────────┤
           │  Slot de respaldo / staging (112K)│  Solo almacenamiento en bruto,
           │                                   │  nunca ejecutado directamente. Cada
           │                                   │  actualización CAN escribe aquí
           │                                   │  primero.
0x08040000 └─────────────────────────────────┘
```

**Por qué un slot de respaldo.** Una actualización CAN nunca se escribe en el slot que está corriendo actualmente. Va al respaldo primero, se verifica completamente ahí — tamaño, CRC32, y una firma Ed25519 comprobada contra la tabla de claves públicas del bootloader, que muestra que la hizo quien posee una clave de confianza, no solo que llegó intacta — y solo entonces se copia al slot principal. Una pérdida de energía en cualquier punto antes de que empiece esa copia deja el firmware actualmente en ejecución completamente intacto, así que no hay ninguna ventana en la que una descarga interrumpida pueda inutilizar la placa. Si la pérdida de energía ocurre *durante* la propia copia, el bootloader se da cuenta en el siguiente arranque (el respaldo, nunca tocado durante la copia, sigue completamente intacto) y simplemente retoma la copia desde ahí hasta que tiene éxito.

## 🖼️ Capturas de pantalla

URTC v1.0

*(Trabajo en progreso — más ángulos y una placa poblada llegarán pronto.)*

## ✨ Funciones

### Flexibilidad de Hardware y Soporte de Motores

Para manejar una variedad tan amplia de aplicaciones, el hardware de URTC está completamente equipado para controlar:

* **Motores paso a paso NEMA:** NEMA 8, 11, 14, y 17 funcionan directamente desde el TMC2209 integrado, lo mismo que NEMA 23 y 34 - hasta **2,0 A** en cualquiera de ellos mediante la etapa de driver de la placa principal. Para NEMA 23/34 a su par nominal completo, un TMC5160 en el conector de expansión (ver abajo) soporta hasta **10 A**, escalado en corriente por los MOSFETs externos/resistencia de sensado elegidos para esa placa - el límite de 2,0 A integrado no aplica una vez que un motor se ha movido al driver de expansión.
* **Motores BLDC de 3 fases / motores gimbal** para movimiento de alta precisión.
* **Motores con sensores Hall y tacómetros** para control en lazo cerrado.
* **Entradas dedicadas** para sensores de proximidad óptica reflectivos como el TCRT5000, más una entrada genérica de fin de carrera/límite activa en bajo, compartida entre cuatro perfiles de herramienta.

### Conector de Expansión

Un header de 20 pines, separado de los conectores específicos de herramienta, para placas adicionales que necesiten más de lo que un perfil de herramienta dado expone por sí solo - un eje paso a paso extra (TMC2209 o TMC5160), una segunda placa de sensores, ese tipo de cosas.

| Pines | Señal |
|---|---|
| 4 | 24 V |
| 1 | 3,3 V |
| 1 | 5 V |
| 3 | GND |
| 2 | I2C por bit-banging (SCL/SDA) — su propio bus, separado del I2C2 por hardware del OLED/F-RAM |
| 3 | STEP/DIR/EN — universal para cualquiera de los 2 chips driver de abajo |
| 4 | SPI por bit-banging (CS/SCK/MISO/MOSI) — para la interfaz de configuración/diagnóstico de un TMC5160, o cualquier otro chip configurable por SPI |
| 1 | GPIO de propósito general (entrada de interrupción capaz de EXTI si un futuro complemento necesita una respuesta rápida de sensor, p. ej. un fin de carrera) |
| 1 | TMC5160 DIAG0 (línea de diagnóstico de stall/fallo, consultada vía `0x182`/`0x183`) |

20 pines en total.

**Dos buses I2C separados a propósito:** el OLED/F-RAM usan el único periférico I2C por hardware utilizable de este chip (I2C2, en PA9/PA10); el conector de expansión obtiene su propio bus I2C independiente por bit-banging (PB10/PB11 - los únicos otros pares de pines capaces de I2C de este chip ya estaban comprometidos con otras funciones, así que el bit-banging fue la forma de darle a este conector su propio bus sin un conflicto de hardware). Cualquier cosa colgada del header de expansión — un ADC/DAC I2C, un expansor de puertos, lo que sea que una placa adicional dada necesite — comparte este bus por bit-banging con cualquier otro dispositivo I2C del lado de expansión, pero no puede estirar el reloj (clock stretching) ni interferir de otro modo con la propia temporización del OLED en su bus separado, I2C2 por hardware.

**Un TMC2209 o un TMC5160, no necesariamente ambos.** Ambos chips usan la misma interfaz STEP/DIR/EN para el movimiento real, así que esa parte es universal. Donde difieren es en configuración/diagnóstico: un TMC2209 usa su propio UART de un solo hilo para eso, mientras que un TMC5160 usa SPI — y dado que los 2 son mutuamente excluyentes en cualquier placa de expansión dada, los 4 pines SPI también sirven de forma natural como hogar para la única línea UART de un TMC2209, en vez de necesitar todavía otro pin dedicado que nadie usa al mismo tiempo que el bus SPI. El bus SPI por bit-banging habla exactamente el protocolo que un TMC5160 espera (SPI Modo 3, MSB primero, CS mantenido en bajo durante toda la transacción — ver `docs/CANBUS.TXT`, `0x180`/`0x181` para el comando genérico de paso-de-bytes que lo controla) en vez de que este firmware necesite conocer la disposición de registros específica de ese chip. La línea DIAG0 de stall/fallo de un TMC5160 también está cableada (`0x182`/`0x183`) — reutiliza uno de los 2 pines GPIO de propósito general, que ya estaban reservados exactamente para este tipo de entrada rápida impulsada por interrupción.

El detalle completo pin por pin — qué pin del MCU respalda qué señal, y el razonamiento detrás de un par de restricciones de disposición que tiene el paquete de 48 pines de este chip — vive en `docs/PINOUT_CONNECTORS.TXT` y `src/F303-master/README.md`.

#### Las 6 variantes de placa de expansión

4 de las 6 variantes de placa de expansión llevan un driver de motor paso a paso — ya sea un TMC2209 (hasta 2A/bobina, MOSFETs de potencia integrados) o un TMC5160A (hasta 10A+/bobina, necesita 8 MOSFETs de potencia externos que el propio driver no incluye). Independientemente de esa elección de driver, una placa con driver es o bien **básica** (driver + conectores solamente, sin MCU — STEP/DIR/EN enrutado directamente desde la placa principal) o **avanzada** (añade un segundo microcontrolador, STM32F303CBT6, más 2 chips de sensor locales — un ADC de 16 bits ADS1115 y una cámara térmica de la familia MLX9064x — y generación local de PWM para herramientas cuya temporización necesita generarse justo en el cabezal de herramienta en vez de enrutarse por un cable). 2×2 combinaciones, más 2 placas básicas solo-sensor adicionales (ADS1115 o MLX9064x, cableadas directamente a la propia STM32F303CC de la placa principal, sin driver y sin MCU esclavo) para una herramienta que solo necesita uno de esos 2 chips y nada más de lo que también lleva una placa avanzada — 6 placas en total — ver `BOM/BOM_EXPANSION_*.TXT` (6 archivos), `docs/EXPANSION.TXT`, y `docs/PINOUT_SLAVE.txt`.

La propia STM32F303CBT6 de la variante avanzada habla con la placa principal a través del bus I2C por bit-banging ya existente del conector de expansión de arriba — placa principal como maestro, chip esclavo respondiendo como un verdadero esclavo I2C por hardware — y controla su propio segundo bus I2C, local únicamente, para los 2 chips de sensor. Tiene su propio bootloader y firmware de aplicación, actualizados de la misma forma que la placa principal (CAN-OTA desde `URTC Flasher`), solo que retransmitidos a través de ese enlace I2C en vez de alcanzar el chip esclavo directamente. Ver `src/F303-slave/README.md` y `src/F303-slave/boot/README.md` para el detalle técnico completo.

### Persistencia de Parámetros

Una F-RAM FM24CL64B integrada (64Kbit, I2C) mantiene una instantánea actualizada periódicamente de los setpoints de la herramienta activa y de los ajustes globales de LED/OLED, para que un corte de energía repentino no deje "qué estaba haciendo esta placa" tan desconocido como fue imprevista la propia pérdida de energía. Comparte el bus I2C2 por hardware del OLED en vez de tener uno propio — este MCU solo tiene un periférico I2C por hardware utilizable para este propósito, ya reclamado por el OLED (ver `src/F303-master/README.md` sección 6 para el razonamiento completo).

**El estado recuperado es consultable, nunca auto-aplicado a nada peligroso.** Al arrancar, lo que se guardó se vuelve legible por CAN (`0x190`/`0x191`) — pero un setpoint de calentador, la potencia del láser, o un comando de motor nunca se rearman silenciosamente por sí solos. Solo los ajustes seguros y pasivos (colores de LED, modo OLED) se restauran directamente. Reenviar deliberadamente un setpoint después de realmente revisar qué pasó se deja como decisión del controlador maestro, no algo que esta placa decida por sí misma en el instante en que vuelve la energía.

### Catálogo de Herramientas Automatizadas Nativamente (25 Perfiles de Firmware)

Mediante su lógica de conmutación dinámica, el firmware maneja nativamente los siguientes cabezales de herramienta:

1. **Estación de soldadura (T12):** control de temperatura con histéresis (todo/nada, no PID) usando retroalimentación directa de ADC para manejar puntas de soldador T12 estándar, más un alimentador de hilo motorizado que bobina el hilo de soldadura hacia la unión (comparte `CONN_MOT` y su protocolo de motor paso a paso con las herramientas de movimiento simple de abajo - cede la propia entrada de fin de carrera genérica de esta herramienta para hacerle sitio). [Configuración de jumper/cableado →](images/TOOL_SOLDERING_IRON.png)
2. **Dispensador de pasta de soldadura SMT:** control de alimentación milimétrico para deposición precisa de pasta de soldadura en PCBs. [Configuración de jumper/cableado →](images/TOOL_PASTE_DISPENSER.png)
3. **Dispensador de pasta térmica / líquido:** gestión de fluidez para pastas de alta viscosidad o adhesivos líquidos. [Configuración de jumper/cableado →](images/TOOL_LIQUID_DISPENSER.png)
4. **Destornillador eléctrico inteligente:** control de rotación y parada a través de la interfaz paso a paso. Previsto: parada por límites de torque (todavía no existe sensado de torque). [Configuración de jumper/cableado →](images/TOOL_SCREWDRIVER.png)
5. **Pinza de vacío / neumática:** control de bomba de vacío y lectura de nivel de presión para operaciones seguras de Pick-and-Place. [Configuración de jumper/cableado →](images/TOOL_VACUUM_PICKUP.png)
6. **Taladro (BL4260):** control de velocidad PWM, cambio de dirección, y frenado eléctrico dinámico con lecturas de RPM en vivo, en su propia línea dedicada de habilitación/freno, independiente de la habilitación del driver de herramientas paso a paso. Entrada de fin de carrera genérica disponible. [Configuración de jumper/cableado →](images/TOOL_DRILL.png)
7. **Pinza gimbal:** manipulación de alta sensibilidad usando motores gimbal brushless de 3 fases. [Configuración de jumper/cableado →](images/TOOL_GRIPPER_GIMBAL.png)
8. **Pinza NEMA:** fuerza de sujeción robusta controlada mediante un motor paso a paso de trabajo pesado. [Configuración de jumper/cableado →](images/TOOL_GRIPPER_NEMA.png)
9. **Sistema AOI (Inspección Óptica Automatizada):** control estroboscópico síncrono de la matriz de iluminación LED para captura de cámara de visión artificial. Entrada de fin de carrera genérica disponible. [Configuración de jumper/cableado →](images/TOOL_AOI_INSPECTION.png)
10. **Diodo láser de grabado (10W óptico):** modulación PWM de potencia del haz con un watchdog CAN por software que bloquea la salida del láser si se pierde la comunicación con el host (compilado, nunca ejecutado en una placa real, y no sustituye a un enclavamiento de hardware independiente). Entrada de fin de carrera genérica disponible. [Configuración de jumper/cableado →](images/TOOL_LASER_ENGRAVER.png)
11. **Hotend de impresión 3D:** control todo/nada con histéresis del cartucho calentador, lectura de termistor NTC, control de extrusor, y un ventilador dedicado de enfriamiento de capa controlado por PWM de 25kHz (4 hilos, retroalimentación de tacómetro, watchdog de comunicación propio) — todo integrado en un solo bloque. [Configuración de jumper/cableado →](images/TOOL_3D_PRINTER.png)
12. **Sonda de escáner 3D:** entrada de interrupción por hardware ultrarrápida (EXTI) con prioridad absoluta para digitalización de superficie en tiempo real y detección de impacto sin retraso. También cubre el palpado táctil de metrología - la misma ruta de hardware, una sonda física distinta en el mismo cabezal de herramienta. [Configuración de jumper/cableado →](images/TOOL_SCAN_PROBE.png)
13. **Cabezal Pick & Place SMT:** eje rotativo A para alineación correcta de pads, en la misma interfaz de motor paso a paso que los dispensadores de pasta/líquido y ambas pinzas de arriba. [Configuración de jumper/cableado →](images/TOOL_SMT_PICKPLACE.png)
14. **Electroimán de trabajo pesado:** control de recogida on/off para piezas ferromagnéticas, desde la salida del calentador T12 reutilizada como driver GPIO genérico. [Configuración de jumper/cableado →](images/TOOL_ELECTROMAGNET.png)
15. **Cabezal de soldadura por puntos:** pulsos de soldadura de precisión de milisegundos para tiras de níquel de packs de baterías, con un sensor de contacto de superficie que controla el pulso. [Configuración de jumper/cableado →](images/TOOL_SPOT_WELDER.png)
16. **Aerógrafo de recubrimiento conformal:** control de aspersión de recubrimiento protector para PCBs terminadas - la válvula de aspersión y su propio sensor viven en la propia placa principal del robot, fuera del alcance propio de esta placa. [Configuración de jumper/cableado →](images/TOOL_CONFORMAL_COATING.png)
17. **Pinza de vacío de gran formato:** matriz de ventosas para placas FR4 sin poblar, en la misma interfaz de motor paso a paso que la herramienta #13 de arriba. [Configuración de jumper/cableado →](images/TOOL_VACUUM_GRIPPER_LG.png)
18. **Cabezal de pruebas funcionales:** pruebas de tensión y continuidad con sonda voladora — lectura básica desde el ADC integrado, lectura avanzada mediante un ADC de 16 bits ADS1115 en una placa de expansión **avanzada**. [Configuración de jumper/cableado →](images/TOOL_FLYING_PROBE.png)
19. **Cabezal de curado UV:** driver de LED UV de alta potencia para curado instantáneo de pegamento/máscara. [Configuración de jumper/cableado →](images/TOOL_UV_CURING.png)
20. **Boquilla de retrabajo de aire caliente:** elemento calefactor, soplador de turbina, y retroalimentación de termopar para reflow de piezas SMD desalineadas - comparte el propio lazo de control térmico del soldador. [Configuración de jumper/cableado →](images/TOOL_HOTAIR_REWORK.png)
21. **Insertador neumático de presión (press-fit):** control de actuador lineal para presionar conectores en PCBs - el actuador y su propio sensor viven en la propia placa principal del robot, fuera del alcance propio de esta placa. [Configuración de jumper/cableado →](images/TOOL_PRESSFIT_INSERTER.png)
22. **Actuador de arnés de cables / engarzado (crimping):** mordaza de alto torque para pelar/engarzar terminales, impulsada por el **propio driver de una placa de expansión** en vez del de la placa principal. El firmware no tiene sensado de torque ni de fuerza. [Configuración de jumper/cableado →](images/TOOL_CRIMPING_ACTUATOR.png)
23. **Inspección avanzada de PCB:** imagen térmica (matriz de la familia MLX9064x - los 3 miembros de la familia, MLX90640/MLX90641/MLX90642, soportados hoy, ya sea mediante el propio chip esclavo de una placa de expansión **avanzada** o una placa de expansión **básica** MLX9064x cableada directamente a la placa principal) para detectar cortocircuitos por firma de temperatura, junto con iluminación por anillo de LED. También cubre el depanelizado por micro-husillo - la misma ruta de hardware del taladro de arriba, un bit distinto para un trabajo distinto. [Configuración de jumper/cableado →](images/TOOL_THERMAL_INSPECTION.png)
24. **Válvula de jetting de pasta de soldadura:** dispensación de micro-gotas piezoeléctrica, precisión de pulso sub-milisegundo generada localmente en una placa de expansión **avanzada**. [Configuración de jumper/cableado →](images/TOOL_PASTE_JETTING.png)
25. **Soldador ultrasónico / sellador de envases:** disparo de transductor de alta frecuencia para soldadura de carcasas plásticas. [Configuración de jumper/cableado →](images/TOOL_ULTRASONIC_WELDER.png)

*(Existen imágenes de configuración de herramienta para las herramientas 1-12; las imágenes para las herramientas 13-25 se irán completando a medida que la documentación de hardware se ponga al día - los nombres de archivo de arriba coinciden con la convención de nomenclatura ya en uso en `images/`.)*

### Interfaz OLED Local

Cada cabezal de herramienta muestra telemetría en vivo, específica de la herramienta, en un OLED de dos tonos de 128×64: un splash de arranque animado al encender, un indicador parpadeante de actividad CAN, una lectura "hero" en vivo en la franja superior (temperatura, RPM, potencia — lo que más importe para la herramienta activa), y un pequeño icono animado de cuatro fotogramas por perfil de herramienta.

#### El módulo

Ambas variantes físicas de abajo son el mismo panel eléctricamente (controlado por SSD1306 o SSD1315 - la secuencia de inicialización del firmware está verificada como compatible con ambos, ver `OLED_Init()` en `firmware_oled_driver.c`; el SSD1315 es un controlador de reemplazo directo más nuevo que muchos módulos llevan hoy bajo el mismo listado/serigrafía "SSD1306"), **128×64**, y la misma división de dos tonos "amarillo/azul", donde el propio material de LED físico está dividido en 2 zonas de color fijo (esto no es seleccionable por software):

* **16 píxeles superiores (páginas 0-1): amarillo.** URTC usa esta franja para lo que sea más útil de ver de un vistazo sin leer con detalle - el indicador de actividad CAN, lecturas hero en vivo, o (en el splash de arranque / pantallas de herramienta inválida) texto de estado corto.
* **48 píxeles inferiores (páginas 2-7): azul.** Todo lo demás - iconos de herramienta, telemetría detallada, la cara animada de JuanenBOT en la pantalla de splash, la gran palabra ERROR parpadeante.

Ambos van al mismo bus I2C2 y en el mismo `OLED_Init()` — el firmware no puede saber cuál de los 2 está conectado, y no lo necesita. Son mutuamente excluyentes en una placa dada (ver la nota `CONN_OLED2` de `BOM/BOM.TXT` - el nombre que usa este documento para lo que el esquemático llama `LCD1`).

##### Opción A — montaje directo (`CONN_OLED2`, el footprint realmente poblado en la placa)



Un panel desnudo sin PCB de breakout separado - solo el cristal y su cinta FPC de 30 pines, soldada directamente en el footprint `CONN_OLED2` (`FPC30`, WiseChip UG-2864, el nombre que usa este documento para lo que el esquemático llama `LCD1` — ver `BOM/BOM.TXT` y `URTC_NETLIST.TXT`). De los 30 pines, solo un subconjunto está realmente cableado — el resto es el bus de interfaz paralela del panel (`D2`–`D7`, `RW`, `E/!RD`), dejado sin conectar ya que la placa solo le habla por I2C:

| Pin(es) CONN_OLED2 | Net | Función |
|---|---|---|
| 1, 8, 29, 30 | GND / AGND | Tierra |
| 9 | VDD | Alimentación lógica (desde `+3V3B`, el carril de alimentación exclusivo del OLED — ver BOM §1) |
| 28 | VCC | Alimentación del panel |
| 2–5 | C2P/C2N/C1P/C1N | Condensadores de bomba de carga — `C26`/`C27` en la BOM |
| 26 | IREF | Resistencia de ajuste de corriente de referencia |
| 27 | VCOMH | Desacoplo de la tensión común interna |
| 10, 12 | BS0, BS2 | Conectados a GND |
| 11 | BS1 | Conectado a `+3V3B` |
| 18 | D0/SCK | I2C2 SCL — PA9 |
| 19 | D1/DIN/SDA | I2C2 SDA — PA10 |

`BS0`/`BS1`/`BS2` son el propio strap de selección de interfaz del panel (GND/VCC/GND aquí), fijo en hardware en vez de expuesto al MCU — esto es lo que pone al controlador en modo I2C en primer lugar, en vez del modo paralelo 8080/6800 al que pertenecen los otros 22 pines FPC.

##### Opción B — módulo breakout (`CONN_OLED`, alternativa externa)



El mismo panel pre-montado en una pequeña placa portadora con un header de 4 pines - útil si prefieres cablear un módulo comercial en vez de conseguir el panel FPC desnudo. Cableado directamente a `CONN_OLED` sin necesidad de cruzar nada — el propio orden de pines del módulo (`GND · VDD · SCK · SDA`) coincide exactamente con el pinout de `CONN_OLED`, pin por pin:

| Pin del módulo OLED | Pin CONN_OLED | Señal |
|---|---|---|
| GND | 1 | Tierra |
| VDD | 2 | +3,3 V (alimentación lógica de la pantalla) |
| SCK | 3 | SCL — PA9, I2C2 por hardware |
| SDA | 4 | SDA — PA10, I2C2 por hardware |

#### Splash de arranque



#### Iconos de herramienta (uno por perfil, animación de 4 fotogramas)

<table>
<tr>
<td align="center"><br>Soldador T12</td>
<td align="center"><br>Dispensador de Pasta</td>
<td align="center"><br>Dispensador de Líquido</td>
<td align="center"><br>Destornillador</td>
</tr>
<tr>
<td align="center"><br>Pinza de Vacío</td>
<td align="center"><br>Taladro (BL4260)</td>
<td align="center"><br>Pinza Gimbal</td>
<td align="center"><br>Pinza NEMA</td>
</tr>
<tr>
<td align="center"><br>Inspección AOI</td>
<td align="center"><br>Grabador Láser</td>
<td align="center"><br>Hotend de Impresora 3D</td>
<td align="center"><br>Sonda de Escáner 3D</td>
</tr>
<tr>
<td align="center"><br>Pick & Place SMT</td>
<td align="center"><br>Electroimán</td>
<td align="center"><br>Soldador por Puntos</td>
<td align="center"><br>Recubrimiento Conformal</td>
</tr>
<tr>
<td align="center"><br>Pinza de Vacío (LG)</td>
<td align="center"><br>Sonda Voladora</td>
<td align="center"><br>Curado UV</td>
<td align="center"><br>Retrabajo de Aire Caliente</td>
</tr>
<tr>
<td align="center"><br>Insertador Press-Fit</td>
<td align="center"><br>Actuador de Engarzado</td>
<td align="center"><br>Inspección Térmica</td>
<td align="center"><br>Jetting de Pasta</td>
</tr>
<tr>
<td align="center"><br>Soldador Ultrasónico</td>
</tr>
</table>

#### Advertencia de ID de herramienta inválida

Si los jumpers de ID no coinciden con ninguno de los 25 perfiles asignados, la placa bloquea todos los actuadores y parpadea esto en su lugar:



Todos los GIFs fuente de las animaciones viven en [`/ani`](ani/).

### LED de Estado Digital

Separado del OLED y del anillo de iluminación de 8 píxeles, `CONN_LED1` lleva un único LED RGB direccionable (familia WS2812B, controlado por SPI/DMA) dedicado al estado de un vistazo.

**Automático por defecto, anulable por el host bajo demanda.** El firmware colorea este LED por sí mismo, con prioridad de 3 vías:

* 🔴 **Rojo** — hay un fallo de hardware activo (`system_error_flag`). Siempre gana, sin importar qué más esté pasando.
* 🔵 **Azul** — la placa está funcionando activamente: llegó una trama CAN (cualquier ID) en los últimos 1,5 segundos.
* 🟢 **Verde** — inactiva, esperando comandos: sin tráfico CAN en más de 1,5 segundos.

El maestro todavía puede anular esto en cualquier momento enviando el ID CAN `0x100` (DLC 8) con la intensidad de rojo, verde, y azul como los primeros 3 bytes (0-255 cada uno — color completo de 24 bits, no solo los 3 automáticos). Un color enviado por el host se mantiene 10 segundos antes de volver al esquema automático — suficiente para realmente verse, lo bastante corto para que la placa no se quede atascada mostrando un color personalizado obsoleto si el host deja de actualizarlo. Enviar `0x100` de nuevo (ya sea el mismo color o uno nuevo) renueva esa ventana de 10 segundos, así que un host que quiera mantener control personalizado solo necesita seguir enviándolo periódicamente. Un fallo de hardware siempre interrumpe una anulación activa — el rojo tiene prioridad sobre cualquier color que el host hubiera establecido.

Ver `docs/CANBUS.TXT` (ID `0x100`) para la disposición exacta de los bytes, que también comparte este mismo mensaje con el control del anillo de LED y del modo nocturno del OLED.

## 🔒 Seguridad y protección

- **Protección contra embalamiento térmico** (`thermal_guard.c`, desde la aplicación 0.3.2) en el soldador / aire caliente y el hotend 3D: un MAXTEMP sobre la temperatura *medida* (449 °C T12, 310 °C hotend), una vigilancia de calentamiento (la temperatura debe subir de verdad con el calentador encendido - detecta un termistor o una punta suelta) y una comprobación de mantenimiento (una vez alcanzado el objetivo, sin caídas largas con el calentador encendido). Un fallo corta el calentador, enclava el error de la placa e indica la causa en el byte 4 de `0x111`. Probado en host con un calentador simulado (`tests/test_thermal_guard.c`). Sus límites nunca se han medido con un calentador real, y nada de esto se ha ejecutado en una placa.
- **Pruebas de host de la lógica del firmware alrededor del hardware** (`tools/run_host_tests.py`, 58 suites): además del bootloader, la protección térmica y el despachador, los manejadores CAN reales de las 13 herramientas (`firmware_can_*.c`), los bucles de control del calentador (`firmware_control_thermal.c`: conversión del ADC, lecturas imposibles, techos de la consigna, histéresis, calentador atascado, las averías de la guardia), el registrador de fallos (`firmware_blackbox.c`, comparado byte a byte con los escenarios que URTC-COMMON escribe desde su propio modelo, y su lectura por CAN), la identificación de la herramienta por los puentes, los comandos tras la puerta de error y los comandos de la cámara térmica se compilan contra una HAL falsa (`tests/host_hal/`) y se ejecutan bajo los sanitizers de direcciones y de comportamiento indefinido y `gcc -fanalyzer`; `--coverage-floor` (`URTC_COVERAGE_FLOOR` en la CI) los obliga a una parte de líneas ejecutadas (94,0 por ciento de las líneas de las 83 fuentes del firmware que compilan las suites (3 de 88 necesitan la placa y 2 solo contienen datos, los huecos de cabecera), que ahora incluyen el arranque y el bucle principal de la aplicación, el controlador del OLED y sus pantallas, el LED de estado, los manejadores de interrupción, los buses del conector de expansión, las tres cámaras térmicas, el esclavo de expansión y los programas principales de los dos bootloaders; el mínimo de la CI es 90). Nada de esto ha corrido en una placa.
- **Diagnóstico:** el byte 5 de `0x111` indica la causa del último reinicio (bit0 = saltó el watchdog de hardware); `0x1AA`/`0x1AB` devuelven contadores de vida guardados en F-RAM - fallos térmicos, código del último fallo y tiempo total con el calentador encendido (desde 0.3.3); las muestras de la caja negra registran el código de fallo térmico.
- **Firma del firmware:** el bootloader de la placa principal no guarda ningún secreto: verifica un registro Ed25519 contra una tabla de claves públicas (`keys/image_trust.json`), compilada como tabla de banco con una clave pública de desarrollo o como tabla oficial, que está vacía hasta que se cree la clave de firma de imágenes. El bootloader de la expansión esclava no guarda ninguna clave de firma en su ruta de actualización: instala una imagen solo cuando la placa principal, tras verificar el registro Ed25519, le confirma esa imagen exacta en esa sesión de actualización, y confía en la placa principal a través del bus de enlace interno (véase [`docs/SLAVE_BOOT_CONFIRMATION.md`](docs/SLAVE_BOOT_CONFIRMATION.md)); no contiene ninguna clave ni rutina HMAC, y guarda su propio contador de retroceso firmado en un registro de solo anexado, que la placa principal también lee y exige. Cada imagen de `firmware/` se entrega con `<bin>.sha256` y `<bin>.manifest.json`, así que URTC Flasher y URTC Web Studio no llevan ninguna clave. Véase [`docs/FIRMWARE_SIGNING.TXT`](docs/FIRMWARE_SIGNING.TXT). Cada recurso de una release oficial lleva además una firma de release Ed25519 separada (`<recurso>.sig`, clave pública en [`docs/RELEASE_SIGNING.md`](docs/RELEASE_SIGNING.md)); el flasher y el web studio la verifican cuando existe.
- **La cabecera dentro de la imagen:** las imágenes de aplicación llevan su propia identidad en 32 bytes en el desplazamiento fijo `0x200`, después de la tabla de vectores: el hardware al que van destinadas, la versión con cuatro componentes, la longitud y el CRC-32 de toda la imagen. El firmware emite el hueco (`firmware_image_slot.c`, `slave_image_slot.c`) y el script del enlazador lo coloca, y el enlace falla si la tabla de vectores no termina antes; `tools/seal_image.py` rellena la longitud y el CRC-32 después del enlace. El mapa de la flash, la tabla de vectores y la longitud de la imagen no cambian, el registro de firma se hace exactamente igual que antes sobre el archivo sellado y los bootloaders no cambian. Nada de esto ha corrido en una placa.
- **Bus CAN:** no autentica al emisor - cualquier nodo puede mandar a las herramientas. Las instalaciones con láser, calentadores o soldadura **deben** tener un enclavamiento de hardware independiente del MCU y un bus cerrado: [`docs/CAN_THREAT_MODEL.TXT`](docs/CAN_THREAT_MODEL.TXT).
- **Varios cabezales de herramienta en un mismo bus CAN (desactivado por defecto):** un interruptor persistente (CAN `0x1AC` lo cambia, `0x1AD` lo lee, el registro de F-RAM se describe en [`docs/EEPROM.TXT`](docs/EEPROM.TXT)) activa las direcciones de nodo tomadas de los cinco jumpers de ID, el descubrimiento y una regla de selección: solo el cabezal seleccionado obedece órdenes y un cabezal no seleccionado nunca acciona nada. Con el interruptor apagado, que es el valor por defecto y también lo que lee una F-RAM en blanco, la placa se comporta exactamente como un solo cabezal y las tramas e identificadores no cambian. Implementado en el firmware y probado solo en el ordenador; no se ha probado en placas. El diseño y las tramas están en URTC-COMMON (`docs/MULTINODE.md`) y en el apéndice de [`docs/CANBUS.TXT`](docs/CANBUS.TXT).
- **Qué responde el bootloader y el parche del esclavo:** la lectura de vuelta (`0x7FE`) y la autorización de bajada de versión (`0x7FD`) solo se responden en una sesión del bootloader que la aplicación inició al aceptar `0x7F0` (o en una placa sin aplicación válida); tras un arranque normal se ignoran, y una opción de compilación lo desactiva. El esclavo de expansión envía su número de parche en el décimo byte de su registro de versión y el maestro lo reenvía en `0x222` (un byte 0 significa que no se envía, como en un esclavo antiguo), seguido del byte bajo de su número menor en un tercer byte, para que un programa pueda mostrar la versión completa. Está en el código fuente y probado en el host; ninguna imagen de firmware lo incluye todavía.

## 🔌 Interfaces

**Velocidad del bus CAN:** el bus de los cabezales funciona a **1 Mbit/s** (el valor se escribe una sola vez, en `spec/can_protocol.json` de URTC-COMMON; el firmware y el bootloader calculan la temporización desde él para el reloj del chip: velocidad exacta, punto de muestreo al 87,5 por ciento y nunca por debajo del 75 por ciento). 500 kbit/s queda como opción heredada para placas antiguas: compila con `URTC_CAN_LEGACY_500K=1`. **Nota de compatibilidad:** todas las placas y adaptadores de un mismo bus deben ir a la misma velocidad (un bus que mezcla velocidades no funciona y las herramientas avisan); a 1 Mbit/s el tronco debe quedarse por debajo de unos 25 m, con derivaciones de pocos centímetros y una terminación de 120 ohmios en cada extremo, mientras que 500 kbit/s tolera unos 100 m. Nada de esto ha corrido en un bus real.

Una vez que el bootloader está en su lugar, actualizar la aplicación ya no necesita acceso físico a la placa en absoluto — solo envía la build de firmware nueva por la misma línea CAN umbilical que ya lleva comandos al cabezal de herramienta.

**La secuencia de actualización:**

1. **Disparo.** El maestro envía `0x7F0` (DLC 4, carga útil `B0 07 1D 5A`) a la *aplicación en ejecución*. Corta la energía de forma segura a cada actuador en línea — motores, calentadores, láser — y resetea el chip. Este requisito de carga útil mágica significa que una trama corrupta o malformada no puede disparar accidentalmente un reset hacia el modo de actualización.
2. **Inicio.** Tras el reset, el bootloader está escuchando. El maestro envía `0x7F1` (DLC 8, tamaño total de firmware big-endian + HardwareID big-endian). Una imagen construida para un hardware distinto se rechaza justo aquí, antes de que se toque un solo byte de flash. El bootloader borra exactamente tantas páginas del slot de respaldo como necesite la imagen nueva y responde con una trama de estado (`0x7F5`).
3. **Firma.** El maestro envía el registro Ed25519 de 76 bytes (id de clave, contador de retroceso, firma) como 11 tramas `0x7EC` (un índice y 7 bytes cada una) antes de los datos y en cualquier orden; lo calcula la máquina del mantenedor tras la build, sobre una cabecera que describe la imagen, su SHA-256 y el contador. El bootloader solo guarda claves públicas, así que leerlo no da a nadie el poder de firmar; la tabla de claves oficial está vacía hasta que se cree la clave de firma de imágenes, y una build de banco confía en una clave pública de desarrollo (véase `docs/FIRMWARE_SIGNING.TXT`).
4. **Datos.** El maestro transmite el archivo `.bin` como una secuencia de tramas `0x7F2` (hasta 8 bytes de datos de firmware en bruto cada una), enviadas una tras otra — CAN garantiza que las tramas llegan en el orden en que se enviaron en un solo bus, así que no hace falta un número de secuencia por trama. El bootloader acumula los bytes entrantes en una página de 2KB en RAM y la escribe en el slot de *respaldo* una vez llena, releyendo cada media palabra y comparándola contra lo que se suponía que se escribiera antes de dar la página por terminada, y enviando un reconocimiento `0x7F3` (con el índice de página) tras cada escritura verificada. Una implementación razonable del maestro espera el ACK de cada página antes de enviar los datos de la siguiente, para evitar desbordar el búfer de recepción del bootloader.
5. **Fin y verificación.** Una vez que se ha enviado cada byte, el maestro envía `0x7F4` (DLC 8, CRC32 big-endian + versión mayor/menor). El bootloader comprueba el tamaño del slot de respaldo, calcula su CRC32 y comprueba el registro Ed25519 contra lo que declaró el maestro. Solo si todo coincide procede a copiar el respaldo al slot principal, página por página, con la misma verificación de relectura de arriba. Una vez que esa copia está completa y confirmada, guarda los metadatos nuevos y resetea hacia la aplicación actualizada. Ante cualquier discrepancia — tamaño, CRC32, firma, o HardwareID — el slot principal nunca se toca en absoluto, y el bootloader simplemente vuelve a escuchar para un intento nuevo.

**Tramas de estado (`0x7F5`, DLC 1):** `0x01` escuchando, `0x02` borrando, `0x03` recibiendo, `0x06` verificando, `0x07` copiando respaldo a principal, `0x04` verificado OK (a punto de saltar), `0x05` verificación fallida, `0xFF` error.

**Latido (`0x7F6`, DLC 2, cada ~1s mientras escucha o actualiza):** byte de estado + porcentaje de progreso (0-100, o `0xFF` donde un porcentaje no aplica). Permite al maestro distinguir "el nodo está vivo pero todavía no ha empezado a escuchar" de "el nodo está completamente sin respuesta" - útil para puesta en marcha automatizada y para detectar un bootloader atascado sin esperar a que venza un tiempo de espera.

**Progreso en pantalla.** El bootloader controla el OLED directamente durante una actualización — nadie tiene que adivinar si algo está pasando. Muestra "UPDATING" más una barra de progreso en vivo y un porcentaje mientras se escriben o copian páginas, "FLASH OK" durante un instante antes de resetear hacia el firmware nuevo, y "ERROR" si falla la escritura de una página, la transferencia se estanca más de 10 segundos, o la verificación vuelve con una discrepancia.

**⚠️ Prueba esto en banco antes de confiar en ello en campo.** El protocolo de arriba compila y enlaza limpio y la lógica se ha razonado cuidadosamente, pero un bootloader es exactamente el tipo de firmware donde "compila correctamente" está muy lejos de "confiable en hardware" — los tiempos reales de programación de flash, el comportamiento de CAN a través de una transferencia de varios miles de tramas, y el traspaso bootloader-a-aplicación necesitan todos verificarse en una placa real (idealmente con JTAG a mano como respaldo) antes de confiar en esto para una actualización desatendida con actuadores reales conectados.

## 🚀 Inicio rápido

La flash de URTC está dividida en 2 piezas independientes, para que la placa pueda volver a grabarse por el mismo cable umbilical CAN que ya usa para todo lo demás — sin necesitar nunca más acceso físico al header JTAG/SWD después de la configuración inicial.

### Configuración inicial — requiere JTAG/SWD (una vez)

El bootloader solo puede entrar al chip mediante programación física — no hay forma de grabar por CAN una placa que todavía no tiene un bootloader instalado. Este es un paso único:

1. Abre el proyecto en **STM32CubeIDE** (construido y probado contra el target STM32F303CC), o usa **STM32CubeProgrammer** directamente con los binarios compilados de abajo.
2. Graba **ambas** imágenes por SWD (ST-Link) mediante el header `STM_JTAG` integrado — cada archivo `.hex` tiene su dirección de destino incrustada, así que la mayoría de las herramientas (incluyendo STM32CubeProgrammer) pueden cargar ambas en la misma sesión:
   * `URTC_MAIN_BOOTLOADER_v<version>.hex` → `0x08000000`
   * `URTC_MAIN_FIRMWARE_v<version>.hex` → `0x08008000`
3. Establece la identidad de la herramienta mediante los jumpers de soldadura de ID antes de encender - la placa los lee una vez al arrancar, como siempre. Cinco jumpers (ID0-ID4), cubriendo el espacio completo de 32 direcciones (31 direcciones de herramienta directas, más la dirección reservada `11111` de configuración libre - ver la sección de Matriz de Herramientas de arriba).
4. Enciende. El bootloader escucha durante ~600ms, no ve nada, y salta directamente a la aplicación — desde aquí en adelante, todo se comporta exactamente como se describe en el resto de este README. La ventana empieza después de que el bootloader haya comprobado la aplicación almacenada, y una herramienta que quiera actualizar debe enviar dentro de ella su trama de inicio de actualización (0x7F1); el estado de escucha (0x7F5 = 0x01) se envía cuando la ventana termina sin salto, no al empezar.

**El header JTAG nunca se quita ni se deshabilita.** Siempre está ahí como respaldo — si una actualización CAN alguna vez sale mal, o simplemente lo prefieres, puedes volver a grabar cualquiera de las 2 imágenes por SWD en cualquier momento.

**Dos pulsadores integrados, BOOT y RESET**, también están ahí para recuperación — RESET es un reset de hardware ordinario (`NRST`), y BOOT pone `BOOT0` en alto, que es una decisión a nivel de chip tomada *antes* de que nada de este repositorio corra en absoluto: normalmente (no mantenido) el chip arranca desde la flash hacia el propio bootloader de este proyecto como se describió arriba; mantenido durante el reset, arranca hacia el propio bootloader de System Memory de fábrica de ST en su lugar (recuperación por USB DFU/UART, completamente separado de cualquier cosa de aquí). Ver `src/F303-master/README.md` sección 4a para el detalle técnico completo.

### Herramientas de PC

Dos herramientas GUI independientes y multiplataforma (Windows/Linux)
dan soporte a esta placa - **URTC Flasher** (actualizaciones CAN-OTA y
de chip completo por SWD/JTAG, tanto para esta placa como, en una
variante de expansión Avanzada, para su propio chip esclavo de
expansión) y **URTC Tester** (un ejercitador en vivo de bus CAN que
muestra el perfil de herramienta que esté configurado con jumpers en cada momento).
Ambas solían vivir dentro de este repositorio bajo `tools/`; cada una es
ahora su propio proyecto independiente, con su propio README, licencia,
y traducciones:

- [URTC Flasher](https://github.com/JuanenRac/URTC-FLASHER)
- [URTC Tester](https://github.com/JuanenRac/URTC-TESTER)

También existe una alternativa basada en web que cubre terreno similar
(monitorización en vivo, análisis CAN, grabación OTA, inspección térmica)
sin instalar nada localmente: [URTC Web Studio](https://github.com/JuanenRac/URTC-WEB-STUDIO).

<!-- urtc-section:compatibility -->
### Requisitos y compatibilidad

Qué versiones de los programas de URTC funcionan juntas, y qué versión del protocolo habla cada una, figura en la tabla de compatibilidad que genera URTC-COMMON: [docs/COMPATIBILITY.md](https://github.com/JuanenRac/URTC/blob/main/docs/COMPATIBILITY.md). Las notas de una versión de los repositorios que llevan `tools/changelog_section.py` (el firmware, el flasher, el tester y el updater) son la sección del CHANGELOG de esa versión seguida de esta tabla: `python tools/changelog_section.py VERSION --compat`.
<!-- /urtc-section:compatibility -->

## 🧪 Pruebas

La lógica del firmware alrededor del hardware se prueba en un ordenador: `python tools/run_host_tests.py` compila y ejecuta 58 suites de pruebas en C (`tests/test_*.c`) con el compilador del equipo, un HAL simulado y los sanitizadores AddressSanitizer y UBSan con `-fanalyzer`: los bootloaders, la protección térmica, el despachador, los manejadores CAN reales de las 13 herramientas, los lazos de control de los calentadores y la caja negra, entre otros. La CI compila y enlaza además los cuatro binarios y falla por debajo de un mínimo de cobertura de las líneas ejecutadas de las fuentes del firmware. Nada de esto se ha ejecutado en una placa: no existe ninguna placa montada, y las pruebas en el equipo no pueden demostrar que funcionen los tiempos, los controladores o las etapas de potencia. `python tools/c_quality.py` añade tres comprobaciones que el compilador de la placa no hace: el compilador del ordenador con `-Wconversion` sobre cada fuente que construyen las suites, cppcheck y un límite a la longitud de los bloques de comentarios (los controladores de sensor incluidos tal cual quedan fuera, cada uno con su motivo en `tools/c_quality.json`).

## 🏗️ Compilación y publicación

### Compilar desde el código fuente (opcional — los binarios precompilados son assets de cada release de GitHub, no archivos del repositorio)

Dos formas de ir desde el código fuente de este repositorio hasta los 4 binarios de arriba:

- **Automatizada:** `build_firmware.sh` (Linux) o `build_firmware.bat` (Windows), en la raíz del repositorio. Cualquiera de los 2 instala la toolchain ARM GNU si falta, descarga el commit fijado de ST HAL/CMSIS, y compila, enlaza, y aplica `objcopy` a los 4 binarios (app + bootloader de la placa principal, app + bootloader del esclavo de expansión) directamente en `firmware/`, y luego regenera `firmware/firmware_manifest.json`. Ejecútalo sin argumentos para una build completa, `--clean` para vaciar primero la caché local `build/`, o `master`/`slave` para compilar solo el par propio de un chip. `build_firmware.sh` corre de principio a fin contra el árbol de código fuente real de este proyecto; `build_firmware.bat` refleja esa misma lógica para Windows — si alguna vez discrepan, confía en la lógica del script `.sh` como referencia.
- **Manual:** cada comando que cualquiera de los 2 scripts ejecuta, más el razonamiento detrás de cada elección de toolchain/HAL, está detallado paso a paso en `docs/COMPILE_STM32F303.TXT` — útil en un sistema operativo distinto, con una fuente HAL/CMSIS distinta, o simplemente para ver exactamente qué automatizan los scripts.
- **Assets de la release:** las imágenes de firmware (`.bin`, `.hex`, `.elf` y sus archivos de suma y manifiesto) no se versionan en git. `build_firmware.sh`/`.bat` las escriben en `firmware/` (ignorado por git; `build/firmware` en modo CI, `URTC_CI=1`), y `python tools/publish_release_assets.py` comprueba el conjunto e imprime el comando `gh release create` exacto con los archivos a adjuntar. Se publican solo como assets de la release de GitHub de cada versión. Quién lee qué: [`docs/FIRMWARE_DISTRIBUTION.md`](docs/FIRMWARE_DISTRIBUTION.md).

Después de cualquier cambio en el código fuente del firmware (o antes de confiar en un incremento de versión), ejecuta **`check_version_consistency.sh`** desde la raíz del repositorio: lee las constantes de versión de las Pistas A/E (firmware de la placa principal, aplicación del esclavo de expansión) como fuente de verdad y comprueba cada ubicación que documenta `VERSION_CHECKLIST.txt` para esa etiqueta de versión, reportando cualquier discrepancia — solo reporta, no arregla nada por sí mismo. `VERSION_CHECKLIST.txt` es la referencia completa para las 5 pistas de versión independientes que lleva este proyecto (firmware principal, hardware/PCB, bootloader principal, aplicación del esclavo de expansión, bootloader del esclavo de expansión) y exactamente qué hay que tocar al incrementar cualquiera de ellas.

El firmware y el bootloader se versionan y publican de forma
independiente - grabar un bootloader nuevo no implica una versión de
aplicación nueva y viceversa, así que cada uno tiene su propio historial
en su propio archivo en vez de un número de versión combinado que
implicaría que siempre se mueven juntos:

- Firmware (`src/F303-master/`): [`src/F303-master/CHANGELOG.md`](src/F303-master/CHANGELOG.md)
- Bootloader (`src/F303-master/boot/`): [`src/F303-master/boot/CHANGELOG.md`](src/F303-master/boot/CHANGELOG.md)
- Aplicación del esclavo de expansión (`src/F303-slave/`, STM32F303CBT6): [`src/F303-slave/CHANGELOG.md`](src/F303-slave/CHANGELOG.md)
- Bootloader del esclavo de expansión (`src/F303-slave/boot/`): [`src/F303-slave/boot/CHANGELOG.md`](src/F303-slave/boot/CHANGELOG.md)

**Versiones:** los cuatro componentes (dos firmwares de aplicación y dos bootloaders: `FIRMWARE_VERSION_MAJOR`/`MINOR`/`PATCH` y `BOOTLOADER_VERSION_MAJOR`/`MINOR`/`PATCH`) se versionan de forma independiente. La versión de cada uno solo se sube con el paso explícito `python bump.py` (que usa `bump_version.py` en la raíz del repositorio); compilar nunca cambia una versión. Cada bootloader guarda además su propia copia de los `FIRMWARE_VERSION_*` de la aplicación que le corresponde, que ese mismo paso mantiene sincronizada. Consulta [`CHANGELOG.md`](CHANGELOG.md) en la raíz para ver de un vistazo la versión actual de los 4 componentes, y [`VERSION_CHECKLIST.txt`](VERSION_CHECKLIST.txt) para la mecánica de cada línea.

## 📂 Estructura del repositorio

<p align="center">
  Estructura del repositorio URTC
</p>

<details>
<summary>Versión en texto del árbol</summary>

```text
URTC/
├── src/                                               los cuatro componentes de firmware y lo que comparten
├── PCB/                                               el esquema y el diseño de la placa
├── BOM/                                               listas de materiales de la placa y las seis de expansión
├── 3D/                                                modelos 3D
├── ani/                                               las animaciones del OLED
├── keys/                                              solo claves públicas, nunca una privada
├── docs/                                              protocolo CAN, patillajes, firma, modelo de amenazas, hojas de datos
├── tests/                                             58 suites de pruebas de host en C
├── tools/                                             ejecutor de pruebas de host, herramientas de release, comprobaciones compartidas
├── images/                                            banner e imágenes de este README
├── .github/                                           flujo de CI y plantillas de issues y pull requests
├── build-test.sh build-test.bat                       scripts de compilación y pruebas que no cambian nada en el repositorio
├── test.sh test.bat                                   ejecutan las pruebas
├── urtc.project.json                                  manifiesto: versión, papel, madurez y comando de compilación
├── CHANGELOG.md                                       qué cambió en cada versión
├── SECURITY.md SUPPORT.md LICENSE                     política de seguridad, soporte y licencia
├── CONTRIBUTING.md CODE_OF_CONDUCT.md                 cómo contribuir y código de conducta
├── .gitattributes .gitignore                          ajustes de Git
├── build_firmware.sh build_firmware.bat               compila los cuatro binarios
├── bump.py bump_version.py bump_manifest_version.py   scripts que suben la versión
├── check_version_consistency.sh                       comprueba cada lugar donde se indica una versión
├── check_shared_drivers.py                            comprueba las copias de los controladores compartidos
├── firmware_signing.py                                firma las imágenes
├── generate_manifest.py                               escribe el manifiesto de una imagen
├── VERSION_CHECKLIST.txt                              la mecánica de las cuatro versiones
└── LICENSE.md ruff.toml mypy.ini                      licencia del hardware, ajustes de lint y de comprobación de tipos
```

</details>

La lista anotada de cada archivo de código, una línea por archivo, está en [docs/SOURCE_MAP.md](docs/SOURCE_MAP.md).

## 🗺️ Hoja de ruta y límites conocidos

**Firmware (`src/F303-master/`):** completo en funcionalidad para los 25 perfiles de herramienta — control térmico todo/nada con histéresis, telemetría por herramienta, watchdogs de comunicación, detección de stall/fallo, y el propio diagnóstico en vivo del OLED, junto con un par de consulta de herramienta activa (`0x110`/`0x111`), un passthrough SPI genérico (`0x180`/`0x181`) para el conector de expansión, una F-RAM integrada que persiste los setpoints a través de un corte de energía (`0x190`/`0x191`), el mecanismo de configuración libre de herramienta con jumper `11111` (`0x1A2`/`0x1A3`), reporte de tipo de periférico + número de serie de dispositivo (`0x1A4`/`0x1A5`) para distinguir múltiples placas por lo demás idénticas en un bus compartido, y un puente CAN-a-I2C (`0x210`-`0x221`) que alcanza el chip esclavo de expansión en placas de expansión avanzadas. Versionado independientemente del bootloader (ver el Registro de Cambios abajo). Nada de ello se ha ejecutado en una placa real, y la protección térmica solo está probada en el host con un calentador simulado.

**Bootloader (`src/F303-master/boot/`):** sistema de actualización A/B de imagen dorada completo en funcionalidad — actualizaciones OTA por CAN comprobadas con CRC32 y una firma Ed25519 contra una tabla de claves públicas, un slot de respaldo que garantiza que una actualización fallida nunca inutiliza la placa, y su propio reporte de versión (`0x7FA`) independiente de la aplicación. Compila y enlaza limpio; ver el aviso de prueba en banco de arriba antes de confiar en él desatendido con actuadores reales conectados.

**Herramientas de PC:** tanto [URTC Flasher](https://github.com/JuanenRac/URTC-FLASHER) (actualizaciones CAN OTA + programación de chip completo por SWD/JTAG) como [URTC Tester](https://github.com/JuanenRac/URTC-TESTER) (ejercitador en vivo de control/telemetría por herramienta) están completas en funcionalidad para lo que se propusieron hacer, cada una ahora su propio proyecto independiente con su propio README que cubre la configuración y cada control en detalle.

**Hardware:** el esquemático y la BOM todavía se están finalizando; todavía no existe ninguna placa poblada para validar nada de lo de arriba contra silicio real. Todo lo de arriba compila, enlaza, y se ha razonado con cuidado, pero "compila correctamente" y "verificado en hardware" son 2 afirmaciones distintas — ver el aviso de seguridad al principio de este README, y trata una primera puesta en marcha con la precaución que cualquier placa nueva merece.

Si alguien de la comunidad está trabajando en efectores finales personalizados, cambiadores de herramienta inteligentes, o integración avanzada de herramientas para PAROL6, Faze4, o cualquier otra plataforma de brazo robótico, ¡me encantaría charlar, intercambiar ideas, o profundizar en los comandos CAN!

## 🌍 Idiomas

El README y los textos existen en inglés, español, francés, italiano, alemán, chino, japonés y portugués de Portugal.

## 🔗 Proyectos relacionados

URTC se compone de repositorios independientes, cada uno con su versión, sus pruebas y su README. Esta es la familia, por grupos:

* **URTC Tool Platform:**
  * **URTC** (este repositorio) - firmware de la placa del cabezal de herramienta (25 perfiles de herramienta, bootloader CAN) y la referencia del protocolo CAN.
  * [URTC-COMMON](https://github.com/JuanenRac/URTC-COMMON) - el protocolo CAN escrito una sola vez como datos (especificación, tablas generadas, vectores de conformidad) y el código que comparten los programas.
  * [URTC-FLASHER](https://github.com/JuanenRac/URTC-FLASHER) - herramienta de escritorio que actualiza el firmware de la placa por CAN o por SWD/JTAG.
  * [URTC-GATEWAY](https://github.com/JuanenRac/URTC-GATEWAY) - pasarela delante del bus CAN: solo deja pasar los identificadores de una lista, limita su frecuencia y pide una clave de sesión.
  * [URTC-SMART-RACK](https://github.com/JuanenRac/URTC-SMART-RACK) - lógica en C independiente del hardware y protocolo de órdenes para un soporte de herramientas con precalentamiento y seguimiento del ciclo de vida.
  * [URTC-TESTER](https://github.com/JuanenRac/URTC-TESTER) - probador de escritorio del bus CAN en vivo que muestra los controles y la telemetría del perfil de herramienta que informa una placa.
  * [URTC-VISION-TOOL](https://github.com/JuanenRac/URTC-VISION-TOOL) - protocolo de tramas de sensor en C y un acompañante en Python térmico/RGB para un cabezal de inspección.
  * [URTC-WEB-STUDIO](https://github.com/JuanenRac/URTC-WEB-STUDIO) - aplicación de navegador que graba y prueba la placa por Web Serial y SLCAN, sin instalar nada.
* **Ecosystem Operations:**
  * [URTC-DEVTOOLS](https://github.com/JuanenRac/URTC-DEVTOOLS) - las herramientas de repositorio compartidas de la familia como un conjunto con versión y un fichero de bloqueo que distingue una copia editada de una desfasada.
  * [URTC-DOCS](https://github.com/JuanenRac/URTC-DOCS) - arquitectura, interfaces, línea base de seguridad y catálogo generado del ecosistema, más las herramientas que comparan todos los repositorios.
  * [URTC-UPDATER](https://github.com/JuanenRac/URTC-UPDATER) - herramienta de escritorio que detecta, instala y actualiza los repositorios de la familia URTC, una acción explícita cada vez.

**Proyectos hermanos (independientes, con la misma base y herramientas):**

* **[HYDRA-UMC-DOCS](https://github.com/JuanenRac/HYDRA-UMC-DOCS)** - proyecto hermano: el centro de documentación de HYDRA-UMC, un ecosistema independiente que comparte base y herramientas con este
* **[ARMOR-DOCS](https://github.com/JuanenRac/ARMOR-DOCS)** - proyecto hermano: el centro de documentación de A.R.M.O.R., el ecosistema de seguridad, también independiente y sobre la misma base
* **[JuanenRac](https://github.com/JuanenRac/JuanenRac)** - el perfil y el panel de estado de todos los ecosistemas

## 📚 Documentación

- **[CONTRIBUTING.md](CONTRIBUTING.md)** — stack tecnológico y pautas de codificación para un pull request.
- **[CODE_OF_CONDUCT.md](CODE_OF_CONDUCT.md)** — los estándares de comportamiento esperados en esta comunidad.
- **[SECURITY.md](SECURITY.md)** — cómo reportar una vulnerabilidad, y las áreas reales de enfoque en seguridad de este proyecto.
- **[SUPPORT.md](SUPPORT.md)** — dónde hacer preguntas y reportar errores.
- **[LICENSE.md](LICENSE.md)** — la licencia propia de este proyecto.

## 🤝 Contribuir y comunidad

* Antes de una pull request ejecuta `URTC_CI=1 python tools/ci_validate.py`: debe pasar. Consulta [CONTRIBUTING.md](CONTRIBUTING.md) y el [código de conducta](CODE_OF_CONDUCT.md).
* El README existe en ocho idiomas: un cambio en el texto se hace en los ocho archivos, y las secciones compartidas con otros repositorios las escribe `tools/readme_sections.py` de URTC-COMMON.
* No describas como funcionando en una placa lo que solo se ha compilado.
* Informa de una vulnerabilidad en privado: [SECURITY.md](SECURITY.md). Preguntas, ideas e informes: electrohobby3d@gmail.com ([SUPPORT.md](SUPPORT.md)).

## 👤 AUTOR

**JuanenRac** (Electro Hobby 3D)
📧 electrohobby3d@gmail.com
📺 [youtube.com/@electrohobby3d](https://youtube.com/@electrohobby3d)

## 📜 LICENCIA

URTC es (c) 2026 JuanenRac (Electro Hobby 3D). Este aviso debe incluirse en cualquier distribución de este proyecto o trabajos derivados.

Dado que este proyecto consiste en varios tipos distintos de contenido, las partes individuales están disponibles bajo licencias distintas - cada una adecuada a lo que realmente cubre, en vez de forzar una sola licencia a encajar en todo:

1. El **firmware** ubicado en `./firmware` (aplicación y bootloader CAN por igual) está disponible bajo la **GNU General Public License v3.0 (GPL-3.0-or-later)**. Texto completo en https://www.gnu.org/licenses/gpl-3.0.html.

2. Los **diseños de hardware** (archivos de esquemático/placa de Eagle, gerbers, y las piezas imprimibles en 3D bajo `./PCB` y `./3D`) están disponibles bajo la **CERN Open Hardware Licence v2 - Strongly Reciprocal (CERN-OHL-S v2)**. Texto completo en https://cern-ohl.web.cern.ch/.

3. La **documentación** (este README y sus propias traducciones - `README_spa.md`, `README_ita.md`, `README_fra.md`, `README_deu.md`, `README_zho.md`, `README_jpn.md` - más los archivos de referencia bajo `./docs`) está disponible bajo **Creative Commons Attribution-ShareAlike 4.0 International (CC BY-SA 4.0)**. Texto completo en https://creativecommons.org/licenses/by-sa/4.0/.

Si construyes sobre este proyecto, ten en cuenta la separación de licencias: los cambios de código al firmware deberían mantenerse GPL-3.0-or-later, las modificaciones de hardware deberían mantenerse CERN-OHL-S, y los derivados de documentación deberían mantenerse CC BY-SA - cada uno con atribución de vuelta a este proyecto.

Este repositorio cubre solo el propio firmware y hardware de la placa URTC - las herramientas de PC (URTC Flasher, URTC Tester) que solían vivir aquí son ahora proyectos independientes con su propia licencia, ver "Herramientas de PC" arriba.
