JuanenRac/URTC/docs/SOURCE_MAP.md

# Source map

Every file of the repository with a line on what it does: the annotated tree that the README carried before it was reduced to the first level (the first level, in eight languages, is in the section Repository Structure of the README).

```text
/
├── 3D/
│   ├── RACK/                    Board mounting rack, 2 variants (x1, x3) - each in
│   │                            .stl/.3mf/.amf/.scad
│   ├── REVOLVER/                Placeholder - empty, content not started yet
│   └── TOOLS/
│       └── PAROL6/              Per-tool 3D-printable parts for the PAROL6 robot arm -
│                                one subfolder per tool (0.Universal parts, then 1-12
│                                matching the Tool Catalog numbering above), each in
│                                .stl/.3mf/.amf/.scad where populated; several
│                                (4, 6-12) are still empty placeholders
├── ani/                          27 GIFs: one 4-frame animation per tool profile (00-24,
│                                 matching each tool's own numeric ID), the boot splash
│                                 (splash_boot.gif), and the invalid-ID warning
│                                 (error_warning.gif) - all decoded straight from this
│                                 project's own firmware source (firmware_render.c's own
│                                 ToolIcons[]/SplashFace[]/ErrorText[] tables), not
│                                 hand-drawn separately, so they always match what the
│                                 real OLED actually shows
├── BOM/
│   ├── BOM.TXT                  Full bill of materials of PCB board
│   ├── BOM_EXPANSION_BASIC_TMC2209.TXT     Expansion board, basic + TMC2209
│   ├── BOM_EXPANSION_BASIC_TMC5160A.TXT    Expansion board, basic + TMC5160A
│   ├── BOM_EXPANSION_ADVANCED_TMC2209.TXT  Expansion board, advanced + TMC2209
│   ├── BOM_EXPANSION_ADVANCED_TMC5160A.TXT Expansion board, advanced + TMC5160A
│   ├── BOM_EXPANSION_BASIC_ADS1115.TXT     Expansion board, basic + ADS1115 (sensor-only, no driver/MCU)
│   └── BOM_EXPANSION_BASIC_MLX9064X.TXT    Expansion board, basic + MLX9064x (sensor-only, no driver/MCU)
├── docs/
│   ├── CANBUS.TXT               CAN bus protocol reference (all command/telemetry IDs)
│   ├── ECOVIA.TXT               Tool identification matrix and pin-mutation logic
│   ├── TOOLS.TXT                High-level catalog of all 25 tools - what each does and
│   │                            which peripherals it uses, no pin-level detail
│   ├── PINOUT.TXT               Full MCU pinout, block by block
│   ├── PINOUT_CONNECTORS.TXT    Physical connector pinouts (CONN_DRILL, CONN_SEN, etc.)
│   ├── EXPANSION.TXT            CONN_EXPANSION connector and the add-on board variants
│   ├── PINOUT_SLAVE.txt         Full pinout for the expansion slave chip (advanced variants only)
│   ├── EEPROM.TXT               Full F-RAM register map (every persisted setting, byte offsets)
│   ├── COMPILE_STM32F303.TXT    From-scratch build guide for all 4 firmware binaries -
│   │                            toolchain, ST HAL/CMSIS setup, exact compile/link commands;
│   │                            build_firmware.sh/.bat at the repo root automate this same
│   │                            process end to end
│   ├── FIRMWARE_DISTRIBUTION.md Where the firmware files are published and what each consumer reads
│   ├── FIRMWARE_SIGNING.TXT     How the firmware images are signed: HMAC today, Ed25519 planned
│   ├── RELEASE_SIGNING.md       How a release is signed (detached Ed25519 signature of every asset) and the public key
│   ├── BENCH_TESTS.md           The thirteen bench tests for the firmware, each with setup, steps and expected result (none run on a board yet)
│   ├── KEYS.md                  Every key the family relies on: purpose, public value, where it is embedded, where the private half lives
│   ├── CAN_THREAT_MODEL.TXT     What the CAN bus trusts and the installation requirements that follow
│   ├── COMPATIBILITY.md         Which versions of the programs work together (generated by URTC-COMMON)
│   ├── datasheet/               2 component datasheets not already covered under
│   │                            PCB/datasheet/ (CFM_40.pdf, EFB0424VHD-CP0.pdf)
│   └── tool_image_generator/    Toolkit that generates images/TOOL_*.png (see below) -
│                                render_engine.py + tool_data.py + generate_all.py, and
│                                PROCEDURE.TXT explaining how to add a new tool's own
│                                image or regenerate an existing one
├── src/
│   ├── F303-master/
│   │   ├── STM32F303CC_main.c    Entry point - global definitions and main()
│   │   ├── firmware_*.c/.h       ~100 more files, one per subsystem (OLED, LEDs, per-tool
│   │   │                         CAN handlers, init, persistence, etc.), including
│   │   │                         firmware_ads1115.c (direct ADS1115 driver, Basic+ADS1115
│   │   │                         board) - see this folder's own README.md for the full
│   │   │                         file-by-file table
│   │   ├── melexis_mlx90640/     Melexis's own official MLX90640 library (Apache-2.0,
│   │   │                         plain C) plus this board's own direct-connection driver
│   │   │                         on top of it, for the Basic+MLX9064x expansion board
│   │   ├── melexis_mlx90641/     Same idea, MLX90641 library (Apache-2.0, C++ - see this
│   │   │                         folder's own README.md section 8a for why this one
│   │   │                         library is C++ in an otherwise all-C project)
│   │   ├── melexis_mlx90642/     Same idea, MLX90642 library (Apache-2.0, plain C) - see
│   │   │                         section 8a for why this sensor's own driver is genuinely
│   │   │                         simpler than the other 2
│   │   ├── STM32F303CCTx_APP.ld  Linker script for the application (112K main slot at 0x08008000)
│   │   ├── README.md             Technical reference: hardware platform, the ID-jumper
│   │   │                         tool-selection system, per-tool peripheral wiring - see
│   │   │                         CANBUS.TXT for the wire-level protocol this explains the why of
│   │   └── boot/
│   │       ├── bootloader_main.c  Entry point for the bootloader
│   │       ├── bootloader_*.c/.h  9 more files (shared types/constants, crypto,
│   │       │                      flash/metadata, OLED, CAN protocol)
│   │       ├── STM32F303CCTx_BOOTLOADER.ld  Linker script for the bootloader (30K region at 0x08000000)
│   │       └── README.md          Same technical-reference role as the application's, for the bootloader
│   ├── common/                   Headers shared by the application, the bootloader and the slave: the boot session mark, the slave registers, the version wire format and the flash layout (urtc_flash_layout.h), plus the host-tested copies of the Ed25519 verifier, the signed-image decision and the addressing by serial number (urtc_ed25519.c, urtc_auth.h, urtc_bl_select.h; no bootloader calls them yet)
│   └── F303-slave/               Companion chip (STM32F303CBT6) on the 2 ADVANCED expansion
│       │                         board variants only - see the Expansion Connector section
│       │                         above. Own bootloader/application pair, own I2C-based
│       │                         (not CAN) update protocol, own independent versioning.
│       ├── slave_main.c          Entry point
│       ├── slave_*.c/.h          7 more files (shared types/constants, I2C link protocol,
│       │                         local sensor bus, local PWM)
│       ├── STM32F303CBTx_SLAVEAPP.ld  Linker script (54K main slot at 0x08005000)
│       ├── README.md             Technical reference: why this chip exists, the local
│       │                         ADS1115/MLX9064x sensor bus, local PWM, the I2C link
│       │                         protocol to the main board
│       ├── melexis_mlx90640/     Melexis's own official MLX90640 library (Apache-2.0,
│       │                         plain C, unmodified, own license file) - kept as its own
│       │                         separate compilation unit, deliberately never folded into
│       │                         this project's own source, since Apache-2.0 requires that
│       │                         code's own copyright notice stay intact
│       ├── melexis_mlx90641/     Melexis's own official MLX90641 library (Apache-2.0, C++ -
│       │                         a genuinely separate library from MLX90640's own, not a
│       │                         variant of it - see this folder's own README.md section 3
│       │                         for why it's C++ and how the build handles that)
│       ├── melexis_mlx90642/     Melexis's own official MLX90642 library (Apache-2.0, plain
│       │                         C) - genuinely simpler transport interface than the other
│       │                         2 sensors' own, see README.md section 3 for why
│       └── boot/
│           ├── slaveboot_main.c   Entry point for the bootloader
│           ├── slaveboot_*.c/.h   7 more files (crypto, flash/metadata, protocol)
│           ├── STM32F303CBTx_SLAVEBOOT.ld  Linker script (18K region at 0x08000000)
│           └── README.md          Same technical-reference role as the application's
├── firmware/  (git-ignored build output - published only as release assets)
│   ├── URTC_MAIN_BOOTLOADER_v<version>.bin  Bootloader compiled, flash to 0x08000000
│   ├── URTC_MAIN_BOOTLOADER_v<version>.elf  Bootloader compiled, flash to 0x08000000
│   ├── URTC_MAIN_BOOTLOADER_v<version>.hex  Bootloader compiled, flash to 0x08000000 (address baked in)
│   ├── URTC_MAIN_FIRMWARE_v<version>.bin    Application bin compiled, flash to 0x08008000
│   ├── URTC_MAIN_FIRMWARE_v<version>.elf    Application elf compiled, flash to 0x08008000
│   ├── URTC_MAIN_FIRMWARE_v<version>.hex    Application HEX compiled, flash to 0x08008000 (address baked in)
│   ├── URTC_SLAVE_BOOTLOADER_v<version>.{bin,elf,hex}  Expansion slave's own bootloader, flash to 0x08000000
│   │                             on the STM32F303CBT6 (advanced expansion boards only)
│   ├── URTC_SLAVE_FIRMWARE_v<version>.{bin,elf,hex}  Expansion slave's own application, flash to 0x08005000
│   └── firmware_manifest.json    Machine-readable index of all 4 components above - version,
│                                 flash address, and each file's own size/CRC32, for an
│                                 external tool to check what's here and what's newer than
│                                 whatever it currently has. Regenerated automatically by
│                                 generate_manifest.py (called by build_firmware.sh/.bat's
│                                 own last step) - never hand-edited.
├── images/
│   ├── OLED_DIRECT_MOUNT.jpg     LCD1/CONN_OLED2 - bare 30-pin FPC panel, direct-mount option
│   ├── OLED_BREAKOUT_MODULE.jpg  CONN_OLED - external I2C breakout module, alternate option
│   ├── URTC_BANNER.svg             General project logo, embedded at the top of this README
│   ├── URTC_BOARD.png           Board photo
│   ├── URTC_SCHEMATIC.png       Board schematic
│   ├── URTC_PCB_TOP.png         Board TOP layer (when added)
│   ├── URTC_PCB_BOTTOM.png      Board BOTTOM layer (when added)
│   └── TOOL_*.png               Per-tool jumper/wiring reference diagram, one per profile
│                                (all 25 present - see each tool's own link in the Tool Catalog above)
├── PCB/
│   ├── URTC_V1.0.sch            Eagle schematic (when added)
│   ├── URTC_V1.0.brd            Eagle board layout (when added)
│   ├── URTC_V1.0_JLCPCB.ZIP     Gerbers, bom and cpl files (when added)
│   ├── URTC_BOM.TXT             Eagle-exported raw BOM (ground truth export - see
│   │                            BOM/BOM.TXT for this project's own curated, organized version)
│   ├── datasheet/               Datasheets of all parts used in board
│   └── *_PARLIST/PINLIST/NETLIST.TXT   Eagle-exported netlists (ground truth for pin mapping)
├── keys/ registry.json: the public keys of the family and where each one is embedded (checked by tools/keys.py)
├── tests/ Host tests of the firmware, built against a fake HAL (tests/host_hal/) and the shared vectors, plus the tests of the Python tools
├── tools/
│   ├── build_test.py            Non-versioning build/compile check
│   ├── publish_release_assets.py  Lists the release assets to attach and prints the gh command
│   ├── ci_validate.py           Manifest/CHANGELOG/docs validation used by CI
│   ├── keys.py                  Checks docs/KEYS.md and keys/registry.json against each other and against the code
│   ├── release_sign.py          Signs the assets of a release (detached Ed25519 signatures)
│   ├── seal_image.py            The step after the link: fills in the length and the CRC-32 of the header an application image carries inside it
│   ├── verify_release_set.py    Checks a folder of signed release assets (digests, signatures against the registered public key) before the workflow publishes them
│   ├── run_host_tests.py        Executor of the host test suites (ctest where cmake is installed, shared with the other firmware repositories), with the sanitizers, the analysis and a coverage floor
│   ├── host_tests.json          The 58 suites: sources, include folders and flags
│   ├── c_quality.py / c_quality.json  Checks the compiler of the board does not make: `-Wconversion` with the host compiler, cppcheck and the length of comment blocks (what is excluded and why, and the limits, are in the JSON)
│   ├── gen_build_scripts.py / build_plan.json  Writes the pinned vendor sources, the compiler and linker flags and the HAL modules into build_firmware.sh and build_firmware.bat from one file (`--check` in CI)
│   ├── bootloader_twin.py / changelog_section.py / fuzz_virtual_board.py The twin of the bootloader (build and drive); the text of one CHANGELOG section for a release; a fuzz run of the virtual board
│   ├── slave_bootloader_twin.py  Host model of the bootloader of the expansion slave (register protocol, update states, confirmation, rollback floor, metadata log, power cuts); no compiler needed
│   └── _doc_policy.py / _readme_parity.py / _tracked_names.py Shared checks used by ci_validate.py
├── VERSION_CHECKLIST.txt        Mechanical checklist for bumping any of this project's own
│                                4 independent version numbers correctly
├── check_version_consistency.sh  Automated version/file-consistency checks - run before
│                                trusting VERSION_CHECKLIST.txt's own claims
├── check_shared_drivers.py       Checks that the Melexis drivers vendored on both chips are identical
├── firmware_signing.py           Firmware signing keys and the signature and digest files next to each image
├── ruff.toml / urtc.project.json Settings of the static checks, and the project manifest (version, maturity, evidence)
├── build_firmware.sh            Installs the toolchain, fetches ST's own HAL/CMSIS, and
│                                compiles all 4 firmware binaries end to end (Linux)
├── build_firmware.bat           Same, for Windows - see docs/COMPILE_STM32F303.TXT for
│                                the full manual process either script automates
├── build-test.sh / build-test.bat  Non-versioning build/compile check (thin wrappers
│                                around tools/build_test.py)
├── bump.py                      Explicit version bump command (compiling never bumps)
├── bump_version.py              version bump of one header, called by bump.py
├── bump_manifest_version.py     Syncs urtc.project.json's version to the native one (--sync)
├── generate_manifest.py         Regenerates firmware/firmware_manifest.json - called
│                                automatically as the last step of a full
│                                build_firmware.sh/.bat run, or standalone any time the
│                                manifest needs to catch up without a full rebuild
├── LICENSE
├── README.md                    This file
└── README_spa.md / README_ita.md / README_fra.md / README_deu.md / README_zho.md / README_jpn.md / README_por.md  <- translations
```
