JuanenRac/URTC/docs/SLAVE_BOOT_CONFIRMATION.md

# How the expansion slave decides to install an image

The bootloader of the main board verifies an Ed25519 signature record before it installs anything (`BOOTLOADER_AUTH.md` and `SIGNATURE_SEPARATION.md` in URTC-COMMON). The bootloader of the expansion slave (STM32F303CB, 18 KB region) has **no room** for the verifier: it would need about 7 KB more. The application of the slave is not moved to make room, so every tool that knows `0x08005000` keeps working.

The split is therefore:

| Who | What it checks |
|---|---|
| The **master** (main board, application) | The Ed25519 record of the slave image, under a key of the trust table of the master's own bootloader. The SHA-256 of the bytes it relays. |
| The **slave bootloader** | Size, hardware id, CRC-32, the SHA-256 of what it received against the digest it was sent, the version rule, **the signed rollback counter against the floor it keeps**, and **that the master confirmed this image in this session**. Without the confirmation it installs nothing. It holds no key and no HMAC routine. |

## The messages

Registers of the slave bootloader on the I2C link bus (address `0x42`), next to the existing ones:

| Register | Access | Bytes | Meaning |
|---|---|---|---|
| `0x02` DIGEST_EXPECTED | write | 32 | The SHA-256 (no key) of the whole image. The slave checks no HMAC and its bootloader holds no signing secret in the update path. |
| `0x09` CHALLENGE | read | 16 | The nonce of the update session in progress (zeros when none). Made at `START_UPDATE`. |
| `0x0A` CONFIRM | write | 32 | The master's confirmation. Accepted only in status `0x08` (AWAIT_CONFIRM), and used once. |
| `0x0B` COUNTER_FLOOR | read | 4 | The rollback floor the slave keeps, big-endian: the higher of a floor compiled into the bootloader and the signed counter of the installed image. The master reads it before it starts the update. |
| `0x0C` RECORD_COUNTER | write | 4 | The signed counter of the record the master verified, big-endian. Sent after the master's check and before the END frame is relayed; only accepted while an update is receiving. |

Status `0x08` AWAIT_CONFIRM: size, CRC-32, SHA-256 and the version rule passed; the slave waits ten seconds for the confirmation. Failure reason `0x06` NOT_CONFIRMED: no confirmation came, or it does not match. Reason `0x03` keeps meaning "the digest does not match".

The confirmation is the SHA-256 of an 80-byte message that both sides build with `src/common/urtc_slave_confirm.h` (the reference is `slave_confirm_message` in URTC-COMMON, held to the same vector):

```
"URTC-SLV-CONF-V2" (16) | nonce (16) | SHA-256 of the image (32) | hardware id (4) | version major (2) | version minor field (2) | size (4) | rollback counter (4)
```

The slave builds the message from **its own** values (its nonce, the hash of its backup slot, the hardware id, version and size it was told, and the counter it was sent in `0x0C`) and compares the hash with the 32 bytes it received. A master that never sent the counter cannot have its confirmation accepted.

On the CAN side one frame is new: `0x21A` `SLAVE_RECORD_CHUNK`, eleven frames of an index and seven bytes that carry the 76-byte record (key id, counter, signature), exactly as `0x7EC` does for the main board. The `0x212` frames now carry the SHA-256 instead of an HMAC. Nothing else changes for a tool.

## The sequence

1. The master reads the floor of the slave (`0x0B`) **before** it relays `0x211`, because afterwards the slave is erasing and does not answer. A slave that does not answer (an older bootloader, or no slave chip) leaves the floor unknown, and an unknown floor vouches for nothing. `0x211` START: the master relays it, starts hashing and loads the trusted keys from the trust table of its bootloader (flash `0x08000200`). The slave erases its backup slot and makes a nonce.
2. `0x212` digest, `0x213` data: relayed. The master hashes every byte it relays.
3. `0x21A` record: kept by the master, not sent to the slave.
4. `0x214` END: the master checks that every byte arrived and was relayed, rebuilds the 28-byte header (slave hardware id, size, CRC, version), and verifies the record under a trusted key over that header and the SHA-256 of the relayed bytes, and refuses a record whose counter is below the floor of the slave. **Only then** it writes the counter to `0x0C` and relays END to the slave.
5. The slave checks CRC-32, SHA-256, the counter against its floor (reason `0x05` ROLLBACK when it is below) and the version rule, and goes to AWAIT_CONFIRM. Nothing is written to its metadata and its main slot is not touched.
6. The master waits (one second at most) for AWAIT_CONFIRM, reads the nonce from `CHALLENGE`, and writes the confirmation to `CONFIRM`.
7. The slave reads its backup slot **again**, rebuilds the message, compares the tag, checks the counter against the floor once more and, if all of it holds, appends the pending-copy record (which already carries the new floor), copies the image to the main slot, reads the copy back against the digest and resets. A wrong tag, an altered image or no tag fails the update at once (main slot untouched, status VERIFY_FAIL).

The sequence has no step the slave can skip: with no confirmation it waits ten seconds and fails closed.

## What is covered

Host tests (`tests/test_slaveboot_update.c`, `tests/test_slave_attest.c`, `tests/test_can_slavebridge.c`) cover: a valid confirmation, an absent one, a wrong tag, a confirmation sent twice, a replay of the confirmation of an earlier session, a confirmation for another image, version or size, an image altered after the checks, no signature record, a record of another key, a record for the main board's hardware id, a damaged record, data that did not reach the slave, a power cut while the slave waits, and a power cut after the confirmation with the backup slot changed while the chip was off. The counter has its own cases: a record below the floor (also with a newer version), equal to it and above it, a replay of an older signed image after the floor moved up, a master that never sent the counter or confirmed another one, a power cut at each of the 36 half-words of an appended metadata record, the floor moving in the same record as the pending copy, and the log recycled after 28 records. The bridge side (`tests/test_can_slavebridge.c`) covers the floor read, the counter sent before END, a record below the floor and a slave that does not report its floor.
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
