JuanenRac/URTC/PCB/URTC_PINLIST.TXT

Pinlist

Exported from URTC_V1.0.sch at 01/08/2026 0:09

EAGLE Version 9.5.2 Copyright (c) 1988-2019 Autodesk, Inc.

Part           Pad      Pin        Dir      Net

+3V3           A        A          pas      N$41
               C        C          pas      GND

+3V3B          A        A          pas      N$66
               C        C          pas      GND

+5V            A        A          pas      N$67
               C        C          pas      GND

BOOT           1        P          pas      BOOT0
               2        S          pas      N$36
               3        P1         pas      BOOT0
               4        S1         pas      N$36

C1             1        1          pas      N$37
               2        2          pas      GND

C2             1        1          pas      +5V
               2        2          pas      GND

C3             1        1          pas      +3V3
               2        2          pas      GND

C4             1        1          pas      N$6
               2        2          pas      GND

C5             1        1          pas      +3V3
               2        2          pas      GND

C6             1        1          pas      +3V3
               2        2          pas      GND

C7             1        1          pas      +5V
               2        2          pas      GND

C8             1        1          pas      +3V3
               2        2          pas      GND

C9             1        1          pas      STM_RST
               2        2          pas      GND

C10            1        1          pas      N$12
               2        2          pas      GND
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
