JuanenRac/URTC/images/TOOL_DRILL.png

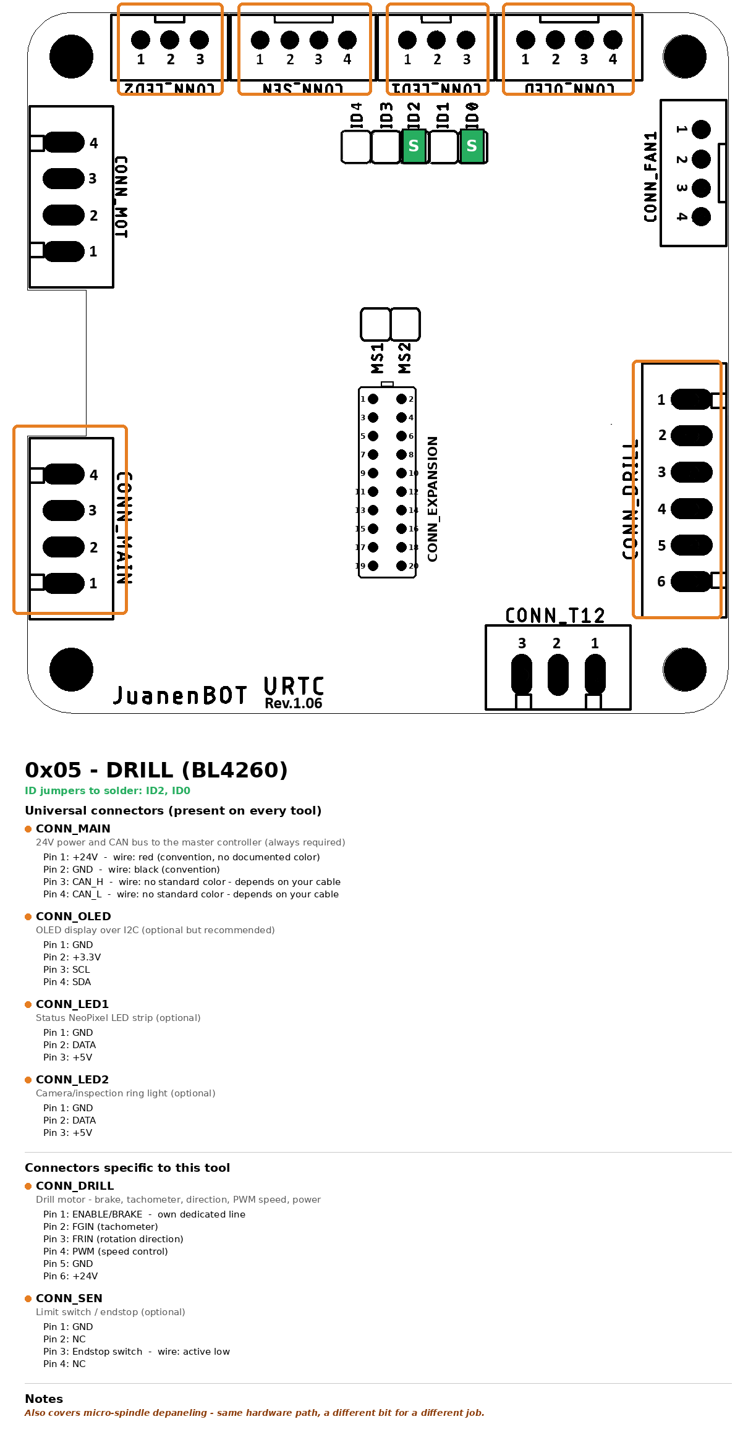
images/TOOL_DRILL.png
