JuanenRac/URTC/images/TOOL_LASER_ENGRAVER.png

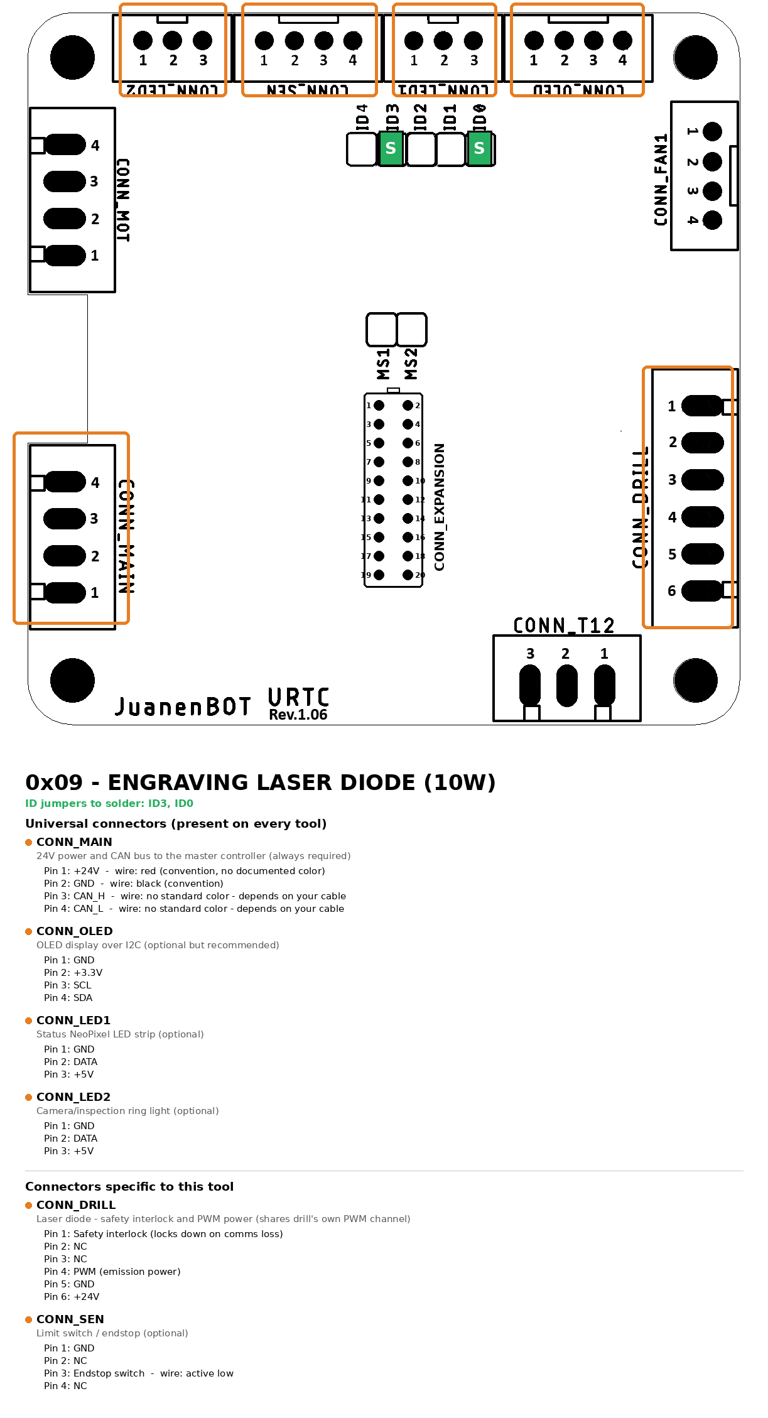
images/TOOL_LASER_ENGRAVER.png
