JuanenRac/URTC/images/TOOL_SCAN_PROBE.png

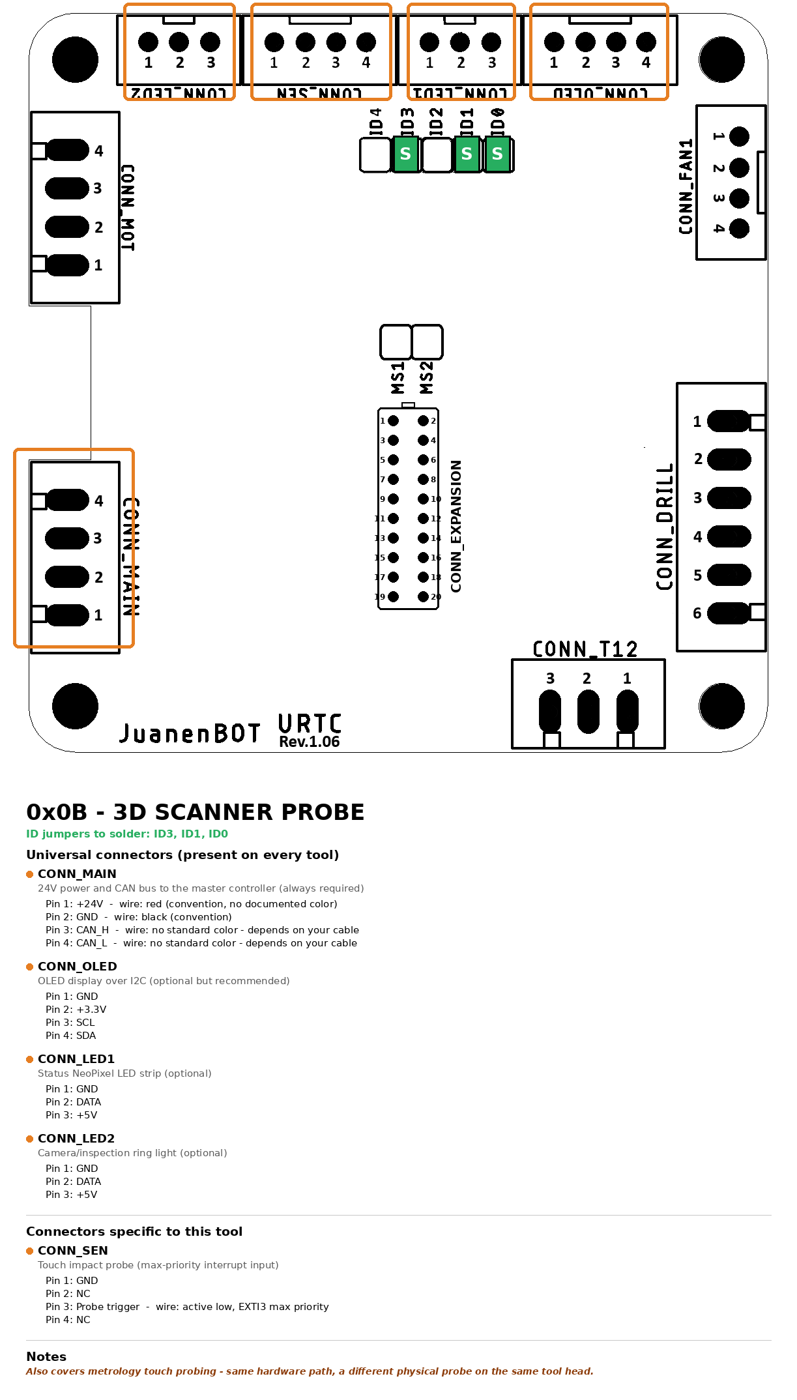
images/TOOL_SCAN_PROBE.png
