JuanenRac/URTC/images/TOOL_ULTRASONIC_WELDER.png

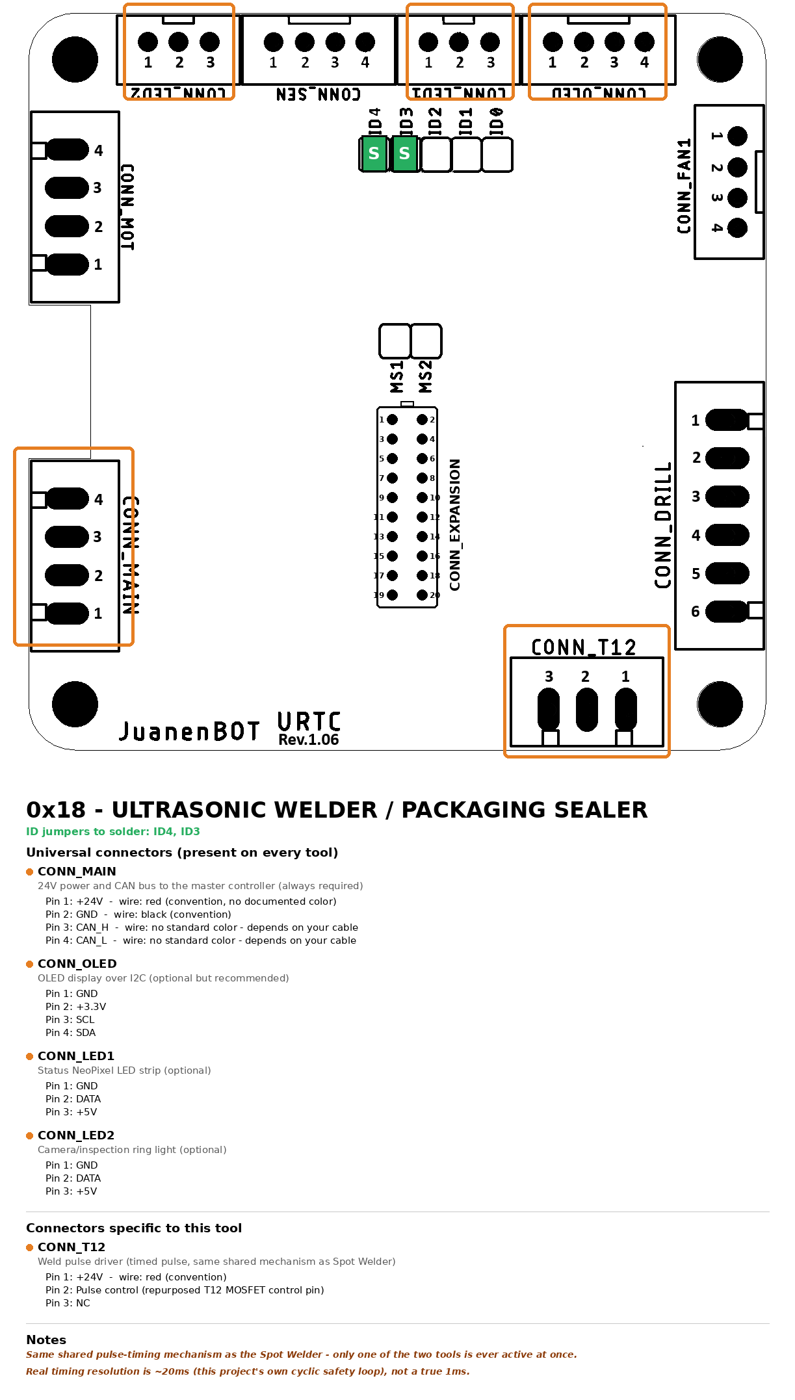
images/TOOL_ULTRASONIC_WELDER.png
