JuanenRac/URTC/images/TOOL_UV_CURING.png

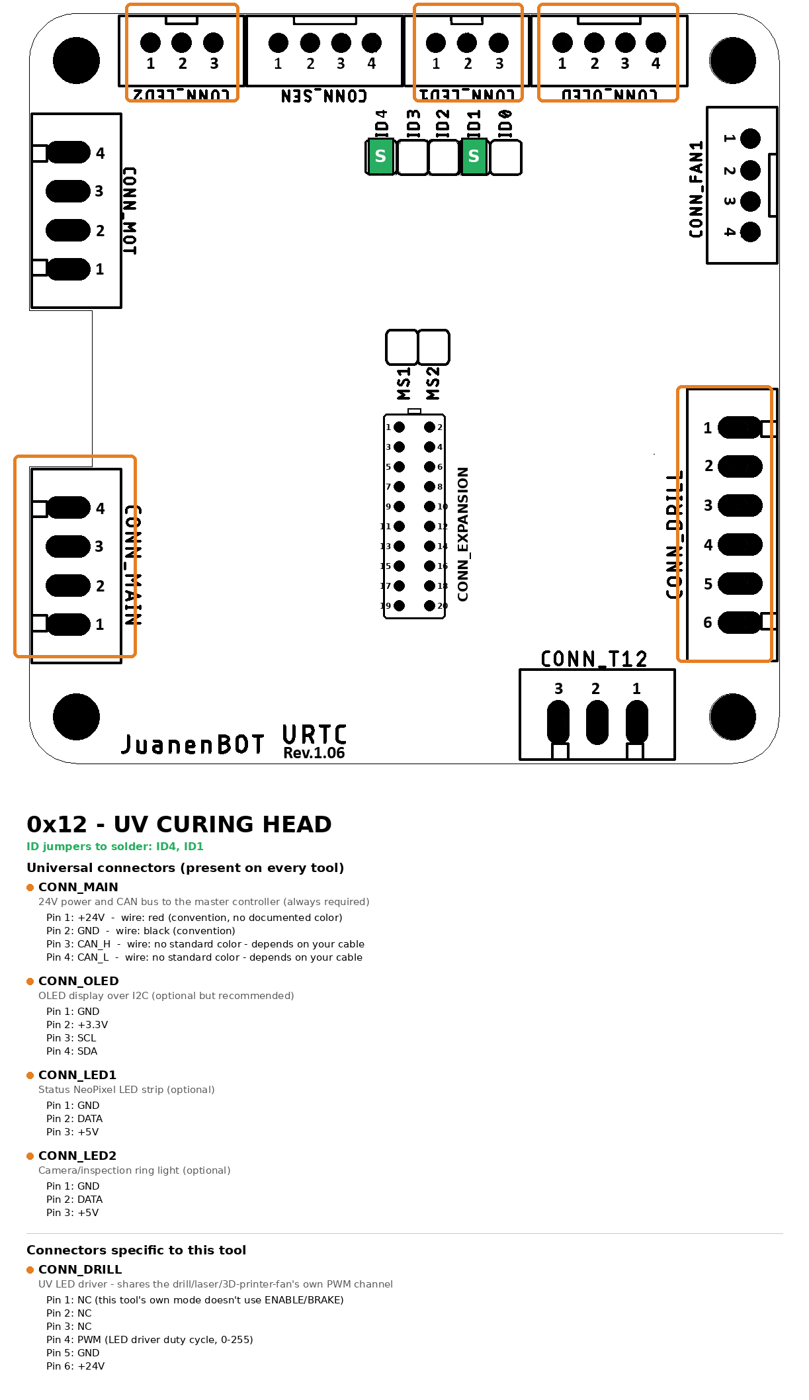
images/TOOL_UV_CURING.png
