JuanenRac/URTC/images/TOOL_VACUUM_GRIPPER_LG.png

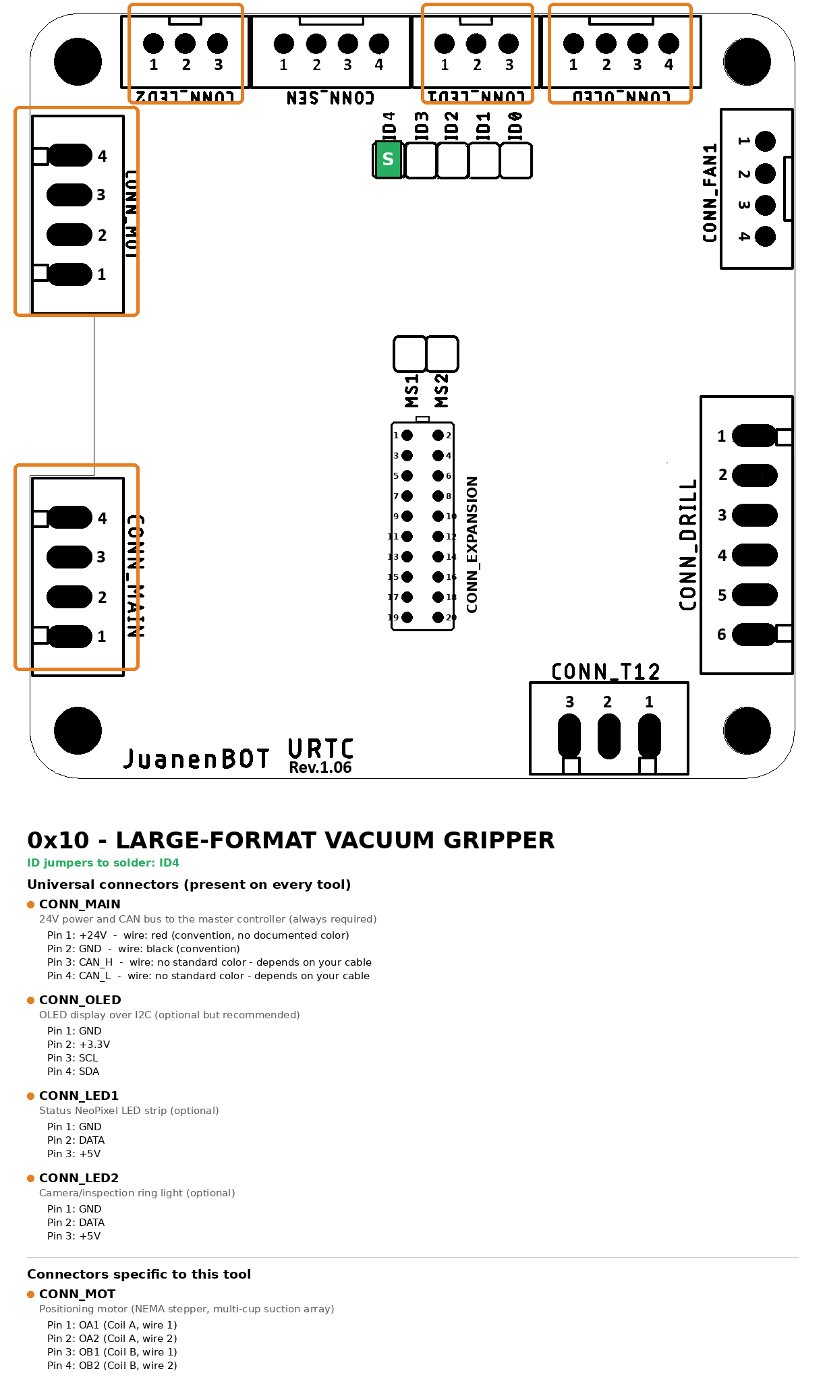
images/TOOL_VACUUM_GRIPPER_LG.png
