JuanenRac/URTC/images/TOOL_VACUUM_PICKUP.png

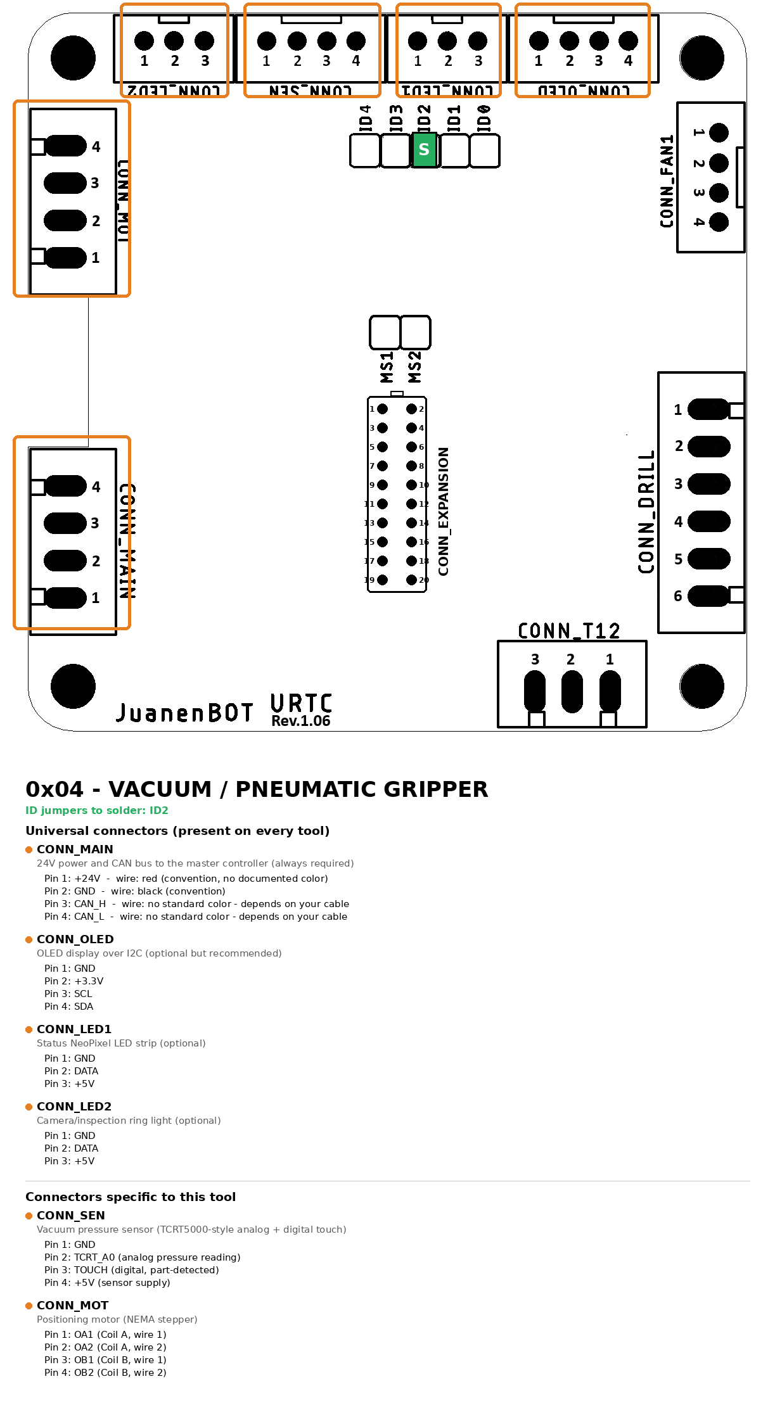
images/TOOL_VACUUM_PICKUP.png
