JuanenRac/URTC/3D/RACK/Rack_x1.stl

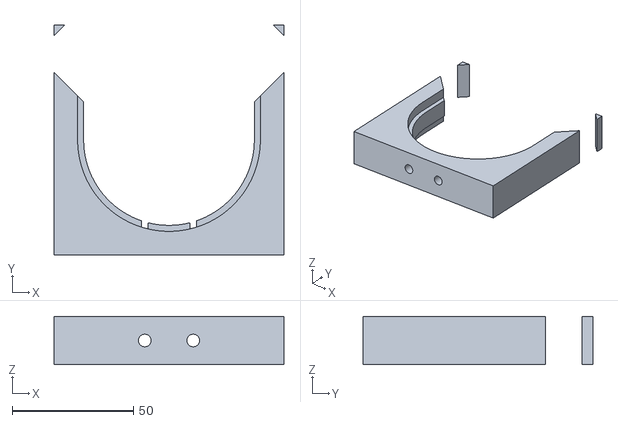
[picture p18: CAD file, 2026-09-07]
3D/RACK/Rack_x1.stl
95.0 x 95.0 x 20.0
