JuanenRac/URTC/3D/TOOLS/PAROL6/0.Universal parts/ATC_slave_part.stl

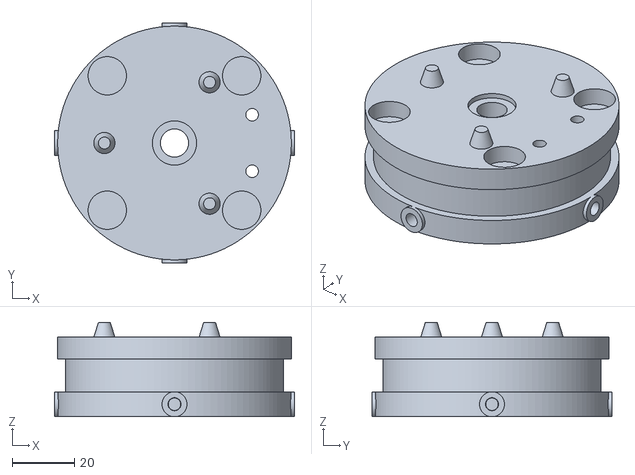
[picture p19: CAD file, 2026-09-07]
3D/TOOLS/PAROL6/0.Universal parts/ATC_slave_part.stl
77.0 x 77.0 x 30.3
