JuanenRac/URTC/3D/TOOLS/PAROL6/1.Soldering Station (T12)/Part_1.3mf

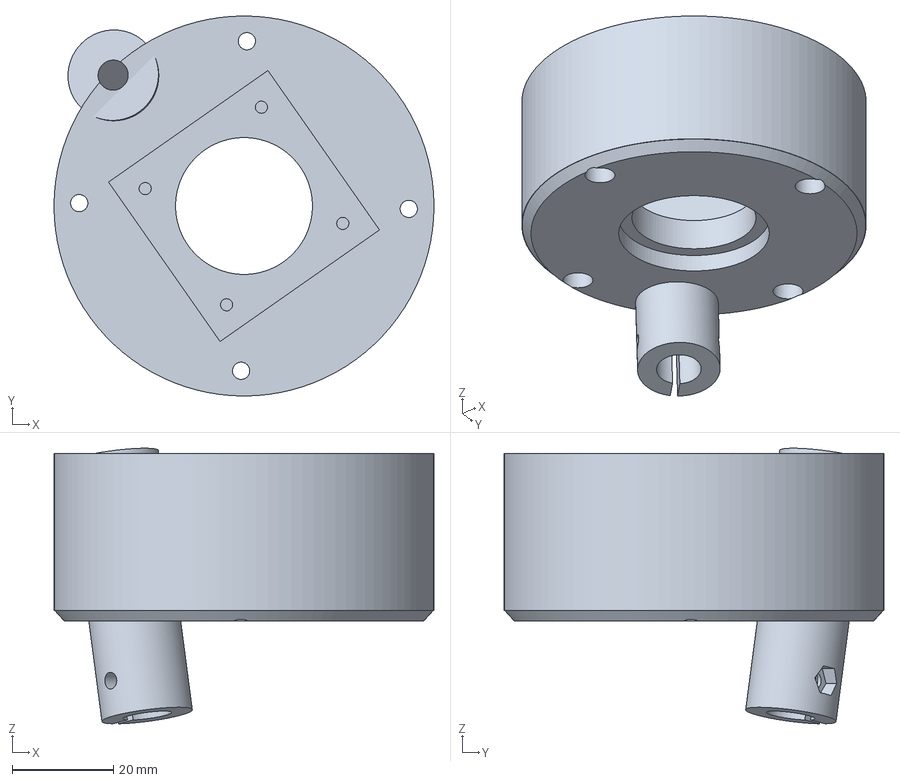
[picture p20: CAD file, 2026-09-07]
3D/TOOLS/PAROL6/1.Soldering Station (T12)/Part_1.3mf
75.0 x 75.0 x 54.4 mm
