JuanenRac/URTC/3D/TOOLS/PAROL6/2.SMT Solder Paste Dispenser/Part_2.amf

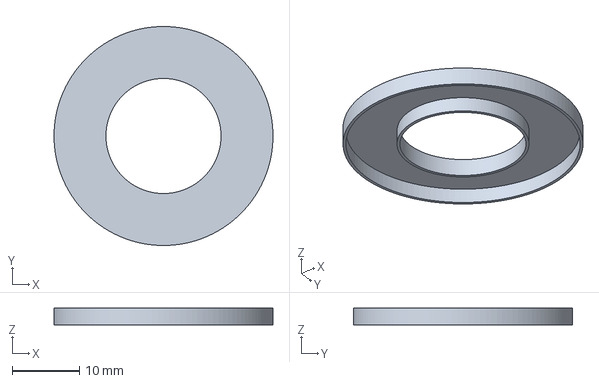
[picture p21: CAD file, 2026-09-07]
3D/TOOLS/PAROL6/2.SMT Solder Paste Dispenser/Part_2.amf
32.6 x 32.6 x 2.50 mm
