JuanenRac/URTC/3D/RACK/Rack_x3.amf

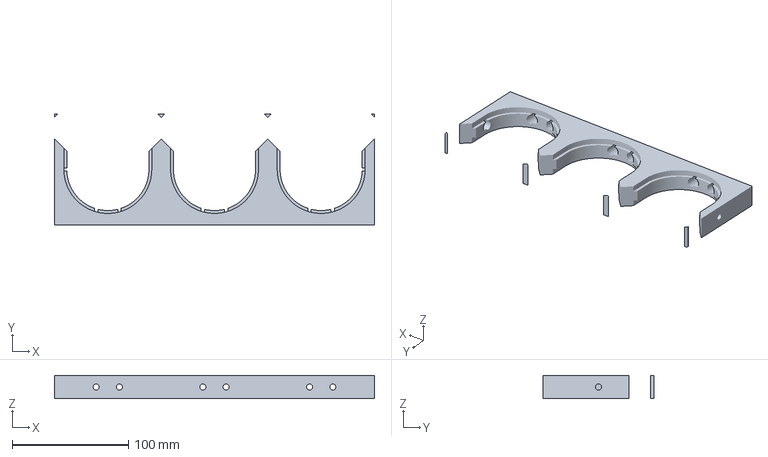
[picture p22: CAD file, 2026-09-07]
3D/RACK/Rack_x3.amf
275.0 x 95.0 x 20.0 mm
