JuanenRac/URTC/3D/TOOLS/PAROL6/0.Universal parts/ATC_master_part.stl

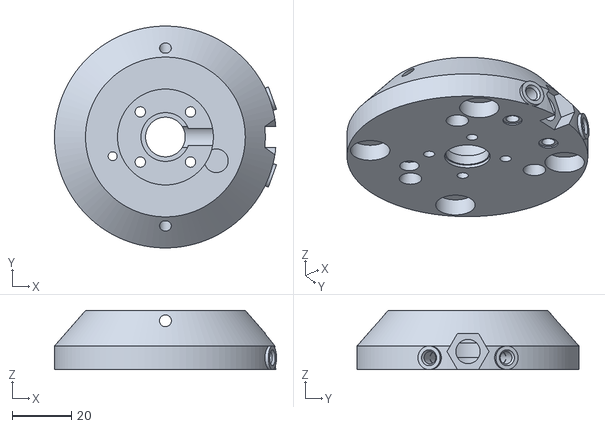
[picture p23: CAD file, 2026-09-07]
3D/TOOLS/PAROL6/0.Universal parts/ATC_master_part.stl
75.0 x 75.0 x 20.0
