JuanenRac/URTC/(list of files, cad)

Other CAD files:
3D/TOOLS/PAROL6/0.Universal parts/ATC_master_part.amf
