JuanenRac/URTC/docs/BENCH_TESTS.md

# Bench tests for the firmware

Nothing in this file has been run on a real board yet. Each test below lists the
setup, the steps and the expected result so that the first run on hardware can
be recorded as pass or fail without interpretation. Until a row of the result
column is filled in with a real run, the behaviour it covers is only proven by
the host tests and the simulators, not on silicon.

Setup common to all tests: one master board, one tool head with a slave chip
(STM32F303CB), a CAN adapter that speaks SLCAN, a bench supply with a current
limit, a logic analyser on the I2C lines, and the firmware images built from the
commit under test (note the commit and the `0x7E9` version in the result).

| # | Area | Result |
|---|---|---|
| 1 | Slave I2C clock enable order | not run |
| 2 | Slave I2C receive direction and callback | not run |
| 3 | Slave RAM size in the linker script | not run |
| 4 | Slave local bus pins (I2C2) | not run |
| 5 | Slave start-up with a stored sensor variant | not run |
| 6 | Saved-state migration after an update | not run |
| 7 | Power cut during a firmware update | not run |
| 8 | Version readout and anti-rollback | not run |
| 9 | Closed list of slave registers | not run |
| 10 | Bootloader addressing by serial number (several heads) | not run |
| 11 | Ed25519 and HMAC policy of the bootloader | not run |
| 12 | Hard fault dump and watchdog | not run |
| 13 | Head telemetry through the rack | not run |
| 14 | Ed25519 record, trust table and metadata log of the main bootloader | not run |
| 15 | Expansion slave: confirmation by the master | not run |

## 1. Slave I2C clock enable order

Why: the slave application and its bootloader enable the I2C peripheral clock
after the HAL initialisation call, which can leave the peripheral unclocked.

Steps: flash the slave with the change that enables the clock first; probe SCL
and SDA while the master scans the bus.

Expected: the slave acknowledges its address on the first scan after reset, with
no retry. With the old order the first scan may fail.

## 2. Slave I2C receive direction and callback

Why: the address callback of the slave bootloader now arms the receive for a
write by the master (the HAL gives the direction of the master: TRANSMIT is a
write) and a transmit for a read; the design assumes the receive-complete
callback fires on STOP, which only the board can confirm.

Steps: write 1, 4 and 8 bytes from the master to the slave; read them back
through a status register; repeat with a repeated START.

Expected: the byte count seen by the slave equals the bytes sent in all cases;
no byte is lost or duplicated; a transfer shorter than the buffer still
completes.

## 3. Slave RAM size in the linker script

Why: the scripts declare 40 KiB of RAM for a chip whose data sheet gives 32 KiB.

Steps: set the length to 32K, link both the application and the bootloader,
read the map file; run the application with the stack at the new top.

Expected: the link succeeds with room to spare, the stack top is `0x20008000`,
and the board runs a thermal capture without a fault.

## 4. Slave local bus pins (I2C2)

Why: the documentation and the master side disagree about whether PB10 and PB11
offer an I2C alternate function on this chip.

Steps: read the alternate-function table of the data sheet for the exact part,
probe PB10 and PB11 while the slave reads the sensor.

Expected: the sensor answers on the pins that the firmware drives, or the
firmware and the pinout document are changed to the pins that do carry I2C.

## 5. Slave start-up with a stored sensor variant

Why: the sensor driver is initialised before the master has told the slave which
sensor variant is fitted, so the variant is still "none" at that moment.

Steps: fit each supported thermal sensor in turn, power-cycle the head without
the master configuring it, read the first frame.

Expected: the sensor is initialised on the first boot with the stored variant;
no frame is requested from an uninitialised sensor.

## 6. Saved-state migration after an update

Why: raising the saved-state version discards the whole stored record.

Steps: store a non-default configuration with the old image, update to the new
image that carries a higher saved-state version, read the configuration back.

Expected: the one-time hardware settings survive the update; only fields that
did not exist before take their defaults.

## 7. Power cut during a firmware update

Why: the backup slot and the staged copy must leave the board bootable whatever
instant the supply is lost.

Steps: start an update; cut the supply at about 10, 30, 50, 70 and 90 percent of
the transfer and during the final copy (use the bench supply's programmable
output or a relay); restore power each time and read the version through `0x7E9`.

Expected: after every cut the board boots either the old or the new complete
image, never a mix; an interrupted update can be restarted without a programmer.
Record the percentage and the version after each cut.

## 8. Version readout and anti-rollback

Steps: read `0x7E9` on a board with the new firmware; try to flash the previous
release.

Expected: the readout shows major, minor and patch matching the image; the
downgrade is refused by the flasher and by the bootloader.

## 9. Closed list of slave registers

Steps: from the CAN side, read registers inside and outside the closed list, and
registers `0x220` and `0x221`; send a zero-length read.

Expected: only listed registers answer; everything else and the zero-length read
are rejected with the documented error code.

## 10. Bootloader addressing by serial number

Steps: connect two or more heads in application mode, query the bootloader with
the probe frame (`0x7EA`), select one by its serial, update only that one.

Expected: exactly one head is selected at a time, the others stay silent, and
the release frame (`0x7EB` to `0x7ED` group) returns all of them to normal.

Programmed serial (a bootloader built with `URTC_BL_PROGRAMMABLE_SERIAL=1` and a trust table that holds the public half of the key of the command): make the command with
`tools/serial_command.py` of URTC-FLASHER from the unique ID the head answers to the UID query, send the twelve frames of `0x7EE`, expect `0x7EF` with status 0 and
the new serial. Power-cycle the head: the probe and the selection answer with the new serial. Send the same twelve frames again: status 3 (replay). Send a command
made for another head or with another key: status 1 or 2 and nothing changes. Then fill the log of the metadata (repeated updates) until the page is recycled and
check that the serial is the same afterwards. Never tried on a board.

## 11. Ed25519 and HMAC policy of the bootloader

Steps: load images signed with Ed25519 only, HMAC only and both; load an image
with a broken signature.

Expected: with the default policy (`ed25519_only`) only the Ed25519 image is
accepted; a broken signature is refused and the previous image keeps running.

## 12. Hard fault dump and watchdog

Steps: force a hard fault (a debug command or a deliberate bad pointer), reset,
read the dump kept in the no-init area; stop feeding the watchdog.

Expected: the dump names the faulting address and registers and survives the
reset; the watchdog resets the board within its configured period, and the clock
source (internal oscillator or crystal) matches the build.

## 13. Head telemetry through the rack

Steps: connect a head to the rack, change the soldering iron and hot-air set
points, unplug the head.

Expected: the two questions and the set point frames are exchanged as in the
protocol document, counters advance, and an unplugged head is reported as lost
within the configured time.

## 14. Ed25519 record, trust table and metadata log of the main bootloader

Steps, all with a main board that has the development bootloader flashed over SWD (its key is public, so any bench machine can sign an image for it; the seed is published with the shared reference):
1. Update with a valid record: the board reaches VERIFY OK, resets, and the version query answers the new version; the `0x7ED` frame holds the key id of the table.
2. Flip one bit of the record, then of the image, then change the version declared in `0x7F4`: each update is refused with reason 0x03 (or 0x02 for the image) and the main slot is untouched.
3. Send a record signed by another key: refused with 0x03. Flash a bootloader whose table lists that key as `next`: it installs.
4. Flash the official bootloader (closed table): every update, even with a valid development record, is refused with 0x03 and `0x7ED` is silent.
5. Install counter 5, then try counter 3 with a newer version: refused with 0x05, also after `0x7FD`; counter 7 installs.
6. Cut the power at several points of an update: during the data, during the verification (the SHA-256 and the Ed25519 take seconds), during the copy and during a metadata write. After each cut the board boots the old or the new application, never a damaged one; a cut during the copy resumes it at the next start.
7. Install 14 versions in a row (28 records) and one more: the page is compacted and the board still boots the newest; repeat with a power cut at the compaction (the expected result is a first-boot adoption with the compiled floor).
8. Measure with the debugger the time of one verification and the stack watermark, and read the size of the three bootloaders in the build log of Actions.

Expected: every refusal leaves the previous application running; the watchdog never fires during a verification (the verifier feeds it every 8 bits of the scalar).

Status: not run on a board.

## 15. Expansion slave: confirmation by the master

1. Update the slave with a valid record: the master verifies it, the slave goes to status 0x08 and then installs; measure the time between the last data frame and the reset, and the time the master spends verifying (the watchdog must not fire and the CAN receive FIFO must not overflow).
2. Send the same image without the 0x21A frames: after ten seconds 0x215 reports VERIFY_FAIL and 0x219 reports 0x06; the slave application keeps running.
3. Flip a bit of the image on the wire: refused with 0x03, main slot untouched. Disconnect the link bus between END and the confirmation: refused with 0x06 after ten seconds.
4. Cut the power of the slave while it waits and after the confirmation, during the copy: the next boot runs the old or the new application, never a damaged one.
5. Read the size of the slave bootloader in the build log of Actions against the 18432-byte region, and the stack high-water mark of the master during a verification inside the application.
6. Confirm on the real I2C link that a clock-stretching slave answers the status and challenge reads while it hashes its backup slot.

7. Rollback counter of the slave: install an image signed with counter N, then try an older signed image (counter below N, also with a newer version) and confirm it is refused with reason ROLLBACK and the main slot untouched; read the floor from register `0x0B` over the link bus. [HW]
8. Cut the power of the slave at several instants while the metadata record is appended (just before, during and just after) and check on every boot that the floor read back is the old or the new one, never zero. [HW]
9. Fill the 28 slots of the metadata page on a real chip (28 updates, or a test build that appends faster) and cut the power during the erase of the full page: record what the floor falls back to and how long the page stays blank. [HW]
10. Read the size of the slave bootloader in the build log of Actions after the HMAC routine and key were removed and the metadata log and the counter were added, against the 18432-byte region. [HW]

Status: not run on a board.

## What runs without a board

Some of the behaviour above is exercised on a PC by compiling the real C for the host. This is not a bench test and does not replace one: it says nothing about the pins, the clocks, the interrupt timing, the flash of the chip or the CAN transceiver.

| What | How to start it | What it covers |
|---|---|---|
| The virtual board | `python tools/fuzz_virtual_board.py` (or `urtc-virtual-board --firmware-repo DIR` of URTC-COMMON, then `URTC_VIRTUAL_PORT=socket://127.0.0.1:7777` in the tester, the flasher or the gateway) | The real receive path of the application behind an SLCAN text port, with the address and undefined-behaviour sanitizers: it never stops on a frame of the specification or a random one, only transmits identifiers a board may send and resets into the bootloader exactly on the magic frame |
| The twin of the bootloader | `python tools/bootloader_twin.py --check` (`--build-only` prints the command that runs it; `urtc-virtual-board --firmware-bootloader` bridges to it) | The real bootloader of the master (window, main loop, flash that only clears bits until a page is erased, CRC, Ed25519 record, trust table): a signed update is taken; a bad signature, an unknown key, a counter below the floor, a foreign board and a transfer left silent are refused or abandoned |
| The host suites | `python tools/run_host_tests.py` | The logic of the firmware against a fake HAL |
| The model of the slave bootloader | `python tools/slave_bootloader_twin.py --check` (Python only, no compiler) | The logic of the expansion slave's bootloader written from its C: the register protocol, the update states, the confirmation by the master, the rollback floor, the metadata log, the resume of a cut copy (about 400 power cuts over one update), the ten-second silence rule and the jump rules. It also models the four properties that tests 2, 10 and 15 have to confirm on a board, each with the code before its fix as an option: the direction of the address callback (fixed), the loss of short writes if the HAL reports the early STOP as an error (still open), the listening window before a valid application (added, 600 ms, a build parameter) and the work of END and of the confirmation, and the 200 ms pause, which now run in the main loop instead of the I2C event callback (START still erases inside it) |
| The flasher against the twin | the tests of URTC-FLASHER (`tests/test_bootloader_twin.py`) | The flasher unchanged against the real bootloader, with the image and its `.imgsig` file |

On a plain PC these tools compile only on request: `ALLOW_LOCAL_BUILD=1` allows it (inside WSL on Windows, because the fake flash needs a 64-bit Linux), and the CI always may. Without a compiler they say SKIPPED (exit status 2), never passed. The bootloader of the expansion slave is a model written from its source, not its compiled code; the bus timing, the interrupt priorities and the real flash are not simulated, and bench tests 1 to 15 stay as they are.
