JuanenRac/URTC/src/F303-master/firmware_control_thermal.c

// =============================================================================
// URTC Firmware - Thermal PID control (soldering iron, 3D printer hotend)
// Copyright (C) 2026 JuanenRac (Electro Hobby 3D) <electrohobby3d@gmail.com>
// GPL-3.0-or-later - see LICENSE
// =============================================================================
#include "firmware_common.h"
#include "firmware_control_thermal.h"
#include "thermal_guard.h"
#include "firmware_thermal_stats.h"
#include "firmware_features.h"
#include "t12_settle.h"

// Last thermal-guard fault (ThermalGuardFault_t), 0 = none. Reported as the
// 5th byte of the 0x111 state answer so a host knows WHY the board blocked
// itself, not just that it did. Latched like system_error_flag itself.
volatile uint8_t thermal_fault_code = THERMAL_GUARD_OK;

// Thermal runaway limits (see thermal_guard.h). The T12 cartridge heats in
// seconds, so its heating window is short; the hotend block is slower. The
// holding-phase hysteresis is generous on purpose - soldering a large pad
// or a big print move legitimately pulls the temperature down for a while -
// but no healthy heater stays more than that far below its target for the
// whole hold period while running flat out.
// T12 max_temp_c = 449: the thermocouple mapping can never report more
// than 449 (the ADC rail guard above refuses anything >= 4090), so on this
// tool the rail guard IS the MAXTEMP and the ceiling here only documents it;
// a lower value would trip on the normal +2C overshoot of a 445C setpoint.
// A new setpoint restarts the watch of the guard only when it rises by more than this many degrees (0: any change does, as it did before). The default of 5 keeps
// a slider or an external PID that moves the setpoint a degree at a time from hiding a sensor that has come loose. Build with -DURTC_THERMAL_GUARD_RETARGET_C=<n> to change it.
#ifndef URTC_THERMAL_GUARD_RETARGET_C
#define URTC_THERMAL_GUARD_RETARGET_C 5
#endif
static const ThermalGuardLimits_t T12_GUARD_LIMITS = {
    .max_temp_c = 449, .watch_period_ms = 20000, .watch_min_rise_c = 10, .watch_band_c = 20,
    .hold_period_ms = 45000, .hold_hysteresis_c = 40, .retarget_min_rise_c = URTC_THERMAL_GUARD_RETARGET_C,
};
static const ThermalGuardLimits_t HOTEND_GUARD_LIMITS = {
    .max_temp_c = 310, .watch_period_ms = 40000, .watch_min_rise_c = 2, .watch_band_c = 10,
    .hold_period_ms = 40000, .hold_hysteresis_c = 15, .retarget_min_rise_c = URTC_THERMAL_GUARD_RETARGET_C,
};
static ThermalGuard_t t12_guard;
static ThermalGuard_t hotend_guard;

// Shared fault path: heater off, board error latched, reason recorded.
static uint8_t ThermalGuard_Apply(ThermalGuardFault_t fault) {
    if (fault == THERMAL_GUARD_OK) return 0;
    thermal_fault_code = (uint8_t)fault;
    RAISE_SYSTEM_ERROR(URTC_ERROR_REASON_THERMAL);
    target_temperature = 0;
    HAL_GPIO_WritePin(T12_PWM_PORT, T12_PWM_PIN, GPIO_PIN_RESET);
    ThermalStats_NoteFault((uint8_t)fault); // after the heater is already off
    return 1;
}

void Control_ThermalGuardsReset(void) {
    ThermalGuard_Reset(&t12_guard);
    ThermalGuard_Reset(&hotend_guard);
}

void Control_SolderingIron_PID(void) {
    if (active_tool != TOOL_SOLDERING_IRON && active_tool != TOOL_HOTAIR_REWORK) {
        ThermalGuard_Reset(&t12_guard);
        return;
    }

    // The T12 cartridge routes its heater current and its internal
    // thermocouple through the same two conductors. Force the heater off
    // and give the line a brief settling window before sampling - reading
    // while it's still on (e.g. left on from the previous 20ms cycle's
    // decision) would sample the 24V switching transient instead of the
    // thermocouple's real microvolt-level signal. The bang-bang decision
    // below turns it back on immediately if still needed; the tip's own
    // thermal mass is large relative to this brief window.
    HAL_GPIO_WritePin(T12_PWM_PORT, T12_PWM_PIN, GPIO_PIN_RESET);
    for (volatile uint32_t settle = 0; settle < urtc_t12_settle_loops(URTC_T12_SETTLE_US); settle++); // 10 us @ 64 MHz unless the build says otherwise (t12_settle.h)

    // AD8605 thermocouple ADC reading
    HAL_ADC_Start(&hadc);
    // 2ms timeout, not 10ms: a healthy conversion completes in
    // microseconds at any reasonable clock config, so this only ever
    // actually waits the full duration when something's already wrong -
    // bounding it tighter limits how long a stuck ADC can stall the rest
    // of this 20ms-cyclic block (watchdogs included) before either
    // succeeding or falling through to the fault handling below.
    if (HAL_ADC_PollForConversion(&hadc, 2) == HAL_OK) {
        uint32_t adc_val = HAL_ADC_GetValue(&hadc);
        // Same fault-detection philosophy as the hotend NTC below: a failed
        // amplifier or an open/shorted thermocouple typically pins the ADC
        // reading near one rail (~0 or ~4095), not somewhere in the middle
        // of the working range. Catch that instead of computing and trusting
        // a bogus temperature from it.
        if (adc_val > 15 && adc_val < 4090) { // see the hotend NTC section below for why 4090, not 4080
            current_temperature = (uint16_t)(((adc_val * 450) + 2047) / 4095); // Mapped to 450C max, rounded to nearest degree
        } else {
            RAISE_SYSTEM_ERROR(URTC_ERROR_REASON_SENSOR);
        }
    } else {
        // A conversion that can't complete even within this 2ms budget is
        // exactly as untrustworthy as one that comes back out of range -
        // raising the fault here (rather than leaving current_temperature
        // frozen at its last value) keeps the heater from running off a
        // stale reading with no indication anything's wrong.
        RAISE_SYSTEM_ERROR(URTC_ERROR_REASON_SENSOR);
    }
    HAL_ADC_Stop(&hadc);

    // Strict independent safety ceiling to mitigate catastrophic thermal-runaway risk.
    // 445, not 450: the ADC range guard above caps current_temperature's own
    // max representable value at 449 (adc_val must stay below 4090 to be
    // trusted at all - see that guard's own comment). The bang-bang shutoff
    // below only fires once current_temperature exceeds target_temperature+2,
    // so a target sitting right at 450 would leave that condition
    // (449 > 452) permanently unsatisfiable - the heater reaching its own
    // measurable ceiling with no way to command itself off. 445 leaves the
    // shutoff condition (up to 447) comfortably below what can actually be
    // measured.
    if (target_temperature > 445) {
        target_temperature = 0;
        RAISE_SYSTEM_ERROR(URTC_ERROR_REASON_THERMAL);
    }

    if (system_error_flag) {
        HAL_GPIO_WritePin(T12_PWM_PORT, T12_PWM_PIN, GPIO_PIN_RESET);
        return;
    }

    // Stuck-heater detection: a MOSFET or SSR that's fused/shorted from
    // thermal stress keeps conducting regardless of what this GPIO
    // commands - a real, known power-semiconductor failure mode. If the
    // output's been continuously off for 3s yet temperature keeps rising
    // instead of leveling off or falling, that's consistent with exactly
    // that, well before the absolute 450C ceiling below would catch it.
    // This adds earlier warning on top of that ceiling, not instead of it -
    // if the power stage is genuinely fused, cutting this signal can't
    // actually help either way; a real fix needs an independent hardware
    // cutoff downstream of this GPIO, which this alone can't provide.
    static uint8_t heater_on = 0;
    // t12_off_timer_armed, not t12_pwm_off_since==0, is what distinguishes
    // "timer not yet started" from "started right at a HAL_GetTick() value
    // of 0" - the tick counter legitimately reads 0 both right at boot and
    // again every ~49.7 days when the 32-bit millisecond counter wraps, and
    // either would otherwise fail to arm this stuck-heater detector for
    // that one cycle.
    static uint8_t t12_off_timer_armed = 0;
    static uint32_t t12_pwm_off_since = 0;
    static uint16_t t12_temp_at_off = 0;
    if (heater_on) {
        t12_off_timer_armed = 0;
    } else {
        if (!t12_off_timer_armed) {
            t12_off_timer_armed = 1;
            t12_pwm_off_since = HAL_GetTick();
            t12_temp_at_off = current_temperature;
        } else if (HAL_GetTick() - t12_pwm_off_since > 3000 &&
                   current_temperature > t12_temp_at_off + 5) {
            RAISE_SYSTEM_ERROR(URTC_ERROR_REASON_THERMAL);
            HAL_GPIO_WritePin(T12_PWM_PORT, T12_PWM_PIN, GPIO_PIN_RESET);
            return;
        }
    }

    // Bang-Bang thermal loop, gated by the absolute safety ceiling. Small
    // hysteresis band (+/-2C) added: with zero hysteresis, once the reading
    // settles exactly at the setpoint this would toggle the heater on/off
    // every 20ms tick indefinitely - pure switching stress and noise for no
    // control benefit.
    if (Features_Active(FEAT_THERMAL_PID)) {
        // Optional PID (switch off by default, see firmware_features.h): the output is on-time inside a
        // half-second window instead of a hysteresis. The guards below and the absolute ceiling above
        // judge this decision exactly as they judge the bang-bang one.
        heater_on = ThermalPid_Heater(current_temperature, target_temperature, HAL_GetTick());
    } else if ((int32_t)current_temperature < (int32_t)target_temperature - 2) {
        heater_on = 1;
    } else if ((int32_t)current_temperature > (int32_t)target_temperature + 2) {
        heater_on = 0;
    }
    // Thermal runaway guard (loose thermocouple / tip without contact): see
    // thermal_guard.h. Checked with this cycle's real decision, before the
    // pin is driven.
    if (ThermalGuard_Apply(ThermalGuard_Check(&t12_guard, &T12_GUARD_LIMITS, HAL_GetTick(),
                                              heater_on, current_temperature, target_temperature))) {
        heater_on = 0;
        return;
    }
    HAL_GPIO_WritePin(T12_PWM_PORT, T12_PWM_PIN, heater_on ? GPIO_PIN_SET : GPIO_PIN_RESET);
}

// FLASH OPTIMIZATION: replaces the float/logf() Beta-equation calculation.
// The Cortex-M4F has a single-precision FPU, but the log() call still pulls
// in several KB of C library code (logf and its helpers) for a calculation
// that only ever needed to run 33 times' worth of precision. This table was generated
// from the exact same formula (R_PULLUP=4.7k, Beta=3950, R0=100k, T0=25C),
// sampled every 10C from 0 to 320C (deliberately uniform in TEMPERATURE, not
// ADC counts, since the curve is steep enough that uniform-ADC spacing gave
// interpolation errors over 100C at the extremes - this spacing keeps the
// worst-case linear-interpolation error to 0.45C across the whole range).
// {raw_adc, temperature_C}, ascending by raw_adc.
static const int16_t NTC_TABLE[33][2] = {
    {116,320},{130,310},{146,300},{164,290},{185,280},{210,270},{239,260},
    {273,250},{313,240},{360,230},{416,220},{482,210},{560,200},{653,190},
    {763,180},{893,170},{1045,160},{1221,150},{1423,140},{1650,130},
    {1901,120},{2169,110},{2447,100},{2724,90},{2989,80},{3232,70},
    {3444,60},{3621,50},{3762,40},{3869,30},{3947,20},{4002,10},{4039,0}
};

static int16_t NTC_Lookup(uint16_t raw_adc) {
    if (raw_adc <= (uint16_t)NTC_TABLE[0][0]) return NTC_TABLE[0][1];
    if (raw_adc >= (uint16_t)NTC_TABLE[32][0]) return NTC_TABLE[32][1];
    for (uint8_t i = 0; i < 32; i++) {
        int16_t adc0 = NTC_TABLE[i][0], adc1 = NTC_TABLE[i+1][0];
        if ((int16_t)raw_adc >= adc0 && (int16_t)raw_adc <= adc1) {
            int16_t t0 = NTC_TABLE[i][1], t1 = NTC_TABLE[i+1][1];
            // C truncates division toward zero, not toward negative
            // infinity. Because this divider is inverse (hotter = lower
            // ADC), the table is descending - (t1-t0) is negative within
            // every segment, so this numerator is negative whenever
            // raw_adc > adc0. Sign-aware rounding (below) avoids the
            // sawtooth bias plain truncation would otherwise produce at
            // every table breakpoint.
            int32_t numerator = (int32_t)((int16_t)raw_adc - adc0) * (t1 - t0);
            int32_t denom = (adc1 - adc0);
            int32_t rounding = (numerator >= 0) ? (denom / 2) : -(denom / 2);
            return (int16_t)(t0 + (numerator + rounding) / denom);
        }
    }
    return NTC_TABLE[32][1]; // unreachable given the guards above
}

void Control_3D_Hotend_PID(void) {
    if (active_tool != TOOL_3D_PRINTER) {
        ThermalGuard_Reset(&hotend_guard);
        return;
    }
    
    HAL_ADC_Start(&hadc);
    // 2ms timeout - see the soldering iron's identical 2ms budget above
    if (HAL_ADC_PollForConversion(&hadc, 2) == HAL_OK) {
        uint32_t raw_adc = HAL_ADC_GetValue(&hadc);
        // Two things this reading depends on getting right:
        // 1) Topology: R40 (4.7k, confirmed in the netlist) pulls PB0 up to
        //    +3.3V, and the 100k NTC pulls the same node down to GND (per
        //    CONN_SEN: Pin1=GND to the NTC, Pin2=PB0 to the NTC). That's an
        //    inverse divider: hotter -> lower NTC resistance -> lower ADC
        //    reading - the opposite of a direct relationship, which matters
        //    since getting it backwards would read a heating hotend as
        //    cooling down to the PID, a genuine thermal-runaway risk.
        // 2) An NTC isn't linear with temperature; this uses the standard
        //    Beta equation instead of a straight-line guess.
        if (raw_adc > 15 && raw_adc < 4090) { // guard against open/shorted sensor
            // 4090 (~449.6C at this chip's 450C/4095-count mapping) leaves
            // the iron's full legitimate 450C operating range untouched
            // while still catching genuine saturation - an open/shorted
            // sensor pins the ADC essentially at the true rail, not just
            // near the top of the legitimate range.
            current_temperature = (uint16_t)NTC_Lookup((uint16_t)raw_adc);
        } else {
            // A disconnected/shorted sensor is a hardware failure the
            // system needs to react to: without this, current_temperature
            // would stay frozen at its last reading, and the PID loop below
            // has no way to distinguish "still heating toward target" from
            // "sensor is gone and I'm flying blind" - the heater would stay
            // on indefinitely if that frozen reading was below target.
            RAISE_SYSTEM_ERROR(URTC_ERROR_REASON_SENSOR);
        }
    } else {
        // Same reasoning as the soldering iron above: a timed-out poll
        // must raise the fault too, not leave current_temperature frozen
        // with the heater still running on stale data.
        RAISE_SYSTEM_ERROR(URTC_ERROR_REASON_SENSOR);
    }
    HAL_ADC_Stop(&hadc);

    // Independent safety ceiling for the extruder block
    if (target_temperature > 300) {
        target_temperature = 0;
        RAISE_SYSTEM_ERROR(URTC_ERROR_REASON_THERMAL);
    }

    if (system_error_flag) {
        HAL_GPIO_WritePin(T12_PWM_PORT, T12_PWM_PIN, GPIO_PIN_RESET);
        return;
    }

    static uint8_t hotend_heater_on = 0;
    // Stuck-heater detection - see the identical check in
    // Control_SolderingIron_PID for the full reasoning; same failure mode,
    // same GPIO (T12_PWM_PIN is shared between these two heater tools).
    // hotend_off_timer_armed, not hotend_pwm_off_since==0 - see
    // t12_off_timer_armed's own comment in Control_SolderingIron_PID for
    // why this can't just use the tick value itself as its own sentinel.
    static uint8_t hotend_off_timer_armed = 0;
    static uint32_t hotend_pwm_off_since = 0;
    static uint16_t hotend_temp_at_off = 0;
    if (hotend_heater_on) {
        hotend_off_timer_armed = 0;
    } else {
        if (!hotend_off_timer_armed) {
            hotend_off_timer_armed = 1;
            hotend_pwm_off_since = HAL_GetTick();
            hotend_temp_at_off = current_temperature;
        } else if (HAL_GetTick() - hotend_pwm_off_since > 3000 &&
                   current_temperature > hotend_temp_at_off + 5) {
            RAISE_SYSTEM_ERROR(URTC_ERROR_REASON_THERMAL);
            HAL_GPIO_WritePin(T12_PWM_PORT, T12_PWM_PIN, GPIO_PIN_RESET);
            return;
        }
    }
    if ((int32_t)current_temperature < (int32_t)target_temperature - 2) {
        hotend_heater_on = 1;
    } else if ((int32_t)current_temperature > (int32_t)target_temperature + 2) {
        hotend_heater_on = 0;
    }
    // Thermal runaway guard (thermistor fallen out of the block): see
    // thermal_guard.h.
    if (ThermalGuard_Apply(ThermalGuard_Check(&hotend_guard, &HOTEND_GUARD_LIMITS, HAL_GetTick(),
                                              hotend_heater_on, current_temperature, target_temperature))) {
        hotend_heater_on = 0;
        return;
    }
    HAL_GPIO_WritePin(T12_PWM_PORT, T12_PWM_PIN, hotend_heater_on ? GPIO_PIN_SET : GPIO_PIN_RESET);
}

// =============================================================================
// 7. SECONDARY DYNAMIC TELEMETRY AND SENSING SUBSYSTEM
// =============================================================================
