JuanenRac/URTC/src/F303-master/firmware_control_sensors.h

// =============================================================================
// URTC Firmware - Sensor telemetry declarations (vacuum pickup, endstops)
// Copyright (C) 2026 JuanenRac (Electro Hobby 3D) <electrohobby3d@gmail.com>
// GPL-3.0-or-later - see LICENSE
// =============================================================================
#ifndef FIRMWARE_CONTROL_SENSORS_H
#define FIRMWARE_CONTROL_SENSORS_H

void Control_SensorTelemetry(void);
void Control_EndstopTelemetry(void);

#endif // FIRMWARE_CONTROL_SENSORS_H
