JuanenRac/URTC/src/F303-master/firmware_common.h

// =============================================================================
// URTC Firmware - Shared types, defines, and cross-module externs
// Copyright (C) 2026 JuanenRac (Electro Hobby 3D) <electrohobby3d@gmail.com>
// GPL-3.0-or-later - see LICENSE
// =============================================================================
#ifndef FIRMWARE_COMMON_H
#define FIRMWARE_COMMON_H

#include "stm32f3xx_hal.h"
#include "urtc_can_ids.h"
#include <stddef.h>
#include <string.h>
#include <math.h>

// =============================================================================
// TARGET MCU: STM32F303CCT6 (LQFP48 Package - 48 Pins)
// ENVIRONMENT: ASSEMBLY LINE / UNIVERSAL TOOL-HEAD CONTROLLER (URTC v1.1)
// PROJECTS: URTC/HYDRA-UMC (JUANENBOT/PAROL6)
// AUTHOR: JuanenRac (Electro Hobby 3D) - electrohobby3d@gmail.com
// SAFETY HARDWARE ALIGNMENT WITH PINOUT V1.0 AND ECOSYSTEM DOC
// =============================================================================

// Firmware identity - must match bootloader_common.h's THIS_HARDWARE_ID exactly
// (same board, same check). Reported over CAN via 0x7F8/0x7F9 - see
// HAL_CAN_RxFifo0MsgPendingCallback - so a host can ask "what's currently
// running" before deciding what to flash, without needing to trigger a
// reset into the bootloader first just to find out.
#define THIS_HARDWARE_ID     0x0303CC01UL // STM32F303CCT6, URTC board revision 1
// Incremental like the bootloaders (see bump_version.py at the repo root):
// PATCH+1 on every real build, odometer-carry into MINOR/MAJOR.
#define FIRMWARE_VERSION_MAJOR 0
#define FIRMWARE_VERSION_MINOR 4
#define FIRMWARE_VERSION_PATCH 9
#define FIRMWARE_VERSION_BUILD 0

// ID configuration matrix (physical tool-head address readout)
#define ID0_PIN         GPIO_PIN_0  // PF0 - Bit 0
#define ID0_PORT        GPIOF
#define ID1_PIN         GPIO_PIN_1  // PF1 - Bit 1
#define ID1_PORT        GPIOF
#define ID2_PIN         GPIO_PIN_4  // PB4 - Bit 2
#define ID2_PORT        GPIOB
#define ID3_PIN         GPIO_PIN_7  // PB7 - Bit 3
#define ID3_PORT        GPIOB
#define ID4_PIN         GPIO_PIN_13 // PC13 - Bit 4 (32-tool addressing)
#define ID4_PORT        GPIOC

// Dedicated OLED interface via hardware I2C2 (PA9/PA10, AF4)
#define OLED_SCL_PIN    GPIO_PIN_9   // PA9 -> I2C2_SCL (AF4) - confirmed against DS9118 Table 14
#define OLED_SDA_PIN    GPIO_PIN_10  // PA10 -> I2C2_SDA (AF4) - confirmed against DS9118 Table 14
#define OLED_PORT       GPIOA
#define OLED_I2C_ADDR   0x78        // (0x3C << 1)
// FM24CL64B parameter-persistence F-RAM (64Kbit/8KB) on the OLED's I2C2 bus.
// The chip has only two I2C peripherals and every pin pair of the other one
// is taken, and the expansion connector's bus is reserved for future boards,
// so sharing the OLED bus is deliberate. Address 0x50 (A0/A1/A2 to GND) does
// not collide with the OLED's 0x3C.
// F-RAM, not EEPROM: same control-byte/address scheme, but writes complete
// at bus speed with no write cycle to wait for and endurance is in the
// trillions of cycles. See FRAM_WriteBytes() for what this changes.
#define FRAM_I2C_ADDR 0xA0          // (0x50 << 1)
#define FRAM_WRITE_CHUNK 32         // not a hardware page-boundary limit the way EEPROM has (F-RAM has none) - just a conservative, arbitrary transaction size
#define FRAM_SIZE_BYTES 8192        // 64Kbit

// CAN BUS physical pin assignment (AF9)
#define CAN_RX_PIN      GPIO_PIN_11 // PA11 -> CAN_RX (AF9)
#define CAN_TX_PIN      GPIO_PIN_12 // PA12 -> CAN_TX (AF9)
#define CAN_GPIO_PORT   GPIOA

// Coexisting illumination channels: status LED on PA7/SPI1+DMA, ring on
// PB1/bit-banged - kept on two independent pins so CONN_LED1 and CONN_LED2
// don't need a PCB trace joining them in series.
// PA2: free - not used by the status LED, which lives on PA7/SPI1 instead.
#define LED_RING_PIN     GPIO_PIN_1  // PB1 -> Bit-Banging Asm NOPs (Camera Ring)
#define LED_RING_PORT    GPIOB

// Expansion connector's SPI bus (CONN_EXPANSION pins 8/9/12/13) - bit-banged,
// not a hardware SPI peripheral: SPI2's default pins (PB12/13/14/15) are
// already used by EXP_TMC_STEP/DIR/EN/EXP_SPI_MOSI, and SPI3's (PC10/11/12)
// do not exist on this 48-pin package (see PINOUT_CONNECTORS.TXT).
//
// MOSI is PB15, shareable with a TMC2209 in place of a TMC5160: the TMC2209
// needs only its UART pin beyond STEP/DIR/EN, and the two chips are never
// populated together on the same expansion board.
#define EXP_SPI_CS_PIN    GPIO_PIN_2   // PA2
#define EXP_SPI_CS_PORT   GPIOA
#define EXP_SPI_SCK_PIN   GPIO_PIN_2   // PB2
#define EXP_SPI_SCK_PORT  GPIOB
#define EXP_SPI_MISO_PIN  GPIO_PIN_8   // PB8
#define EXP_I2C2_SCL_PORT GPIOB
#define EXP_I2C2_SCL_PIN  GPIO_PIN_10  // PB10 - bit-banged, see firmware_expansion_i2c.c's own note on why
#define EXP_I2C2_SDA_PORT GPIOB
#define EXP_I2C2_SDA_PIN  GPIO_PIN_11  // PB11 - bit-banged, see firmware_expansion_i2c.c's own note on why
#define EXP_SPI_MISO_PORT GPIOB
#define EXP_SPI_MOSI_PIN  GPIO_PIN_15  // PB15
#define EXP_SPI_MOSI_PORT GPIOB

// Expansion driver interface (CONN_EXPANSION pins 5/6/15) - STEP/DIR/EN for
// whatever stepper driver (TMC2209 or TMC5160A) is populated on the
// expansion board, universal to either per PINOUT_CONNECTORS.TXT. Existed
// as real hardware pins since the connector's own design, but had no
// #define here until TOOL_CRIMPING_ACTUATOR (doc #12) became the first
// tool actually driving a motor through the expansion board's own driver
// instead of the onboard one - previously mentioned only in a comment
// (and briefly, incorrectly, as "EXP_PWM" - there is no dedicated PWM
// signal on this connector, confirmed against the same pinout doc).
#define EXP_TMC_STEP_PIN  GPIO_PIN_12  // PB12
#define EXP_TMC_STEP_PORT GPIOB
#define EXP_TMC_DIR_PIN   GPIO_PIN_13  // PB13
#define EXP_TMC_DIR_PORT  GPIOB
#define EXP_TMC_EN_PIN    GPIO_PIN_14  // PB14
#define EXP_TMC_EN_PORT   GPIOB

// TMC_DIAG0 - combined stall/fault diagnostic line shared by the onboard
// TMC2209 (U6 DIAG) and the driver on the expansion connector, through a
// common-cathode dual diode (D4, MMBD4148CC) and an external 10K
// pull-down (R50). Diode-OR rather than a direct tie because the TMC2209
// DIAG output is push-pull: two outputs tied together could fight and
// damage a driver. Active-HIGH as a result, the opposite of a lone
// open-drain TMC5160 DIAG0.
// A TMC5160 on the expansion connector needs GCONF.diag0_int_pushpull = 1,
// otherwise its stall never registers here. This firmware cannot set that
// bit (the expansion SPI bus is a generic passthrough, 0x180/0x181): the
// host or the expansion board must.
// Uses PC15, an EXTI-capable pin; nothing else uses bit 15 of SYSCFG_EXTICR
// (see PINOUT.TXT).
#define TMC_DIAG0_PIN  GPIO_PIN_15  // PC15 (was EXP_GPIO2)
#define TMC_DIAG0_PORT GPIOC

// DIAGNOSTIC PIN (Visual indicator / Heartbeat)
#define LED_DIAG_PIN    GPIO_PIN_15 // PA15 -> Diagnostic digital output
#define LED_DIAG_PORT   GPIOA

// Fixed dedicated peripherals (T12 soldering / 3D hotend block)
#define T12_PWM_PIN     GPIO_PIN_1  // PA1 -> Soldering iron PWM / Extruder heater
#define T12_PWM_PORT    GPIOA
#define T12_ADC_PIN     GPIO_PIN_0  // PA0 -> ADC Channel 0 (T12 thermocouple / NTC 100k)

// DYNAMIC CENTRAL PIN SWITCHING MATRIX (PORT B)
#define STEP_PIN         GPIO_PIN_3  // PB3 - Motor mode: Pulse output
#define STEP_PORT        GPIOB
#define TCRT_D0_DIG_PIN  GPIO_PIN_3  // PB3 - Vacuum pickup sensor mode: LM393 digital input
#define TOUCH_IN_PIN     GPIO_PIN_3  // PB3 - Probe mode: EXTI3 impact input

#define DIR_PIN          GPIO_PIN_5  // PB5 - Motor mode: Direction output
#define DIR_PORT         GPIOB
// NOTE: PB5 is not used in AOI Inspection mode. That tool's light is the LED
// ring on CONN_LED2 (see ring_pixels[] and Update_AllLEDs_SPI_DMA).

#define TMC_ENN_PIN      GPIO_PIN_6  // PB6 - Stepper driver enable (Active Low)
#define TMC_ENN_PORT     GPIOB
#define DRILL_BRAKE_PIN GPIO_PIN_9 // PB9 - Drill's own BrakeIN line on CONN_DRILL, independent from the stepper tools' enable
#define DRILL_BRAKE_PORT GPIOB
#define LASER_SAFETY_PIN GPIO_PIN_6  // PB6 - Laser mode: Physical safety interlock

// SPECIAL REASSIGNED PERIPHERALS 
#define LED_SPI_MOSI_PIN  GPIO_PIN_7  // PA7 -> SPI1_MOSI (AF5) for the status/ring LED chain (see MX_SPI1_Init) - not drill or laser PWM, despite the pin's original silkscreen/net intent; that PWM moved to PA8/TIM1_CH1 once this pin took over SPI1_MOSI duty
#define DRILL_PWM_PORT GPIOA
#define LASER_PWM_PORT   GPIOA

#define TCRT_A0_ADC_PIN  GPIO_PIN_0  // PB0 -> Sensor mode: Analog ADC Channel 11 input
#define TCRT_A0_ADC_PORT GPIOB

// Smart drill tool-head auxiliary wiring
#define DRILL_FGIN_PIN   GPIO_PIN_3  // PA3  -> Tachometer input (EXTI3)

// Hotend cooling fan (3D printer mode only) - CONN_FAN1, uses 2
// free pins PA5/PA6. Distinct from the layer fan (PA7/PA3): this one cools the
// hotend/heatsink itself, the layer fan cools the printed part.
#define HOTEND_FAN_PWM_PIN   GPIO_PIN_5  // PA5 -> TIM2_CH1 (AF1)
#define HOTEND_FAN_PWM_PORT  GPIOA
#define HOTEND_FAN_FG_PIN    GPIO_PIN_6  // PA6 -> Tachometer input (EXTI6)
#define HOTEND_FAN_FG_PORT   GPIOA
#define DRILL_FGIN_PORT  GPIOA
#define DRILL_FRIN_PIN   GPIO_PIN_4  // PA4 -> BL4260 rotation direction output
#define DRILL_FRIN_PORT  GPIOA

// =============================================================================
// 2. ENUMERATIONS AND CONTROL STRUCTURES
// =============================================================================
typedef enum {
    TOOL_SOLDERING_IRON           = 0,  
    TOOL_PASTE_DISPENSER  = 1,  
    TOOL_LIQUID_DISPENSER    = 2,  
    TOOL_SCREWDRIVER     = 3,  
    TOOL_VACUUM_PICKUP            = 4,  
    TOOL_DRILL            = 5,  
    TOOL_GRIPPER_GIMBAL     = 6,  
    TOOL_GRIPPER_NEMA       = 7,  
    TOOL_AOI_INSPECTION     = 8,  
    TOOL_LASER_ENGRAVER     = 9,  
    TOOL_3D_PRINTER       = 10, 
    TOOL_SCAN_PROBE      = 11, 
    // 15-tool expansion - IDs follow that
    // document's own tool numbering for traceability. Document tools #2
    // (Metrology Touch Probe) and #9 (Micro-Spindle) are explicitly
    // identical to TOOL_SCAN_PROBE and TOOL_DRILL respectively - no new ID,
    // they're just alternate physical end-effectors using the exact same
    // firmware profile, so they don't appear here at all.
    TOOL_SMT_PICKPLACE      = 12, // doc #1
    TOOL_ELECTROMAGNET      = 13, // doc #3
    TOOL_SPOT_WELDER        = 14, // doc #4
    TOOL_CONFORMAL_COATING  = 15, // doc #5
    TOOL_VACUUM_GRIPPER_LG  = 16, // doc #6
    TOOL_FLYING_PROBE       = 17, // doc #7  - ADS1115 (0x48-0x4B)
    TOOL_UV_CURING          = 18, // doc #8
    TOOL_HOTAIR_REWORK      = 19, // doc #10
    TOOL_PRESSFIT_INSERTER  = 20, // doc #11
    TOOL_CRIMPING_ACTUATOR  = 21, // doc #12 - expansion driver (TMC2209/5160A)
    TOOL_THERMAL_INSPECTION = 22, // doc #13 - MLX90640 (0x33)
    TOOL_PASTE_JETTING      = 23, // doc #14
    TOOL_ULTRASONIC_WELDER  = 24, // doc #15
    // The 5-bit ID scheme can read 0-31, but only 0-24 map to a real tool
    // head today. 25-31 (no jumpers matching any assigned tool - most
    // commonly unsoldered jumpers, a wiring fault, or simply an ID not yet
    // assigned to a tool) get their own explicit, deliberately inert state
    // here rather than silently mapping to any real tool - falling through
    // to an existing tool profile would make no sense: it isn't that tool,
    // and every other subsystem in the firmware would still treat it as if
    // it were one. This also leaves headroom for
    // up to 6 more tool heads to be added later without another ID-scheme
    // change (25-30 - 31 stays reserved for FREE CONFIGURATION).
    TOOL_INVALID         = 25
} ToolMode_t;

// Snapshot of parameters worth surviving a power loss, written to the
// FM24CL64B F-RAM - see SavedState_Load()/SavedState_MaybeSave() in
// section 14. __attribute__((packed)) keeps the size predictable (no
// compiler-inserted padding) since this same layout has to match on both
// the write and read side, and the size feeds directly into the checksum
// calculation.
typedef struct __attribute__((packed)) {
    uint32_t magic;              // confirms this F-RAM was actually written by this firmware, not blank/garbage
    uint8_t  struct_version;     // bumped if this layout ever changes, so old/new firmware can tell mismatched saves apart
    uint8_t  active_tool_at_save; // sanity check against the CURRENT active_tool at load time - see the load-time note
    uint16_t solder_setpoint;
    uint16_t printer_nozzle_setpoint;
    uint8_t  drill_speed;
    uint8_t  drill_direction;
    uint8_t  laser_power;
    uint8_t  laser_interlock;
    uint8_t  layer_fan_power;
    uint8_t  hotend_fan_power;
    uint8_t  status_r, status_g, status_b;
    uint8_t  ring_r, ring_g, ring_b, ring_on;
    uint8_t  oled_night_mode;
    uint8_t  had_critical_error; // was system_error_flag set at the moment of the last save, before whatever powered the board off?
    uint8_t  expansion_board_type; // 0=none, 1=basic TMC2209, 2=basic TMC5160A,
                                    // 3=advanced TMC2209+STM32F303CBT6, 4=advanced TMC5160A+STM32F303CBT6,
                                    // 5=basic ADS1115 (sensor only: talks to this chip directly over the
                                    // bit-banged I2C bus, no slave MCU), 6=basic MLX9064x (same direct
                                    // connection, thermal sensor) - see EXPANSION.TXT.
                                    // Set by the host (0x1A0/0x1A1, see CANBUS.TXT), not auto-detected:
                                    // there is no electrical way to sense which variant is plugged in.
    uint8_t  free_tool_selection;  // Only consulted when the ID-jumper reading is
                                    // 0x1F (11111b, all 5 jumpers installed) - see
                                    // Identify_PhysicalTool()'s own id==31 branch.
                                    // 0 = no tool selected
                                    // (same safe/error state as an unrecognized ID
                                    // reading), 1-25 = one of the 25 currently
                                    // supported tool profiles (stored as id+1, not
                                    // the raw 0-24 ToolMode_t value, so 0 can
                                    // unambiguously mean "nothing chosen yet"
                                    // rather than colliding with tool 0, the
                                    // soldering iron). Set via CAN (0x1A2/0x1A3 -
                                    // see CANBUS.TXT), same reasoning as
                                    // expansion_board_type above.
    uint8_t  device_serial_number; // 0-255, default 0. Purely a host-assigned
                                    // label for telling multiple URTC boards
                                    // apart on the same CAN bus - this firmware
                                    // never reads its own value for any decision,
                                    // it's answered purely for a host/Flasher/
                                    // Tester's own bookkeeping. Set via CAN
                                    // (0x1A4/0x1A5 - see CANBUS.TXT), same
                                    // reasoning as free_tool_selection above. See
                                    // EEPROM.TXT section 6 for the full mechanism
                                    // and why this exists (multiple identically-
                                    // configured boards on one bus were otherwise
                                    // indistinguishable from each other).
    uint8_t  mlx_sensor_variant; // MLX_VARIANT_NONE/90640/90641/90642
                                    // (0/1/2/3): the MLX9064x family member populated on a Basic+MLX9064x
                                    // or Advanced expansion board. It serves both the direct sensor path
                                    // (expansion_board_type==6) and the value relayed to the expansion
                                    // slave's REG_MLX_SENSOR_VARIANT at boot (Advanced variants 3-4).
                                    // Set once over CAN (0x1A6/0x1A7, see CANBUS.TXT) like
                                    // expansion_board_type. 0 means no sensor configured, deliberately
                                    // not "assume MLX90640".
    int32_t  solder_spool_position; // Real physical state, not a per-tool
                                    // setpoint - saved with its own current
                                    // value unconditionally (no active_tool
                                    // gate the way solder_setpoint/drill_speed/
                                    // etc. above have), since the spool stays
                                    // wherever it physically is regardless of
                                    // which tool happens to be mounted right
                                    // now. Restored directly on load (like
                                    // expansion_board_type/free_tool_selection
                                    // above) rather than only exposed via
                                    // recovered_state - this is passive
                                    // position tracking, not an actuator
                                    // setpoint that could re-arm something
                                    // hazardous on boot. See CANBUS.TXT 0x132.
    uint8_t  checksum;           // CRC-8 (polynomial 0x07, CRC-8/SMBUS) over every byte above - proportionate for "was this corrupted", not a security boundary the way the OTA update's HMAC is
} SavedState_t;
// The hardware configuration that a host sets once (the expansion board, the free tool, the serial label, the thermal sensor), kept in a record of its own so that a
// change of the layout of SavedState_t (a new SAVEDSTATE_VERSION) does not discard it: the saved state of another version is ignored as a whole, and these four
// values used to go with it, then to be overwritten with zeros by the next save. Written by SavedState_MaybeSave when it changes, read at boot.
typedef struct __attribute__((packed)) {
    uint32_t magic;
    uint8_t  version;
    uint8_t  expansion_board_type;
    uint8_t  free_tool_selection;
    uint8_t  device_serial_number;
    uint8_t  mlx_sensor_variant;
    uint8_t  checksum;           // CRC-8/SMBUS over every byte above
} HardwareConfig_t;
#define HWCONFIG_MAGIC 0x48574346UL   // 'HWCF'
#define HWCONFIG_VERSION 1
#define HWCONFIG_FRAM_ADDR 944        // between the end of the fault recorder (934) and the multinode switch (960); docs/EEPROM.TXT has the map
#define SAVEDSTATE_MAGIC 0x55525443UL // 'URTC' as bytes, arbitrary but distinctive - astronomically unlikely to appear by chance in an uninitialized F-RAM
#define SAVEDSTATE_VERSION 7
// Fixed hardware/firmware identity constant, not a F-RAM field - the same
// for every URTC firmware build, so there's nothing to persist or make
// configurable. 0x03 per EEPROM.TXT section 6's peripheral type
// numbering (0x04-0x05 reserved for expansion-board firmwares, which are
// a different chip - STM32F303CBT6 - running different firmware entirely,
// not something this codebase reports on their behalf).
#define URTC_PERIPHERAL_TYPE 0x03
#define SAVEDSTATE_FRAM_ADDR 0 // lives at the very start of the F-RAM - nothing else uses this chip yet

// -----------------------------------------------------------------------
// "Black box" fault recorder (planned: "sistema de Black Box en la
// F-RAM para registrar los últimos 10s antes de un error") - a small continuously-
// updated RAM ring buffer, flushed to F-RAM ONLY on the rising edge of
// system_error_flag (see firmware_blackbox.c), not written every tick -
// the point is capturing what led UP TO a fault, and a fault condition
// that stays true for a while must not let every later tick overwrite
// the pre-fault window with nothing-but-error samples.
// -----------------------------------------------------------------------
typedef struct __attribute__((packed)) {
    uint32_t tick_ms;            // HAL_GetTick() at capture - absolute, so 2 samples' spacing is exact even across the ring wrap
    uint8_t  active_tool;
    uint16_t current_temperature;
    uint16_t target_temperature;
    uint8_t  flags;              // bit0 endstop_triggered, bit1 system_error_flag (the sample where THIS is first set is the fault trigger itself), bits2-3 thermal_fault_code (thermal_guard.h)
} BlackBoxSample_t; // 10 bytes

// ~150ms x 67 samples =~ 10.0s, matching the requested "last 10s"
// literally rather than a round number picked for its own sake.
#define BLACKBOX_SAMPLES 67

typedef struct __attribute__((packed)) {
    uint32_t magic;
    uint8_t  struct_version;
    uint8_t  sample_count;   // how many of `samples` are real (ramps 0..BLACKBOX_SAMPLES once at boot, then stays there - same pattern as OLED_DrawTempSparkline's own history buffer)
    uint8_t  write_index;    // circular position at the moment of the flush that produced this record
    BlackBoxSample_t samples[BLACKBOX_SAMPLES];
    uint8_t  checksum;       // CRC-8/SMBUS over every byte above (last in the record, like SavedState_t) - proportionate for "was this corrupted", not a security boundary
} BlackBoxRecord_t;
_Static_assert(sizeof(BlackBoxRecord_t) == 678, "BlackBoxRecord_t is exported over CAN as 678 bytes; a change of layout needs a new BLACKBOX_VERSION and docs/CANBUS.TXT");
_Static_assert(offsetof(BlackBoxRecord_t, checksum) == sizeof(BlackBoxRecord_t) - 1, "the checksum is the last byte of the record");
#define BLACKBOX_MAGIC 0x424C4B42UL // 'BLKB' as bytes - distinct from SAVEDSTATE_MAGIC so a reader can't confuse the two regions even if addresses were ever misconfigured
#define BLACKBOX_VERSION 2
#define BLACKBOX_FRAM_ADDR 256 // well past SavedState_t's own ~34 bytes at address 0, generous margin for that struct to grow; ends well under FRAM_SIZE_BYTES (8192) even with BLACKBOX_SAMPLES x 10 bytes added
#define THERMAL_STATS_FRAM_ADDR 192 // lifetime thermal counters (thermal_stats.h, 13 bytes) - between SavedState_t (address 0) and the black box (256)

// Verified exactly 3 bytes with this toolchain (all-uint8_t members need
// no alignment padding), but __attribute__((packed)) makes that
// explicit rather than relying on it being true "by coincidence" -
// cheap insurance against a future compiler/platform silently adding
// padding and breaking the DMA dump's byte-for-byte protocol match.
typedef struct __attribute__((packed)) {
    uint8_t R; uint8_t G; uint8_t B;
} LED_RGB_t;

// Full standard 5x7 alphanumeric character font (no clipping)

// =============================================================================
// Shared peripheral handles and global state - defined once in
// STM32F303CC_main.c, declared extern here since almost every module
// below reads or writes several of these.
// =============================================================================
extern CAN_HandleTypeDef hcan;
extern TIM_HandleTypeDef htim3;
extern TIM_HandleTypeDef htim1;
extern TIM_HandleTypeDef htim2;
extern SPI_HandleTypeDef hspi1;
extern DMA_HandleTypeDef hdma_spi1_tx;
extern I2C_HandleTypeDef hi2c2; // Hardware I2C2 for the OLED+F-RAM (PA9/PA10 - AF4 on these pins is I2C2, not I2C1, confirmed against DS9118)
extern ADC_HandleTypeDef hadc;
extern IWDG_HandleTypeDef hiwdg;

extern volatile ToolMode_t active_tool;
extern SavedState_t recovered_state;
extern uint8_t had_valid_recovered_state;
extern volatile uint8_t expansion_board_type;
extern volatile uint8_t free_tool_selection;
extern volatile uint8_t device_serial_number;
extern volatile uint8_t mlx_sensor_variant;
extern uint8_t raw_id_pin_value;
extern SavedState_t last_saved_state;

extern volatile LED_RGB_t led_state_pixel;
extern volatile LED_RGB_t ring_pixels[8];

extern volatile uint32_t steps_remaining;
extern volatile uint8_t step_pulse_high;
extern volatile uint32_t total_steps_setpoint;
extern volatile int32_t solder_spool_position; // Signed, open-loop accumulation of
                                    // commanded 0x120 steps while TOOL_SOLDERING_IRON
                                    // is active - positive = fed forward (toward the
                                    // iron), negative = net retracted past the last
                                    // reset point. Not a real physical measurement
                                    // (no encoder on this motor) - an estimate that
                                    // assumes every commanded step actually happened,
                                    // the same open-loop assumption every other
                                    // stepper on this board already makes. Reset to
                                    // 0 via 0x131 (see CANBUS.TXT), typically done
                                    // by the operator after loading a fresh spool.
extern volatile uint16_t current_temperature;
extern volatile uint16_t target_temperature;
extern volatile uint16_t sensor_analog_reading;
extern volatile uint8_t sensor_digital_reading;
extern volatile uint8_t drill_speed;
extern volatile uint32_t drill_rpm_pulses;
extern volatile uint32_t drill_actual_rpm;
extern volatile uint8_t layer_fan_duty;
extern volatile uint32_t layer_fan_rpm_pulses;
extern volatile uint32_t layer_fan_actual_rpm;
extern volatile uint8_t system_error_flag;
extern volatile uint8_t system_error_reason; // URTC_ERROR_REASON_* of the latched error, 0 while none (STM32F303CC_main.c); set with RAISE_SYSTEM_ERROR
// Latch the critical error and keep WHY (the first reason wins until the error is lifted); reported in byte 6 of 0x111.
#define RAISE_SYSTEM_ERROR(reason) do { if (!system_error_flag) { system_error_reason = (uint8_t)(reason); } system_error_flag = 1; } while (0)
extern volatile uint8_t thermal_fault_code; // ThermalGuardFault_t of the latched thermal fault, 0 = none (firmware_control_thermal.c)
extern volatile uint8_t last_reset_cause;   // RCC reset-cause bits latched at boot (STM32F303CC_main.c), reported in 0x111 byte 5
extern volatile uint8_t boot_sequence_active;
extern volatile uint8_t can_bus_error_flag;
extern volatile uint8_t laser_power_setpoint;
extern volatile uint32_t laser_last_kick_tick;
extern volatile uint8_t  weld_pulse_active;
extern volatile uint32_t weld_pulse_start_tick;
extern volatile uint16_t weld_pulse_duration_ms;
extern volatile uint32_t drill_last_kick_tick;
extern volatile uint32_t layer_fan_last_kick_tick;
extern volatile uint8_t hotend_fan_duty;
extern volatile uint32_t hotend_fan_rpm_pulses;
extern volatile uint32_t hotend_fan_actual_rpm;
extern volatile uint32_t hotend_fan_last_kick_tick;
extern volatile uint32_t solder_iron_last_kick_tick;
extern volatile uint32_t hotend_heater_last_kick_tick;
extern volatile uint8_t uv_curing_duty;
extern volatile uint32_t uv_curing_last_kick_tick;
extern volatile uint8_t hotair_blower_duty;
extern volatile uint32_t hotair_blower_last_kick_tick;
extern volatile uint8_t aoi_mode;
extern volatile uint16_t aoi_strobe_period;
extern volatile uint8_t aoi_strobe_active;
extern volatile uint32_t aoi_strobe_off_tick;
extern volatile uint8_t oled_night_mode;
extern volatile uint8_t oled_mode_pending_flag;
extern volatile uint8_t oled_night_mode_cmd;
extern volatile uint8_t update_led_ring_flag;
extern volatile uint8_t ring_color_r;
extern volatile uint8_t ring_color_g;
extern volatile uint8_t ring_color_b;
extern volatile uint8_t trigger_aoi_strobe_flag;
extern volatile uint32_t probe_impact_counter;
extern volatile uint8_t endstop_triggered;
extern volatile uint32_t can_led_tick;
extern volatile uint8_t led_host_override_active;
extern volatile uint32_t led_host_override_expire_tick;
extern uint8_t animation_frame; // toggles the tool icon's animation frame - written in main(), read by the render module

#define LED_HOST_OVERRIDE_DURATION_MS 10000
#define LED_FUNCTIONING_WINDOW_MS     1500

// String-building helpers (fully self-contained, declared here since
// they're used throughout the OLED/display module and nowhere else,
// but small enough not to need their own header)
uint8_t append_str(char *dest, const char *src);
uint8_t fmt_uint(char *dest, uint32_t value, uint8_t width);

// Defined in firmware_init_buses.c - called from firmware_oled_driver.c's
// OLED_Init(), which needs I2C2 configured before it can probe the display.
void MX_I2C2_Init(void);

// The current incoming CAN message - populated by HAL_CAN_GetRxMessage in
// the main dispatcher (see firmware_can_dispatch.c) before any per-tool
// handler function is called. Genuinely global, not per-tool state: every
// firmware_can_*.c handler reads these to see what was just received.
extern CAN_RxHeaderTypeDef rxHeader;
extern uint8_t rxData[8];

// Defined in firmware_persistence.c (F-RAM read/write) - declared here
// since firmware_can_global_post.c calls FRAM_WriteBytes directly for the
// 0x192 erase command.
uint8_t FRAM_WriteBytes(uint16_t addr, const uint8_t *data, uint16_t len);
uint8_t FRAM_ReadBytes(uint16_t addr, uint8_t *data, uint16_t len);
uint8_t SavedState_Checksum(const SavedState_t *s);

// MLX9064x capture status - same values as the expansion slave chip's
// own copy (slave_common.h) for consistency, though the two never
// actually need to agree with each other at runtime (a given board has
// either the slave chip's own sensor bus populated, or this board's
// own direct connection, never both at once).
#define MLX_CAPTURE_IDLE      0x00
#define MLX_CAPTURE_BUSY      0x01
#define MLX_CAPTURE_READY     0x02
#define MLX_CAPTURE_ERROR     0xFF

// Which MLX9064x family member is actually populated - same values as
// the expansion slave chip's own copy (slave_common.h) for consistency.
#define MLX_VARIANT_NONE   0x00 // no sensor populated - the safe default; MLX_TriggerCapture and friends deliberately do nothing against this rather than guessing which real sensor might be there
#define MLX_VARIANT_90640 0x01
#define MLX_VARIANT_90641 0x02
#define MLX_VARIANT_90642 0x03

// Same scaling convention as the slave chip's own copy (slave_common.h)
// - REG_MLX_CALIBRATED_CHUNK values are degrees C * 100 (centi-degrees).
#define MLX_TEMP_SCALE 100

#include "can_rx_queue.h"

#if URTC_CAN_RX_QUEUE
// Does in the main loop what the interrupt of the CAN receiver used to do with each frame (URTC_CAN_RX_QUEUE=1; see can_rx_queue.h).
void CanDispatch_Drain(void);
#endif

#include "can_tx_queue.h"

#if URTC_CAN_TX_QUEUE
// Every frame the application sends goes through the transmit queue (URTC_CAN_TX_QUEUE=1; see can_tx_queue.h and firmware_can_tx.c). The two HAL names are redirected here so that
// the handlers do not change: asking for the free mailboxes asks for the room in the queue, and sending puts the frame in the queue. firmware_can_tx.c undoes it to reach the HAL.
HAL_StatusTypeDef CanTx_Submit(CAN_TxHeaderTypeDef *hdr, uint8_t *data, uint32_t *mailbox);
uint32_t CanTx_FreeLevel(void);
void CanTx_Service(void);       // main loop: sends what did not fit in the mailboxes before
uint32_t CanTx_Discard(void);   // after a bus-off: drops what waits in the queue
uint32_t CanTx_Dropped(void);
uint32_t CanTx_Failed(void);
#define HAL_CAN_AddTxMessage(h, hdr, data, mb) CanTx_Submit((hdr), (data), (mb))
#define HAL_CAN_GetTxMailboxesFreeLevel(h) CanTx_FreeLevel()
#endif

#endif // FIRMWARE_COMMON_H
