JuanenRac/URTC/src/F303-master/firmware_render.c

// =============================================================================
// URTC Firmware - OLED rendering: text, icons, splash screen, per-tool display
// Copyright (C) 2026 JuanenRac (Electro Hobby 3D) <electrohobby3d@gmail.com>
// GPL-3.0-or-later - see LICENSE
// =============================================================================
#include "firmware_common.h"
#include "firmware_render.h"
#include "firmware_font.h"
#include "firmware_oled_driver.h"

// FLASH OPTIMIZATION: replaces sprintf() for all OLED text. sprintf/printf's
// format-string parser plus its float-formatting support pulled in roughly
// 2KB of C library code that this firmware never needed the full generality
// of - every call here only ever builds simple "label + padded number" text.
// These two tiny helpers do the same job at a fraction of the size.

// Copies a null-terminated string, returns how many characters were written
// (not counting the terminator) so the caller can chain calls at the right
// offset without needing strlen().
uint8_t append_str(char *dest, const char *src) {
    uint8_t i = 0;
    while (src[i]) { dest[i] = src[i]; i++; }
    return i;
}

// Writes an unsigned integer in decimal, right-aligned and space-padded to
// at least 'width' characters (writes more if the value needs it - never
// truncates). Does NOT null-terminate; the caller terminates once after the
// last piece, same pattern as append_str.
uint8_t fmt_uint(char *dest, uint32_t value, uint8_t width) {
    char tmp[10]; // max uint32_t is 10 digits
    // Every current call site passes a fixed literal (3/4/5), so this
    // isn't reachable today - but width has no relationship to dest's
    // actual capacity otherwise, and the caller's buffer is sized for
    // one OLED line (see OLED_PrintStr's own 21-character note), so
    // capping here protects any future caller that computes width
    // dynamically instead of using a literal.
    if (width > 21) width = 21;
    uint8_t n = 0;
    do {
        tmp[n++] = (char)('0' + (value % 10));
        value /= 10;
    } while (value > 0);
    uint8_t pad = (n < width) ? (width - n) : 0;
    uint8_t pos = 0;
    while (pad-- > 0) dest[pos++] = ' ';
    while (n > 0) dest[pos++] = tmp[--n];
    return pos;
}

void OLED_PrintStr(uint8_t page, uint8_t col, const char* str) {
    OLED_SetCursor(page, col);
    // Builds the whole string's pixel data locally, then sends it in one
    // I2C transaction rather than one transaction per character - each
    // transaction carries full protocol overhead (START, address, control
    // byte, data, STOP), so batching matters for a 15-20 character line.
    // Capped at 21 characters (126 columns): as many as fit in the
    // 128-column frame OLED_WriteData already caps itself at.
    uint8_t line_buf[126];
    uint8_t len = 0;
    while (*str && len < 21) {
        char c = *str++;
        if (c >= 'a' && c <= 'z') c -= 32; // Font5x7 only has glyphs 32-91 (no lowercase):
                                            // without this, "v1.0" or "__DATE__" (e.g. "Jul") would
                                            // come out with blank gaps where each lowercase letter was.
        if (c >= 32 && c <= 95) {
            uint16_t idx = (uint16_t)((c - 32) * 5);
            for (uint8_t i = 0; i < 5; i++) line_buf[len*6 + i] = Font5x7[idx+i];
        } else {
            for (uint8_t i = 0; i < 5; i++) line_buf[len*6 + i] = 0x00;
        }
        line_buf[len*6 + 5] = 0x00; // 1px inter-character spacing
        len++;
    }
    OLED_WriteData(line_buf, len * 6);
}

void OLED_ClearPage(uint8_t page) {
    OLED_SetCursor(page, 0);
    // One 128-byte transaction rather than 8 separate 16-byte ones - same
    // reasoning as OLED_SetCursor's own fix: each transaction carries its
    // own START/address/control/STOP overhead, and OLED_WriteData's own
    // frame buffer already supports the full 128 bytes a page needs in a
    // single call.
    static const uint8_t vacio[128] = {0};
    OLED_WriteData((uint8_t *)vacio, 128);
}

void OLED_DrawHorizontalBar(uint8_t page, uint8_t col_start, uint8_t max_width, uint8_t percent) {
    if (percent > 100) percent = 100;
    if (max_width > 128) max_width = 128; // matches OLED_WriteData's own frame buffer cap
    // Every current call site uses col_start=5, max_width=85 (well within
    // the 128-column display), so this isn't reachable today - but
    // nothing else here checks the combination, and a future caller with
    // a different col_start could push filled pixels past column 127,
    // wrapping onto the start of the same page instead of simply running
    // off the edge.
    if (col_start < 128 && (uint16_t)col_start + max_width > 128) {
        max_width = 128 - col_start;
    }
    uint8_t filled_pixels = (uint8_t)((max_width * percent) / 100);

    // Builds the whole bar locally and sends it in one I2C transaction,
    // rather than one transaction per column - each carries full protocol
    // overhead, and this loop runs on the same thread as the 20ms PID loop.
    uint8_t bar_buffer[128];
    for(uint8_t i = 0; i < max_width; i++) {
        if(i == 0 || i == (max_width - 1)) {
            bar_buffer[i] = 0x7E;
        } else if(i <= filled_pixels) {
            bar_buffer[i] = 0x5E;
        } else {
            bar_buffer[i] = 0x42;
        }
    }

    OLED_SetCursor(page, col_start);
    OLED_WriteData(bar_buffer, max_width);
}

// Rolling temperature trend sparkline, confined to ONE 8px-tall page: page 4,
// the only free page on the soldering iron's tool screen (no
// OLED_SetCursor(4, ...) call exists in this file). A coarse trend line
// (rising/falling/flat); the precise number is the text on page 5.
//
// Call it every render tick (Render_ToolScreen does, every 150ms) with the
// CURRENT value; it keeps one history sample every ~2s, so the trend spans
// about a minute (SPARK_SAMPLES x SPARK_SAMPLE_PERIOD_MS).
#define SPARK_SAMPLES 32
#define SPARK_SAMPLE_PERIOD_MS 2000

void OLED_DrawTempSparkline(uint8_t page, uint8_t col_start, uint8_t width, uint16_t current_value, uint16_t min_value, uint16_t max_value) {
    static uint16_t history[SPARK_SAMPLES] = {0};
    static uint8_t sample_count = 0;   // how many of `history` are real samples yet (ramps up to SPARK_SAMPLES once, then stays there)
    static uint8_t write_index = 0;    // next slot to overwrite - circular
    static uint32_t last_sample_tick = 0;

    uint32_t now = HAL_GetTick();
    if (now - last_sample_tick >= SPARK_SAMPLE_PERIOD_MS || sample_count == 0) {
        last_sample_tick = now;
        history[write_index] = current_value;
        write_index = (uint8_t)((write_index + 1) % SPARK_SAMPLES);
        if (sample_count < SPARK_SAMPLES) sample_count++;
    }

    if (width == 0 || max_value <= min_value) return;
    if (width > 128) width = 128;
    if (col_start < 128 && (uint16_t)col_start + width > 128) {
        width = 128 - col_start;
    }

    uint8_t col_buffer[128];
    for (uint8_t col = 0; col < width; col++) {
        // Oldest sample at the left edge, newest at the right - same
        // left-to-right "time flows forward" convention as URTC-TESTER's
        // own live graph (HYDRA-UMC-SUITE/URTC-TESTER's _create_live_graph),
        // so an operator reading either one doesn't have to remember two
        // different conventions.
        uint8_t sample_idx = (uint8_t)((col * sample_count) / (width > 1 ? width : 1));
        if (sample_idx >= sample_count) sample_idx = sample_count > 0 ? sample_count - 1 : 0;
        // history is circular - the OLDEST valid sample is at write_index
        // once the buffer has wrapped (sample_count == SPARK_SAMPLES),
        // otherwise the oldest is simply history[0] (nothing's wrapped yet).
        uint8_t real_idx;
        if (sample_count < SPARK_SAMPLES) {
            real_idx = sample_idx;
        } else {
            real_idx = (write_index + sample_idx) % SPARK_SAMPLES;
        }

        uint16_t v = (sample_count > 0) ? history[real_idx] : current_value;
        if (v < min_value) v = min_value;
        if (v > max_value) v = max_value;
        // Map value to a row 0-7 within this one page (7 = bottom/coldest,
        // 0 = top/hottest - a taller bar-like column reads as "more" the
        // same way OLED_DrawHorizontalBar's own filled columns do).
        uint8_t row_from_bottom = (uint8_t)(((uint32_t)(v - min_value) * 7) / (max_value - min_value));
        // Bits are LSB-first from the page's own top row (SSD1306 page-
        // addressing convention, same bit order OLED_DrawHorizontalBar's
        // own 0x7E/0x5E/0x42 patterns above already rely on) - a filled
        // column from the bottom up to row_from_bottom.
        uint8_t byte = 0;
        for (uint8_t bit = 7; bit >= (7 - row_from_bottom); bit--) {
            byte |= (1 << bit);
            if (bit == 0) break; // uint8_t bit would wrap past 0 instead of going negative - a real bug this guards against
        }
        col_buffer[col] = byte;
    }

    OLED_SetCursor(page, col_start);
    OLED_WriteData(col_buffer, width);
}

// 16x16 monochrome icon table, one per each of the 25 currently-assigned
// tools.
// SSD1306 format: 2 pages (top/bottom) x 16 columns, bit0 = the page's
// top row (same convention as Font5x7). Generated from simple silhouettes
// recognizable at this very small size.
static const uint8_t ToolIcons[25][4][2][16] = {
    // 0 TOOL_SOLDERING_IRON
    {
       {{0x00,0x00,0x00,0x00,0x00,0x00,0x00,0x80,0xC0,0xE0,0xF0,0xF8,0x7C,0x3A,0x14,0x08}, {0x00,0x80,0x60,0x18,0x04,0x0E,0x1F,0x0F,0x07,0x03,0x01,0x00,0x00,0x00,0x00,0x00}},
       {{0x00,0x00,0x00,0x00,0x00,0x00,0x00,0x80,0xC0,0xE0,0xF4,0xFA,0x7D,0x38,0x14,0x08}, {0x00,0x80,0x60,0x18,0x04,0x0E,0x1F,0x0F,0x07,0x03,0x01,0x00,0x00,0x00,0x00,0x00}},
       {{0x00,0x00,0x00,0x00,0x00,0x00,0x00,0x80,0xC0,0xE0,0xF4,0xFA,0x7D,0x38,0x11,0x06}, {0x00,0x80,0x60,0x18,0x04,0x0E,0x1F,0x0F,0x07,0x03,0x01,0x00,0x00,0x00,0x00,0x00}},
       {{0x00,0x00,0x00,0x00,0x00,0x00,0x00,0x80,0xC0,0xE0,0xF0,0xF8,0x7C,0x3A,0x11,0x06}, {0x00,0x80,0x60,0x18,0x04,0x0E,0x1F,0x0F,0x07,0x03,0x01,0x00,0x00,0x00,0x00,0x00}}
    },
    // 1 TOOL_PASTE_DISPENSER
    {
       {{0x00,0x00,0x00,0x00,0xF8,0x09,0x09,0x0F,0x0F,0x09,0x09,0xF8,0x00,0x00,0x00,0x00}, {0x00,0x00,0x00,0x00,0x03,0x02,0xCE,0xFE,0xFE,0xCE,0x02,0x03,0x00,0x00,0x00,0x00}},
       {{0x00,0x00,0x00,0x00,0xF8,0x0A,0x0A,0x0E,0x0F,0x09,0x09,0xF8,0x00,0x00,0x00,0x00}, {0x00,0x00,0x00,0x00,0x03,0xE2,0xEE,0xFE,0xFE,0xCE,0x02,0x03,0x00,0x00,0x00,0x00}},
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
    {0x00,0x00,0x00,0x00,0x00,0x00,0x00,0x00,0x00,0x00,0x00,0x00,0x00,0x00,0x00,0x00,0x00,0x00,0x00,0x00,0x1F,0x1F,0x1F,0x1F,0x1F,0x1F,0x1F,0x1F,0x1F,0x1F,0x1F,0x1F,0x1F,0x1F,0x1F,0x00,0x00,0x00,0x1F,0x1F,0x1F,0x00,0x00,0x00,0x00,0x00,0x00,0x00,0x00,0x00,0x1F,0x1F,0x1F,0x00,0x00,0x00,0x1F,0x1F,0x1F,0x00,0x00,0x00,0x00,0x00,0x00,0x00,0x00,0x00,0x1F,0x1F,0x1F,0x00,0x00,0x00,0x00,0x00,0x00,0x1F,0x1F,0x1F,0x1F,0x1F,0x1F,0x1F,0x1F,0x1F,0x00,0x00,0x00,0x00,0x00,0x00,0x1F,0x1F,0x1F,0x00,0x00,0x00,0x00,0x00,0x00,0x00,0x00,0x00,0x1F,0x1F,0x1F,0x00,0x00,0x00,0x00,0x00,0x00,0x00,0x00,0x00,0x00,0x00,0x00,0x00,0x00,0x00,0x00,0x00,0x00,0x00,0x00,0x00},
};

// Draws the ANIMATED 16x16 icon (4 frames, cycled via 'animation_frame')
// of the active tool in the top-right corner of the white area
// (pages 5-6, column 108), without overwriting the telemetry text that
// always lives starting at column 5.
void OLED_DrawToolIcon(uint8_t tool) {
    // ToolIcons[] has bitmap art for all 25 currently-assigned tools
    // (indices 0-24) - anything above TOOL_ULTRASONIC_WELDER (an
    // unassigned ID, 25-31) falls back to the soldering iron's icon
    // rather than reading out of bounds, same defensive reasoning as
    // before, just with the real boundary now that art exists for the
    // full 13-tool expansion.
    if (tool > TOOL_ULTRASONIC_WELDER) tool = TOOL_SOLDERING_IRON;
    uint8_t buf[16];

    memcpy(buf, ToolIcons[tool][animation_frame][0], 16);
    OLED_SetCursor(5, 108);
    OLED_WriteData(buf, 16);

    memcpy(buf, ToolIcons[tool][animation_frame][1], 16);
    OLED_SetCursor(6, 108);
    OLED_WriteData(buf, 16);
}

// Top yellow strip (pages 0-1, physical rows 0-15 of the two-tone panel).
// Page 0: CAN activity icon (blinks ~200ms after each RX) + English
// status message. Page 1: live "hero" variable depending on the active
// tool (RPM, temperature, power...). Called on every refresh, even
// during a critical error, so the operator keeps seeing live data.
void OLED_Render_YellowStrip(void) {
    uint8_t buf8[8];
    if (HAL_GetTick() - can_led_tick < 200) {
        memcpy(buf8, CANIcon, 8);
    } else {
        memset(buf8, 0, 8);
    }
    OLED_SetCursor(0, 0);
    OLED_WriteData(buf8, 8);

    const char* status_text;
    switch (active_tool) {
        case TOOL_SOLDERING_IRON:
            status_text = (target_temperature > 0 && current_temperature < target_temperature) ? "HEATING...   " : "READY        ";
            break;
        case TOOL_PASTE_DISPENSER:
        case TOOL_LIQUID_DISPENSER:
            status_text = (steps_remaining > 0) ? "DISPENSING   " : "READY        ";
            break;
        case TOOL_SCREWDRIVER:
            status_text = (steps_remaining > 0) ? "DRIVING      " : "READY        ";
            break;
        case TOOL_SMT_PICKPLACE:
            status_text = (steps_remaining > 0) ? "ROTATING     " : "READY        ";
            break;
        case TOOL_VACUUM_PICKUP:
            status_text = sensor_digital_reading ? "PART PICKED  " : "SEARCHING    ";
            break;
        case TOOL_DRILL:
            status_text = (drill_speed > 0) ? "DRILLING     " : "IDLE         ";
            break;
        case TOOL_GRIPPER_GIMBAL:
        case TOOL_GRIPPER_NEMA:
        case TOOL_VACUUM_GRIPPER_LG:
            status_text = (steps_remaining > 0) ? "GRIPPING     " : "READY        ";
            break;
        case TOOL_AOI_INSPECTION:
            status_text = (aoi_mode == 0x02) ? "SCANNING     " : (aoi_mode == 0x01) ? "LIGHT ON     " : "STANDBY      ";
            break;
        case TOOL_LASER_ENGRAVER:
            status_text = (laser_power_setpoint > 0) ? "ENGRAVING    " : "STANDBY      ";
            break;
        case TOOL_3D_PRINTER:
            status_text = (target_temperature > 0 && current_temperature < target_temperature) ? "HEATING...   " :
                         (steps_remaining > 0) ? "PRINTING     " : "READY        ";
            break;
        case TOOL_SCAN_PROBE:
            status_text = "ARMED        ";
            break;
        default:
            status_text = "STANDBY      ";
            break;
    }
    OLED_PrintStr(0, 10, status_text);

    char hero[24];
    uint8_t hp;
    switch (active_tool) {
        case TOOL_SOLDERING_IRON:
            hp = append_str(hero, "TEMP: ");
            hp += fmt_uint(hero+hp, current_temperature, 3);
            hp += append_str(hero+hp, " C        ");
            hero[hp] = 0;
            break;
        case TOOL_DRILL:
            hp = append_str(hero, "RPM: ");
            hp += fmt_uint(hero+hp, drill_actual_rpm, 5);
            hp += append_str(hero+hp, "          ");
            hero[hp] = 0;
            break;
        case TOOL_LASER_ENGRAVER:
            hp = append_str(hero, "LASER PWR: ");
            hp += fmt_uint(hero+hp, ((uint32_t)laser_power_setpoint * 100u) / 255u, 3);
            hp += append_str(hero+hp, " %     ");
            hero[hp] = 0;
            break;
        case TOOL_3D_PRINTER:
            hp = append_str(hero, "HOTEND: ");
            hp += fmt_uint(hero+hp, current_temperature, 3);
            hp += append_str(hero+hp, " C      ");
            hero[hp] = 0;
            break;
        case TOOL_VACUUM_PICKUP:
            hp = append_str(hero, "VACUUM: ");
            hp += fmt_uint(hero+hp, sensor_analog_reading, 4);
            hp += append_str(hero+hp, "       ");
            hero[hp] = 0;
            break;
        case TOOL_AOI_INSPECTION:
            hp = append_str(hero, "STROBE: ");
            hp += fmt_uint(hero+hp, aoi_strobe_period, 4);
            hp += append_str(hero+hp, "       ");
            hero[hp] = 0;
            break;
        case TOOL_SCAN_PROBE:
            hp = append_str(hero, "HITS: ");
            // Display-only clamp: probe_impact_counter is a uint32_t with no
            // cap anywhere. At 10 digits, "HITS: " (6) + 10 + the 9 trailing
            // spaces below = 25 bytes into this 24-byte buffer - writing the
            // null terminator out of bounds. The real counter is untouched.
            hp += fmt_uint(hero+hp, (probe_impact_counter > 99999) ? 99999 : probe_impact_counter, 5);
            hp += append_str(hero+hp, "         ");
            hero[hp] = 0;
            break;
        default:
            hp = append_str(hero, "STEPS: ");
            hp += fmt_uint(hero+hp, (steps_remaining > 99999) ? 99999 : steps_remaining, 5);
            hp += append_str(hero+hp, "        ");
            hero[hp] = 0;
            break;
    }
    OLED_PrintStr(1, 0, hero);
}

// JuanenBOT boot logo + emblem + "U R T C", 128x40 (pages 0-4).
// Simple 4-frame robot-arm silhouette (base + articulated forearm + small
// gripper), animated during the splash screen (page 5, between the logo
// above and the version/date text below). Purely geometric/original -
// not based on any specific existing robot design.
// 4-frame animated JuanenBOT face (antenna wobble, blinking eyes, talking
// mouth) alongside the "JuanenBOT" wordmark, both living entirely in the
// white area of the OLED (below the yellow strip) - simple geometric shapes
// for the face, and the same "JuanenBOT" typography already used elsewhere
// in this file, just re-cropped and repositioned. 5 pages x 128 columns per
// frame, matching this screen's white region exactly (pages 2-6).
const uint8_t SplashFace[4][5][128] = {
    { // frame 0
        {0x00,0x00,0x00,0x00,0x00,0x00,0x00,0x00,0x00,0x00,0x00,0x00,0x00,0x00,0x00,0x00,0x00,0x00,0x00,0x0F,0x7F,0x7F,0x0F,0x00,0x00,0x00,0x00,0x00,0x00,0x00,0x00,0x00,0x00,0x00,0x00,0x00,0x00,0x00,0x00,0x00,0x00,0x00,0x00,0x00,0x00,0x00,0x00,0x00,0x00,0x00,0x00,0x00,0x00,0x00,0x00,0x00,0x00,0x00,0x00,0x00,0x00,0x00,0x00,0x00,0x00,0x00,0x00,0x00,0x00,0x00,0x00,0x00,0x00,0x00,0x00,0x00,0x00,0x00,0x00,0x00,0x00,0x00,0x00,0x00,0x00,0x00,0x00,0x00,0x00,0x00,0x00,0x00,0x00,0x00,0x00,0x00,0x00,0x00,0x00,0x00,0x00,0x00,0x00,0x00,0x00,0x00,0x00,0x00,0x00,0x00,0x00,0x00,0x00,0x00,0x00,0x00,0x00,0x00,0x00,0x00,0x00,0x00,0x00,0x00,0x00,0x00,0x00,0x00},
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
        {0x00,0x00,0x00,0x00,0x00,0x00,0xFF,0xFF,0xFF,0xE0,0xE0,0xE0,0xE3,0xE3,0xE3,0xE3,0xE3,0xE3,0xE3,0xE3,0xE3,0xE3,0xE3,0xE3,0xE3,0xE3,0xE3,0xE3,0xE3,0xE3,0xE0,0xE0,0xE0,0xFF,0xFF,0xFF,0x00,0x00,0x00,0x00,0x00,0x00,0x00,0x00,0x0F,0x0F,0x0C,0x0C,0x0F,0x0F,0x07,0x00,0x07,0x0F,0x0F,0x0C,0x04,0x0F,0x0F,0x0F,0x00,0x00,0x07,0x0F,0x0F,0x0C,0x0C,0x04,0x0F,0x0F,0x0F,0x0F,0x0F,0x0F,0x00,0x00,0x0F,0x0F,0x0F,0x00,0x00,0x07,0x0F,0x0F,0x0C,0x0C,0x0F,0x0F,0x07,0x00,0x0F,0x0F,0x0F,0x00,0x00,0x0F,0x0F,0x0F,0x00,0x00,0x0F,0x0F,0x0F,0x0C,0x0C,0x0F,0x0F,0x07,0x00,0x00,0x07,0x0F,0x0F,0x0C,0x0C,0x0F,0x0F,0x07,0x00,0x00,0x00,0x0F,0x0F,0x0F,0x00,0x00,0x00,0x00},
    },
};;


void Render_SplashScreen(uint8_t face_frame) {
    uint8_t buf[128];
    for(uint8_t p=0; p<8; p++) OLED_ClearPage(p);

    // Yellow strip (pages 0-1, 16px): URTC big and centered, firmware
    // version smaller alongside it - both baked into one bitmap so they sit
    // together cleanly rather than as separate small OLED_PrintStr calls.
    for (uint8_t p = 0; p < 2; p++) {
        memcpy(buf, SplashYellowText[p], 128);
        OLED_SetCursor(p, 0);
        OLED_WriteData(buf, 128);
    }

    // White area (pages 2-6, 40px): animated JuanenBOT face on the left,
    // the "JuanenBOT" wordmark on the right - both live entirely within the
    // white region now. Page 7 is left blank as a small bottom margin.
    if (face_frame > 3) face_frame = 0;
    for (uint8_t p = 0; p < 5; p++) {
        memcpy(buf, SplashFace[face_frame][p], 128);
        OLED_SetCursor(p + 2, 0);
        OLED_WriteData(buf, 128);
    }
}

void Process_OLED_NightModeChange(void) {
    oled_mode_pending_flag = 0;
    oled_night_mode = oled_night_mode_cmd;
    if (oled_night_mode == 0x01) {
        // Explicitly wakes the display (0xAF) before setting contrast -
        // contrast alone has no effect if the display is currently asleep
        // (put there via 0x0F, which sends only 0xAE). Harmless when
        // already on; the SSD1306 tolerates a redundant 0xAF.
        OLED_WriteCmd(0xAF);
        OLED_WriteCmd(0x81); OLED_WriteCmd(0x0F); 
    }
    else if (oled_night_mode == 0x0F) {
        OLED_WriteCmd(0xAE); 
    }
    else {
        OLED_WriteCmd(0xAE);
        OLED_WriteCmd(0x81); OLED_WriteCmd(0xCF); 
        OLED_WriteCmd(0xAF); 
    }
}

void Render_ToolScreen(void) {
    char txt[24];

    // Dedicated path for "no recognized tool head" (IDs 12-15) - checked
    // before the generic error message and before the normal yellow strip,
    // since there's no live CAN/tool data to show for this state, and it
    // deserves its own clear identity rather than looking like a generic
    // fault on a tool that IS actually connected.
    if (active_tool == TOOL_INVALID) {
        // Yellow strip (pages 0-1): just the big "CHECK ID JUMPERS" text,
        // filling the strip - dropped the "URTC - NO TOOL" line per feedback.
        for (uint8_t p = 0; p < 2; p++) {
            uint8_t ybuf[128];
            memcpy(ybuf, CheckIdJumpersText[p], 128);
            OLED_SetCursor(p, 0);
            OLED_WriteData(ybuf, 128);
        }
        for (uint8_t page = 2; page < 8; page++) OLED_ClearPage(page);
        // White area: nothing but the big blinking ERROR wordmark. Blink:
        // alternate on/off using the same animation_frame the tool icons
        // use (0-3) - checking evenness keeps a clean on/off blink (2 frames
        // on, 2 frames off, ~900ms per half-cycle) rather than a 3-on/1-off skew.
        for (uint8_t page = 2; page <= 6; page++) {
            uint8_t buf[128];
            if (animation_frame % 2 == 0) {
                memcpy(buf, ErrorText[page - 2], 128);
            } else {
                memset(buf, 0, 128);
            }
            OLED_SetCursor(page, 0);
            OLED_WriteData(buf, 128);
        }
        OLED_PrintStr(7, 4, "CHECK ID JUMPERS");
        return;
    }

    OLED_Render_YellowStrip(); // yellow strip (CAN + hero) always refreshes

    if (system_error_flag) {
        OLED_PrintStr(2, 10, "[ CRITICAL ERROR ]");
        OLED_PrintStr(3, 10, " SYSTEM BLOCKED ");
        return;
    }
    
    switch(active_tool) {
        case TOOL_SOLDERING_IRON:           OLED_PrintStr(2, 16, "T12 SOLDER IRON"); break;
        case TOOL_PASTE_DISPENSER:  OLED_PrintStr(2, 16, "PASTE DISPENSER"); break;
        case TOOL_LIQUID_DISPENSER:    OLED_PrintStr(2, 16, "LIQUID DISPENSR"); break;
        case TOOL_SCREWDRIVER:     OLED_PrintStr(2, 16, "SCREWDRIVER    "); break;
        case TOOL_VACUUM_PICKUP:            OLED_PrintStr(2, 16, "VACUUM PICKUP  "); break;
        case TOOL_DRILL:            OLED_PrintStr(2, 16, "DRILL BL4260   "); break;
        case TOOL_GRIPPER_GIMBAL:     OLED_PrintStr(2, 16, "GRIPPER GIMBAL "); break;
        case TOOL_GRIPPER_NEMA:       OLED_PrintStr(2, 16, "GRIPPER NEMA 14"); break;
        case TOOL_VACUUM_GRIPPER_LG:  OLED_PrintStr(2, 16, "VACUUM GRIP LG "); break;
        case TOOL_SMT_PICKPLACE:      OLED_PrintStr(2, 16, "SMT PICK&PLACE "); break;
        case TOOL_AOI_INSPECTION:     OLED_PrintStr(2, 16, "AOI INSPECTION "); break;
        case TOOL_LASER_ENGRAVER:     OLED_PrintStr(2, 16, "LASER DIODE 10W"); break;
        case TOOL_3D_PRINTER:       OLED_PrintStr(2, 16, "3D PRINTER  V4 "); break;
        case TOOL_SCAN_PROBE:      OLED_PrintStr(2, 16, "SCAN PROBE     "); break;
        case TOOL_ELECTROMAGNET:      OLED_PrintStr(2, 16, "ELECTROMAGNET  "); break;
        case TOOL_SPOT_WELDER:         OLED_PrintStr(2, 16, "SPOT WELDER    "); break;
        case TOOL_CONFORMAL_COATING:   OLED_PrintStr(2, 16, "CONFORMAL COAT "); break;
        case TOOL_FLYING_PROBE:        OLED_PrintStr(2, 16, "FLYING PROBE   "); break;
        case TOOL_UV_CURING:           OLED_PrintStr(2, 16, "UV CURING      "); break;
        case TOOL_HOTAIR_REWORK:       OLED_PrintStr(2, 16, "HOT AIR REWORK "); break;
        case TOOL_PRESSFIT_INSERTER:   OLED_PrintStr(2, 16, "PRESS-FIT INSRT"); break;
        case TOOL_CRIMPING_ACTUATOR:   OLED_PrintStr(2, 16, "CRIMPING ACTUAT"); break;
        case TOOL_THERMAL_INSPECTION:  OLED_PrintStr(2, 16, "THERMAL INSPECT"); break;
        case TOOL_PASTE_JETTING:       OLED_PrintStr(2, 16, "PASTE JETTING  "); break;
        case TOOL_ULTRASONIC_WELDER:   OLED_PrintStr(2, 16, "ULTRASONIC WELD"); break;
        default: break; // TOOL_INVALID never reaches here - caught by the early return above
    }
    
    OLED_PrintStr(3, 0, "--------------------");
    
    uint8_t tp;
    switch(active_tool) {
        case TOOL_SOLDERING_IRON: {
            // Same defensive display-only clamp as the 3D printer's
            // identical NOZZLE: line below - target_temperature is a
            // uint16_t set directly from CAN bytes (0x130), and this
            // doesn't touch the real value (Control_SolderingIron_PID's
            // own 450C safety ceiling already corrects that within 20ms).
            uint16_t display_target_temp = (target_temperature > 999) ? 999 : target_temperature;
            tp = append_str(txt, "TEMP: ");
            tp += fmt_uint(txt+tp, current_temperature, 3);
            tp += append_str(txt+tp, "/");
            tp += fmt_uint(txt+tp, display_target_temp, 3);
            tp += append_str(txt+tp, " C");
            txt[tp] = 0;
            // Page 4 was the only page left unused on this screen (tool
            // name/divider above at 2-3, temp text/endstop/bar below at
            // 5-7) - a 60s-ish rolling trend of current_temperature, not
            // just its instantaneous value.
            OLED_DrawTempSparkline(4, 5, 85, current_temperature, 0, 450);
            OLED_PrintStr(5, 5, txt);
            OLED_PrintStr(6, 5, endstop_triggered ? "ENDSTOP: HIT  " : "ENDSTOP: OPEN ");
            OLED_DrawHorizontalBar(7, 5, 85, (uint8_t)((current_temperature * 100) / 450));
            OLED_DrawToolIcon(TOOL_SOLDERING_IRON);
            break;
        }
        case TOOL_PASTE_DISPENSER:
        case TOOL_LIQUID_DISPENSER:
        case TOOL_SCREWDRIVER:
        case TOOL_GRIPPER_GIMBAL:
        case TOOL_GRIPPER_NEMA:
        case TOOL_SMT_PICKPLACE:
        case TOOL_VACUUM_GRIPPER_LG: {
            __disable_irq();
            uint32_t steps_rem_snapshot = steps_remaining;
            uint32_t steps_total_snapshot = total_steps_setpoint;
            __enable_irq();
            if (steps_rem_snapshot > 0) {
                // Display-only clamp: steps_remaining comes straight from an
                // unvalidated 32-bit CAN payload with nothing capping it. A
                // very large value (up to 10 digits) would overflow this
                // line's ~17-character budget before the icon column at
                // pixel 108, corrupting it. Only the displayed copy is
                // clamped - the real steps_remaining below (used by the step
                // ISR) is untouched, so a genuinely long move still runs correctly.
                uint32_t steps_display = (steps_rem_snapshot > 99999) ? 99999 : steps_rem_snapshot;
                tp = append_str(txt, "STEPS REM: ");
                tp += fmt_uint(txt+tp, steps_display, 5);
                txt[tp] = 0;
                OLED_PrintStr(5, 5, txt);
                uint8_t pct;
                if (steps_total_snapshot > 0) {
                    // Clamped to [0,100] before the subtraction below, not
                    // just after - steps_total_snapshot and steps_rem_snapshot
                    // are only ever set together by the same command handler,
                    // so steps_rem_snapshot shouldn't exceed steps_total_snapshot,
                    // but clamping the raw fraction first (rather than trusting
                    // that invariant) avoids the uint8_t underflow that
                    // "100 - (fraction > 100)" would otherwise produce.
                    uint64_t frac = ((uint64_t)steps_rem_snapshot * 100) / steps_total_snapshot;
                    if (frac > 100) frac = 100;
                    pct = 100 - (uint8_t)frac;
                } else {
                    pct = 0;
                }
                OLED_DrawHorizontalBar(7, 5, 85, pct);
            } else {
                OLED_PrintStr(5, 5, "STATUS: READY");
                OLED_DrawHorizontalBar(7, 5, 85, 100);
            }
            OLED_DrawToolIcon(active_tool); // each of the 5 tools' own icon
            break;
        }
        case TOOL_VACUUM_PICKUP:
            tp = append_str(txt, "VACUUM ADC: ");
            tp += fmt_uint(txt+tp, sensor_analog_reading, 3);
            txt[tp] = 0;
            OLED_PrintStr(5, 5, txt);
            tp = append_str(txt, "OBJ: ");
            tp += append_str(txt+tp, (sensor_digital_reading) ? "OK" : "FILL");
            txt[tp] = 0;
            OLED_PrintStr(7, 5, txt);
            OLED_DrawToolIcon(TOOL_VACUUM_PICKUP);
            break;
        case TOOL_DRILL:
            tp = append_str(txt, "REAL RPM: ");
            tp += fmt_uint(txt+tp, drill_actual_rpm, 5);
            txt[tp] = 0;
            OLED_PrintStr(5, 5, txt);
            OLED_PrintStr(6, 5, endstop_triggered ? "ENDSTOP: HIT  " : "ENDSTOP: OPEN ");
            tp = append_str(txt, "SETPOINT: ");
            tp += fmt_uint(txt+tp, drill_speed, 3);
            tp += append_str(txt+tp, "%");
            txt[tp] = 0;
            OLED_PrintStr(7, 5, txt);
            OLED_DrawToolIcon(TOOL_DRILL);
            break;
        case TOOL_LASER_ENGRAVER:
            tp = append_str(txt, "POWER:    ");
            tp += fmt_uint(txt+tp, laser_power_setpoint, 3);
            tp += append_str(txt+tp, "%");
            txt[tp] = 0;
            OLED_PrintStr(5, 5, txt);
            OLED_PrintStr(6, 5, endstop_triggered ? "ENDSTOP: HIT  " : "ENDSTOP: OPEN ");
            OLED_DrawHorizontalBar(7, 5, 85, (uint8_t)((laser_power_setpoint * 100) / 255));
            OLED_DrawToolIcon(TOOL_LASER_ENGRAVER);
            break;
        case TOOL_3D_PRINTER: {
            // Defensive clamp for display purposes only - doesn't touch
            // the real target_temperature (Control_SolderingIron_PID's own
            // 450C safety ceiling already corrects that within 20ms of a
            // bad value arriving). This just protects THIS fixed-width
            // line from the brief window before that correction lands,
            // since target_temperature is a uint16_t set directly from
            // CAN bytes and could otherwise be far more than 3 digits.
            uint16_t display_target_temp = (target_temperature > 999) ? 999 : target_temperature;
            tp = append_str(txt, "NOZZLE:");
            tp += fmt_uint(txt+tp, current_temperature, 3);
            tp += append_str(txt+tp, "/");
            tp += fmt_uint(txt+tp, display_target_temp, 3);
            tp += append_str(txt+tp, "C");
            txt[tp] = 0;
            OLED_PrintStr(5, 5, txt);
            tp = append_str(txt, "LFAN:");
            tp += fmt_uint(txt+tp, ((uint32_t)layer_fan_duty * 100u) / 255u, 3);
            tp += append_str(txt+tp, "%");
            tp += fmt_uint(txt+tp, layer_fan_actual_rpm, 4);
            tp += append_str(txt+tp, "RPM");
            txt[tp] = 0;
            OLED_PrintStr(6, 5, txt);
            tp = append_str(txt, "HFAN:");
            tp += fmt_uint(txt+tp, ((uint32_t)hotend_fan_duty * 100u) / 255u, 3);
            tp += append_str(txt+tp, "%");
            tp += fmt_uint(txt+tp, hotend_fan_actual_rpm, 4);
            tp += append_str(txt+tp, "RPM");
            txt[tp] = 0;
            OLED_PrintStr(7, 5, txt);
            OLED_DrawToolIcon(TOOL_3D_PRINTER);
            break;
        }
        case TOOL_AOI_INSPECTION: {
            const char* mode_text = (aoi_mode == 0x01) ? "LIGHT: FIXED  " :
                                   (aoi_mode == 0x02) ? "LIGHT: STROBE " :
                                                         "LIGHT: OFF    ";
            OLED_PrintStr(5, 5, mode_text);
            OLED_PrintStr(6, 5, endstop_triggered ? "ENDSTOP: HIT  " : "ENDSTOP: OPEN ");
            tp = append_str(txt, "PERIOD: ");
            tp += fmt_uint(txt+tp, aoi_strobe_period, 4);
            txt[tp] = 0;
            OLED_PrintStr(7, 5, txt);
            OLED_DrawToolIcon(TOOL_AOI_INSPECTION);
            break;
        }
        case TOOL_SCAN_PROBE:
            OLED_PrintStr(5, 5, "STATUS: ARMED ");
            tp = append_str(txt, "IMPACTS:  ");
            // Display-only clamp, same reasoning as the other
            // probe_impact_counter display above: a uint32_t with no cap
            // anywhere could otherwise write more digits than this
            // 24-byte buffer has room for. The real counter is untouched.
            tp += fmt_uint(txt+tp, (probe_impact_counter > 99999) ? 99999 : probe_impact_counter, 5);
            txt[tp] = 0;
            OLED_PrintStr(7, 5, txt);
            OLED_DrawToolIcon(TOOL_SCAN_PROBE);
            break;
        default:
            OLED_PrintStr(5, 10, "BUS CAN ONLINE");
            break;
    }
}
