JuanenRac/URTC/src/F303-master/firmware_can_thermalinspection.c

// =============================================================================
// URTC Firmware - CAN command handler: PCB Advanced Inspection
// (0x250-0x255, MLX9064x access - direct (any of the 3 family members)
// or via the expansion slave bridge, depending on which board variant
// and sensor variant is configured)
// Copyright (C) 2026 JuanenRac (Electro Hobby 3D) <electrohobby3d@gmail.com>
// GPL-3.0-or-later - see LICENSE
//
// This tool's own thermal imaging spots PCB shorts by temperature
// signature. Ring-LED illumination isn't handled here - it's the same
// generic ring-LED control every tool already has via 0x100, nothing
// thermal-inspection-specific about it.
//
// Same dual-path reasoning as firmware_can_flyingprobe.c's own ADS1115
// access: a host talks to the same 0x250-0x255 IDs regardless of which
// board variant is actually populated.
//
//   expansion_board_type==6 (Basic+MLX9064x): the sensor is wired
//   directly onto this board's own bit-banged I2C bus, no slave MCU
//   involved. mlx_sensor_variant decides which of the 3 family members
//   is actually behind it - all 3 have direct-path support here.
//   MLX_VARIANT_NONE (the safe default, no sensor configured yet)
//   deliberately answers nothing at all on this path - guessing which
//   real sensor might be there and reading garbage from it would be
//   worse than a host simply seeing no response.
//
//   expansion_board_type==3 or 4 (either Advanced variant): the sensor
//   lives on the expansion slave chip's own LOCAL sensor bus, relayed
//   over firmware_can_slavebridge.c's own I2C bridge - the slave chip's
//   own generic MLX_* dispatch (slave_i2c_sensors.c) picks the right
//   sensor there, this board doesn't need to know which.
//
// The one real complication this tool has that no other advanced-board
// tool does: a pixel chunk is 32 bytes, which doesn't fit in one CAN
// frame's own 8-byte ceiling the way every other advanced-board
// register here does - so a single chunk request gets answered across
// 4 consecutive CAN frames on the same response ID (same convention
// this project's own bootloader HMAC chunk transfer already
// established: 4 frames of 8 bytes, concatenated in the order
// received). Applies identically across every path above - only where
// the 32 bytes actually come from differs.
// =============================================================================
#include "firmware_common.h"
#include "firmware_can_thermalinspection.h"
#include "firmware_expansion_i2c.h"
#include "melexis_mlx90640/firmware_mlx90640_app.h"
#include "melexis_mlx90641/firmware_mlx90641_app.h"
#include "melexis_mlx90642/firmware_mlx90642_app.h"
#include "urtc_can_ids.h"

#define REG_APP_MLX_TRIGGER_CAPTURE  0x10
#define REG_APP_MLX_CAPTURE_STATUS   0x11
#define REG_APP_MLX_RAW_CHUNK        0x12
#define REG_APP_MLX_CALIBRATED_CHUNK 0x13

static void SendChunkFrames(uint32_t id, const uint8_t *data32) {
    for (uint8_t frame = 0; frame < 4; frame++) {
        if (HAL_CAN_GetTxMailboxesFreeLevel(&hcan) == 0) return; // stop rather than send an out-of-order remainder if mailboxes run out mid-transfer - a host seeing fewer than 4 frames for this request already knows to treat it as incomplete, same as it would a dropped CAN frame from any other cause
        CAN_TxHeaderTypeDef txH;
        txH.StdId = id;
        txH.IDE = CAN_ID_STD;
        txH.RTR = CAN_RTR_DATA;
        txH.DLC = 8;
        txH.TransmitGlobalTime = DISABLE;
        uint32_t mb;
        HAL_CAN_AddTxMessage(&hcan, &txH, (uint8_t*)&data32[frame * 8], &mb);
    }
}

// The sensor whose capture was requested over CAN and has not finished (0: none). Set in the receive interrupt, cleared by ThermalInspection_Service when the
// capture is over, so a status query sees BUSY from the request until the driver reports its own result.
static volatile uint8_t thermal_capture_pending = 0;

void ThermalInspection_Service(void) {
    const uint8_t variant = thermal_capture_pending;
    if (variant == 0) return;
    HAL_IWDG_Refresh(&hiwdg);   // the capture is long: it starts with the whole watchdog period in front of it
    if (variant == MLX_VARIANT_90640) {
        MLX90640_Direct_TriggerCapture();
    } else if (variant == MLX_VARIANT_90641) {
        MLX90641_Direct_TriggerCapture();
    } else if (variant == MLX_VARIANT_90642) {
        MLX90642_Direct_TriggerCapture();
    }
    thermal_capture_pending = 0;
}

void Handle_CAN_ThermalInspection(void) {
    if (rxHeader.StdId == URTC_CAN_ID_THERMAL_TRIGGER && !boot_sequence_active) {
        if (expansion_board_type == 6 && (mlx_sensor_variant == MLX_VARIANT_90640 || mlx_sensor_variant == MLX_VARIANT_90641 || mlx_sensor_variant == MLX_VARIANT_90642)) {
            if (thermal_capture_pending == 0) thermal_capture_pending = mlx_sensor_variant;   // a trigger while one is running is not queued twice
        } else if (expansion_board_type != 6) {
            ExpansionI2C_AppWriteRegister(REG_APP_MLX_TRIGGER_CAPTURE, rxData, 0);
        }
        // expansion_board_type==6 && mlx_sensor_variant==MLX_VARIANT_NONE:
        // no sensor configured, deliberately does nothing - see this
        // file's own header comment.

    } else if (rxHeader.StdId == URTC_CAN_ID_THERMAL_STATUS) {
        uint8_t status = 0;
        uint8_t got_status = 0;
        if (expansion_board_type == 6 && thermal_capture_pending != 0) {
            status = MLX_CAPTURE_BUSY;    // requested over CAN, not finished: the main loop has it
            got_status = 1;
        } else if (expansion_board_type == 6 && mlx_sensor_variant == MLX_VARIANT_90640) {
            status = MLX90640_Direct_GetCaptureStatus();
            got_status = 1;
        } else if (expansion_board_type == 6 && mlx_sensor_variant == MLX_VARIANT_90641) {
            status = MLX90641_Direct_GetCaptureStatus();
            got_status = 1;
        } else if (expansion_board_type == 6 && mlx_sensor_variant == MLX_VARIANT_90642) {
            status = MLX90642_Direct_GetCaptureStatus();
            got_status = 1;
        } else if (expansion_board_type == 6) {
            // MLX_VARIANT_NONE: answer explicitly with MLX_CAPTURE_ERROR
            // rather than staying silent here - unlike the trigger/chunk
            // requests above, a status query is expected to always get
            // an answer, so a host polling this can tell "no sensor
            // configured" apart from "board not responding at all".
            status = MLX_CAPTURE_ERROR;
            got_status = 1;
        } else {
            got_status = ExpansionI2C_AppReadRegister(REG_APP_MLX_CAPTURE_STATUS, &status, 1);
        }
        if (got_status && HAL_CAN_GetTxMailboxesFreeLevel(&hcan) > 0) {
            CAN_TxHeaderTypeDef txH;
            txH.StdId = URTC_CAN_ID_THERMAL_STATUS;
            txH.IDE = CAN_ID_STD;
            txH.RTR = CAN_RTR_DATA;
            txH.DLC = 1;
            txH.TransmitGlobalTime = DISABLE;
            uint32_t mb;
            HAL_CAN_AddTxMessage(&hcan, &txH, &status, &mb);
        }

    } else if (rxHeader.StdId == URTC_CAN_ID_THERMAL_RAW_CHUNK_REQ && rxHeader.DLC >= 1) {
        uint8_t chunk[32];
        if (expansion_board_type == 6 && mlx_sensor_variant == MLX_VARIANT_90640) {
            MLX90640_Direct_GetRawChunk(rxData[0], chunk);
            SendChunkFrames(URTC_CAN_ID_THERMAL_RAW_CHUNK, chunk);
        } else if (expansion_board_type == 6 && mlx_sensor_variant == MLX_VARIANT_90641) {
            MLX90641_Direct_GetRawChunk(rxData[0], chunk);
            SendChunkFrames(URTC_CAN_ID_THERMAL_RAW_CHUNK, chunk);
        } else if (expansion_board_type == 6 && mlx_sensor_variant == MLX_VARIANT_90642) {
            MLX90642_Direct_GetRawChunk(rxData[0], chunk);
            SendChunkFrames(URTC_CAN_ID_THERMAL_RAW_CHUNK, chunk);
        } else if (expansion_board_type != 6 && ExpansionI2C_AppReadRegisterWithParam(REG_APP_MLX_RAW_CHUNK, rxData[0], chunk, 32)) {
            SendChunkFrames(URTC_CAN_ID_THERMAL_RAW_CHUNK, chunk);
        }
        // expansion_board_type==6 && MLX_VARIANT_NONE: no response, same
        // reasoning as the trigger command above.

    } else if (rxHeader.StdId == URTC_CAN_ID_THERMAL_CAL_CHUNK_REQ && rxHeader.DLC >= 1) {
        uint8_t chunk[32];
        if (expansion_board_type == 6 && mlx_sensor_variant == MLX_VARIANT_90640) {
            MLX90640_Direct_GetCalibratedChunk(rxData[0], chunk);
            SendChunkFrames(URTC_CAN_ID_THERMAL_CAL_CHUNK, chunk);
        } else if (expansion_board_type == 6 && mlx_sensor_variant == MLX_VARIANT_90641) {
            MLX90641_Direct_GetCalibratedChunk(rxData[0], chunk);
            SendChunkFrames(URTC_CAN_ID_THERMAL_CAL_CHUNK, chunk);
        } else if (expansion_board_type == 6 && mlx_sensor_variant == MLX_VARIANT_90642) {
            MLX90642_Direct_GetCalibratedChunk(rxData[0], chunk);
            SendChunkFrames(URTC_CAN_ID_THERMAL_CAL_CHUNK, chunk);
        } else if (expansion_board_type != 6 && ExpansionI2C_AppReadRegisterWithParam(REG_APP_MLX_CALIBRATED_CHUNK, rxData[0], chunk, 32)) {
            SendChunkFrames(URTC_CAN_ID_THERMAL_CAL_CHUNK, chunk);
        }
        // expansion_board_type==6 && MLX_VARIANT_NONE: no response, same
        // reasoning as the trigger command above.
    }
}
