JuanenRac/URTC/(commit log)

2026-09-10 Add host logic tests for the MLX9064x sensor API (A.10)
    The Melexis MLX90640_API.c is portable C - it never includes the STM32
    HAL - so this project's own additions to it can be exercised on the host
    with plain gcc against a fake I2C driver, no F303 board needed:
    - tests/test_mlx90640_api.c, tests/fake_mlx90640_i2c.c[.h],
    tests/test_runner.h - 8 assertions covering the bounded data-ready
    polling (SynchFrame / GetFrameData return DATA_READY_TIMEOUT_ERROR
    after a bounded number of reads on a stuck bus, never spin), I2C
    error propagation, frame-word validation, DumpEE, GetSubPageNumber.
    - build_firmware.sh gains step 1b, running these with the host cc
    (skipped cleanly when no host co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
2026-09-11 MLX90640_ExtractParameters: bound the scale-normalisation loops (A.10)
    The vendor while (temp < K) { temp *= 2; scale++; } loops in
    ExtractAlphaParameters / ExtractKtaPixelParameters / ExtractKvPixel-
    Parameters never terminated when temp == 0 - every value in a corrupt or
    unpopulated DumpEE reads as 0, and 0*2 stays below the threshold forever,
    so a bad read at sensor bring-up hung the F303 the same way the
    data-ready polling used to before it was bounded.
    - new MLX90640_SCALE_ITER_MAX (64) caps each loop far past any real
    calibration EEPROM's own convergence (< 20 steps), so the maths is
    byte-identical for a real sensor; a garbage dump falls through with
    zeroed params and ExtractDev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
2026-09-11 A.12: implement black-box CAN readback (0x1A8/0x1A9)
    The F-RAM fault-recorder capture mechanism (firmware_blackbox.c) shipped
    earlier with readback deliberately left for a separate pass. This adds
    it: a new global command pair 0x1A8 (request) / 0x1A9 (response), wired
    into firmware_can_global_pre.c right after the existing 0x1A6/0x1A7
    sensor-variant query since a recorded fault can be read back regardless
    of the currently active tool.
    rxData[0] selects one 32-byte chunk of the ~678-byte flushed
    BlackBoxRecord_t (BLACKBOX_CHUNK_COUNT=22, computed at compile time from
    sizeof), answered as 4 consecutive 8-byte CAN frames on 0x1A9 - the same
    chunked-transfer convention firmware_can_thermalinspe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
2026-09-13 Fix README stale v0.2/v0.2.9 references against the real v0.3.0 release
    - The README (all 7 languages) still titled itself "(v0.2)" and
    referenced URTC_MAIN_FIRMWARE_v0.2.9.* in its flashing walkthrough -
    both stale against firmware_common.h's own real FIRMWARE_VERSION_*
    (0.3.0) and this project's own manifest. Corrected to (v0.3) and
    URTC_MAIN_FIRMWARE_v0.3.0.*, verified against a real
    arm-none-eabi-gcc build-test run before writing the fix.
2026-09-18 Add real host-native test harness for the general CAN dispatch table
    tests/ previously covered the MLX90640 sensor API on host but nothing
    exercised the tool-ID -> handler routing table in
    firmware_can_dispatch.c - a mistake there (a tool silently routed to
    the wrong handler) had nothing to catch it before real hardware.
    Extracted the routing decision into a pure, HAL-free function
    (firmware_can_dispatch_routing.c/.h) with identical behavior; the real
    ISR switch now calls through it. A _Static_assert block keeps its
    hardcoded tool-ID literals honest against the real ToolMode_t enum.
    New tests/test_can_dispatch_routing.c drives all 26 real tool IDs plus
    unassigned ones, wired into build_firmw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
2026-09-19 docs: reference the new HYDRA-UMC-EDITOR-STL project (all 7 languages)
2026-09-27 Manifiesto propio urtc.project.json (ecosystem: URTC), ya no hydra-umc.project.json
    Cada ecosistema (HYDRA-UMC/URTC/A.R.M.O.R.) va a tener su propio updater
    dedicado; este repo deja de aparecer en el descubrimiento de
    HYDRA-UMC-UPDATER (ya no publica hydra-umc.project.json) para aparecer
    en el de URTC-UPDATER en su lugar. Herramientas propias (ci_validate.py,
    bump_manifest_version.py, bump_version.py, build_test.py, scripts de
    build, README/CHANGELOG) actualizadas al nuevo nombre de fichero y a
    'ecosystem: URTC'.
2026-10-11 Thermal runaway guard, signing keys out of the tools, reset cause (v0.3.2)
    - thermal_guard.c/.h: thermal runaway protection (MAXTEMP on the measured
    temperature, heating watch and holding check) for the T12/hot-air iron and
    the 3D hotend; a fault cuts the heater, latches system_error_flag and
    records thermal_fault_code. tests/test_thermal_guard.c drives it with a
    simulated plant and runs in the build.
    - 0x111 grows to DLC 6: byte 4 thermal fault code, byte 5 last reset cause
    (bit0 = IWDG). Black box: thermal code in flags bits 2-3.
    - Signing: the bootloaders' HMAC key is injected at build time from
    URTC_SIGNING_KEY_FILE (firmware_signing.py); without it the public
    development k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
2026-10-11 Lifetime thermal counters, hardened slave MLX drivers, CAN threat model (v0.3.3)
    - thermal_stats.c/.h + firmware_thermal_stats.c: thermal faults ever
    latched, last fault code and total heater-on time in their own CRC-8
    F-RAM record (address 192, SavedState_t untouched); CAN 0x1AA -> 0x1AB.
    tests/test_thermal_stats.c runs in build step 1b.
    - The slave's MLX90640/MLX90641 drivers now match the main board's
    hardened copies (bounded data-ready wait, scale-loop cap);
    check_shared_drivers.py (build step 1c) keeps them identical.
    - docs/CAN_THREAT_MODEL.TXT: bus capabilities and installation
    requirements (hardware interlock, closed bus, private signing key);
    linked from SECURITY.md.
    -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
2026-10-17 Send the firmware PATCH number over CAN and publish firmware only as release assets (0.3.5)
    The patch travels in three additive places so released flashers keep working: a companion frame 0x7E9 after 0x7F9, the high byte of the minor field of the end-of-update frames, and a longer slave version answer. Anti-rollback compares the patch only when both versions carry one.
    Firmware binaries, hex, elf, checksums and manifests are no longer versioned; build_firmware writes them to the ignored firmware folder (build/firmware in CI) and tools/publish_release_assets.py lists what to attach to the GitHub release.
2026-10-18 Add host tests for the bootloader update flow, HMAC and pre-error-gate CAN commands
    Compile the bootloader sources and firmware_can_global_pre.c unchanged against a fake HAL with a 256 KiB fake flash, and run them in the host test step under the address and undefined sanitizers.
2026-10-18 Scripts: batch pauses skip the prompt in CI (CI / HYDRA_UMC_CI); add missing shebang; pin LF for .sh and CRLF for .bat in .gitattributes
2026-10-18 Add an explicit bump command and make builds leave the versions alone, declare manifest schema 1.1 with the four firmware components, use GPL-3.0-or-later (0.3.7)
    - build_firmware.sh and build_firmware.bat only read the component versions; bump.py raises all four or the named ones (--dry-run, --list) and keeps urtc.project.json in step. bump_version.py gained a read-only --current mode.
    - urtc.project.json uses schema 1.1 with deployment target mcu and components[] for the main and slave application and bootloader; ci_validate checks each declared version against its header.
    - Licence statements and source headers say GPL-3.0-or-later.
2026-10-19 Implement several tool heads on one CAN bus in the main firmware behind a persistent switch that is off by default (0.3.8)
    Node address from the ID jumpers, discovery, SELECT with a lapse, per-node status, SAFE_STOP, address-conflict detection and a read-only NODE_CMD. A node that is not selected obeys no single-head frame, sends no single-head telemetry and never actuates. The switch is its own F-RAM record (address 960), set with 0x1AC and read with 0x1AD, read once at boot; a blank, erased or damaged record reads as off and with the switch off the receive path is the single-head path. New host suite tests/test_multinode.c; host tests only, not tried on boards.
2026-10-19 README: refresh the At a glance section to the current versions
2026-10-22 Show the current version in the READMEs
2026-10-22 Add optional firmware functions behind switches, a virtual board with a fuzzer, a key registry and a compatibility table in release notes
    - Four functions that are off by default and are switched with 0x1AE (read with 0x1AF), acting after the next power-up: ramps for the stepper (trapezoid and S-curve plans), a health frame once a second, a trim of the internal oscillator and a heater PID with anti-windup and relay autotune. Their logic is tested on the host; the step timer, the analogue channels and the oscillator measurement still need a bench.
    - tests/virtual_board.c runs the real receive path behind an SLCAN-style text port with the address and undefined-behaviour sanitizers, and tools/f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
2026-10-23 Host-test the tool handlers, the heater loops, the fault recorder and the tool identification, with a coverage floor
2026-10-23 Copy of the shared code: take the current compatibility table
2026-10-23 Unknown tool: leave the stepper driver disabled, with one write on the shared enable pin
2026-10-23 Bootloader display: draw text at the requested column, fill the progress bar to the frame and give the small font a real zero
2026-10-23 Bootloader: answer the readback and the downgrade authorisation only in a session that the bootloader entry started
    The application leaves a mark in a backup register when it accepts 0x7F0; the bootloader reads and clears it at start-up and ignores 0x7FE and 0x7FD in any other session while an application is installed. A board with no valid application keeps both for its recovery, and a build option switches the restriction off.
2026-10-23 Expansion slave: send the application patch number in the reserved tenth byte of the version register, and let the master pass it on
    The master reads the whole version register for 0x221 and, when the tenth byte is a patch number (1 to 127), follows the unchanged answer with a 0x222 companion frame. A byte of 0, what an older slave application sends, is ignored.
2026-10-23 Document the bootloader session rule and the slave patch number, refresh the shared vectors with the new companion identifier
    CANBUS.TXT and the threat model describe the session in which 0x7FE and 0x7FD are answered and the 0x222 companion frame; the threat model gains a section on several heads on one bus.
2026-10-24 Send the low byte of the slave minor number in a third byte of the 0x222 companion frame
2026-10-24 Take the current README parity check, which also checks the file tree
2026-10-30 Ignore extended and remote CAN frames in the command dispatcher
    Only a standard data frame is dispatched, so a frame of another type can no longer repeat the previous command with the identifier the HAL left behind; a host test covers an extended frame and a remote request.
2026-10-31 Document the CAN reply of the tool rack (0x261) and sync the shared header
    The head firmware does not answer 0x260 to 0x26F; the CAN reference now
    defines the rack reply (3 bytes: command answered, tool byte, reason) next to
    the pre-heat order, and the generated identifier header carries the rack
    section of the shared specification.
2026-11-01 Run the host suites through the shared executor with ctest, keep the suites as data and let the virtual board builder print the command that runs it
2026-11-01 Add the twin of the bootloader: the real bootloader of the master compiled for the host behind an SLCAN-style port, with a driver that flashes through it
2026-11-01 Pin ruff to the version the other families use, so one green run means a green run everywhere
2026-11-02 Follow the shared bootloader design: programmable serial number, default policy and the identifiers 0x7EA to 0x7ED
    The copies of the shared parts, their vectors and the CAN bus document are refreshed. The prose describes the addressing block and the key identifier, and says that 0x7FA is exactly the three bytes of the version.
2026-11-03 ci: pin actions by commit hash, owner-only manual build, draft release behind a protected environment
    - every action is pinned to a full commit hash
    - the build job set holds read-only repository access; the draft pre-release is a separate job in the release environment
    - the manual build only starts for the repository owner; the attestation check pins the signer workflow and the commit
    - checkouts keep no credentials; the nightly workflow gets issue write access only in the job that opens the issue
    - Dependabot waits seven days before proposing a new action version; CODEOWNERS covers the automation files
2026-11-03 Give the expansion slave bootloader a rollback counter of its own and remove its HMAC key and routine
    The metadata page of the slave becomes an append-only log (28 records of 72 bytes, as in the main bootloader) whose record carries the floor of the signed
    counter. The master reads the floor from the new register 0x0B before it starts, refuses a record below it and writes the counter of the verified record to
    0x0C before it relays END; the confirmation is now an 80-byte message that includes the counter. The slave refuses a counter below its floor even for a newer
    version and moves the floor in the record that marks the copy as pending.
    The HMAC key, the HMAC routine, the build flag, the sl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
2026-11-03 Fill the release trust table of the bootloaders with the public halves of the image-signing keys (current and next)
2026-11-04 Send the health information frame, take the slave bootloader numbers from the generated header and add an optional programmed serial
2026-11-04 Define the reset cause in the features test and check the identity frame
2026-11-04 Start the count of the identity frame at every initialisation
2026-11-04 Download the Arm toolchain with a pinned checksum in the build comparison, as the repository allows only the actions of GitHub
2026-11-05 Skip the host C suites and the virtual boards on a plain PC; CI or ALLOW_LOCAL_BUILD=1 builds
2026-11-05 Link the object files in the same case-insensitive order in the shell and the batch build scripts
2026-11-06 Add a host model of the expansion slave bootloader with power-cut scenarios and source-drift checks
2026-11-07 Refresh the shared CAN tables with the key rotation status frames
2026-11-07 Let the master bootloader take the signed key rotation command (off by default) and fix the slave bootloader link, window and interrupt work
2026-11-07 Fix the slave I2C clock order, RAM size and sensor start-up; run the thermal capture in the main loop; keep the hardware configuration in its own record
2026-11-07 Add opt-in slave write reassembly, CAN bit timing and crystal options, weld pulse limits with a hardware timer, and configurable I2C2 pins
2026-11-07 Add limit, cut and fixed-seed fuzz tests for the CAN bit timing, the weld pulse timing and the slave write reassembly
2026-11-07 Capture the registers of a HardFault in RAM that survives the reset and read them over CAN, behind a switch that is off by default
2026-11-07 Use the same Chinese and Japanese word for board as the application
2026-11-07 Replace the Spanish calques flashear, flasheo and bitrate with grabar and velocidad de bus
2026-11-08 Proofread the README translations: wording, terms, register and the Italian frame term
2026-11-12 Emit the image header inside the application images and seal it after the link
    Both application images now carry a 32-byte header at the fixed offset 0x200,
    after the vector table: the firmware emits the slot (hardware and version with
    four components), the linker scripts place it and fail the link if the vector
    table would not end before it, and tools/seal_image.py fills in the length and
    the CRC-32 of the whole image after the link and writes the Intel HEX again.
    The flash map, the vector table and the image length do not change, and the
    bootloaders are not touched.
    - tools/verify_image_records.py also checks the header inside a sealed image
    against the file name.
    - Three host test suit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
2026-11-12 Add a check byte to the application link of the expansion connector, off by default
2026-11-12 Route the slave application registers through one link switch and capture the thermal camera frame in small steps
    The master reaches the application registers of the expansion slave through
    ExpansionI2C_App* calls that are the checked calls when URTC_SLAVE_LINK_CRC=1
    and the plain ones otherwise; the build scripts pass the switch to both
    boards. The capture of the MLX90640/MLX90641 on the slave is a state machine
    (start, ready poll, read, calibrate) that does one joint per main-loop pass.
    Host suites, counters and structure picture updated.
2026-11-12 Compile both boards with the I2C link check byte on in the CI
2026-11-13 Declare the bus bit rate in the identity frame 0x1BB (protocol version 2) (#10)
    The master firmware sends the code of the bit rate it was built for in byte 5
    and keeps a 16-bit uptime that stops at 65535 s. Update the generated header,
    the CAN reference and the host tests.
2026-11-13 Say in the comment of the pulse tick that the hardware timer path exists (#11)
2026-11-13 Do not cut the output when a kick is newer than the clock read by the watchdog (#15)
2026-11-13 Do not write the F-RAM because the automatic colour of the status LED changed (#19)
    * Do not write the F-RAM because the automatic colour of the status LED changed
    * Make the test of the status LED colour independent of the rest of the saved state
2026-11-13 Divide the rpm of the drill and the fans by the real time between two readings (#17)
2026-11-13 Add notes for the next board revision (#28)
2026-11-13 chore: refresh the vendored URTC-COMMON copies (heater-only identifier layout) (#31)
2026-11-13 Add the clear-error command and the communication watchdog of the steppers and the electromagnet, both behind switches that are off (#40)
    The command 0x1B2 lifts a latched critical error without a power cycle once the tool is cool and every actuator is at zero; the quick state carries the reason of the error and the outcome of the last command. With the communication watchdog on, a stepper move is cut after the silence its length allows and, with the release policy also on, the electromagnet lets go after a long silence; with the policy off the coil is held. The decisions replay the shared vectors of the common repository.
2026-11-13 Heater-only frame of 2 bytes on the 3D printer head identifier (#39)
    * Accept the nozzle setpoint of the 3D printer head alone in a frame of 2 bytes
    * Count the pins the two-byte frame writes, not the ones the set-up wrote
    * Read the direction pin through the fake HAL in the heater-only test
2026-11-13 Count heater time only for the tools that heat with the output and change the record with the interrupts off (#23)
2026-11-13 Make the step timer of the head tick every millisecond exactly (#21)
2026-11-13 Add the metadata in two alternating pages behind a build switch (#38)
2026-11-13 Abort CAN transmit mailboxes only after a real bus-off; forbid waits in interrupt code (#37)
2026-11-14 Paint only the lines of the OLED that changed (#33)
    * Paint only the lines of the OLED that changed
    The display driver keeps a copy of each page and skips a write whose pixels
    are the same, which cuts the bus time of the main loop. The copy is trusted
    only after a full-page write and is dropped on start-up and after a failed
    transfer; a skipped write sends the cursor again before the next real one.
    * Clear the pages first in the second-pass test of the OLED render
2026-11-14 End the timed pulses of the expansion board by the clock and not by the passes of the main loop (#25)
2026-11-14 Saturate the open-loop position of the solder wire feeder instead of wrapping it (#16)
    * Saturate the open-loop position of the solder wire feeder instead of wrapping it
    * Link the position of the solder wire feeder into the weld-timer variant of the suite
2026-11-14 Let the bootloader go back to a valid application after a silence, behind a switch that is off by default (#24)
    * Let the bootloader go back to a valid application after a silence, behind a switch that is off by default
    * List the return-to-application suite among the options that are off by default
2026-11-14 CAN receive queue between the interrupt and the dispatcher (switch off by default) (#26)
    * Let the CAN receive interrupt only store the frame behind a switch that is off by default
    * List the receive-queue suite among the options that are off by default
2026-11-14 Answer the slave version query only when the slave is in its bootloader (#34)
    The query read ten bytes of a register that only the bootloader has. With the
    slave application running, the first byte is its idle status and the rest is
    not data, yet it was relayed as a version. The answer is now used only when
    it starts with the bootloader marker.
2026-11-14 Thermal guard watch restarts only on a big rise of the setpoint (#36)
    * Restart the thermal watch only when the setpoint rises by more than a margin
    * Test a big rise of the setpoint with a temperature far below it
2026-11-14 Add a transmit queue for the CAN frames behind a switch that is off by default (#48)
    Every handler put its frame straight into one of the three mailboxes, from the receive interrupt, the touch interrupt or the main loop, and the senders of several frames in a row gave up the rest of the answer when the third mailbox was busy. With URTC_CAN_TX_QUEUE=1 the send and the question about the free mailboxes go to a ring that the main loop empties in order. Adds its host suites, a test that keeps the interrupt handlers away from the shared buses, and the notes in the changelog and the firmware README.
2026-11-14 Let the expansion slave read both sub-pages of the MLX90640 behind a build option (#49)
    The slave took one frame per capture, so half of the image kept what an earlier capture had left. With URTC_SLAVE_MLX90640_TWO_SUBPAGES=1 the capture takes the frames it needs, at most four, and a camera that repeats one sub-page is an error. Off by default.
2026-11-14 Document the official firmware flow: compile in Actions, sign on the maintainer's machine (#53)
